kongshyun/2022Capstone-AGV/최종논문 및 보고서/최종 상위 노드통신.jpg

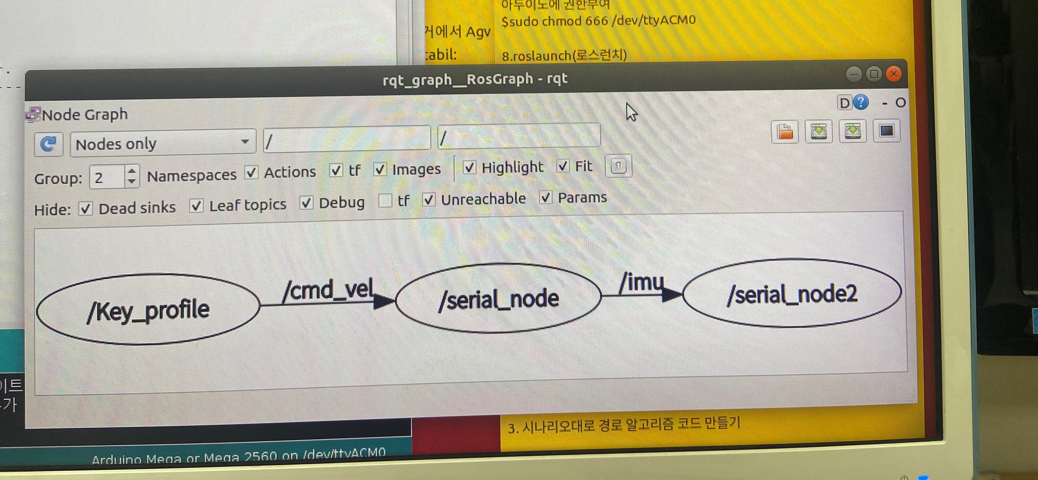
최종논문 및 보고서/최종 상위 노드통신.jpg
