kongshyun/2022Capstone-AGV/README.md

# ROS
1. 로봇운영체제 ROS용어정리
2. 로스 메시지 통신
3. 로스 아두이노 시리얼 통신
4. AGV구동 아두이노 코드
11
해야할것
AGV아두이노에서 imu 롤피치 값이랑 가속도프로파일값을 
다른아두이노로 publish해야  

////////////////////////////////////////////////////////////////////

4차 아두이노 코드 폴더 설명

▶ test1: 
3차때 발표한거에서 Agv DC모터돌리는 코드만 있음

▶ DC_PID_Stabil:
Stabil DC모터+ Imu  짐벌 코드

▶keysendtest: (11.01 성공확인)
practice2 패키지의 Key_profile.py 랑 rosserial되는 코드

▶ebimu_rosserial: (11.01 성공확인)
ebimu의 roll, pitch 두개의 값을 /imu토픽으로 publish 테스트 코드

▶ebimu_sub_tes: (11.01 성공확인) →Serial_node2
ebimu 값  roll, pitch값 subscribe 테스트 코드

▶Agv_imu_test1:  ( 11.01생성 )→Serial_node
Agv  DC모터와 ebimu값을 pub하는 테스트 1 코드

-----------------------------------------------------------------------------------------
roslaunch practice2 Agv_Stabil_key.launch
theta 값 pub하는거랑 Stabil코드 ros만 하면 됨!!!

-11월 1일

-----------------------------------------------------------------------------------------
