kongshyun/2022Capstone-AGV/최종논문 및 보고서, 참고자료/아두이노를 통한 서보모터 제어.pdf

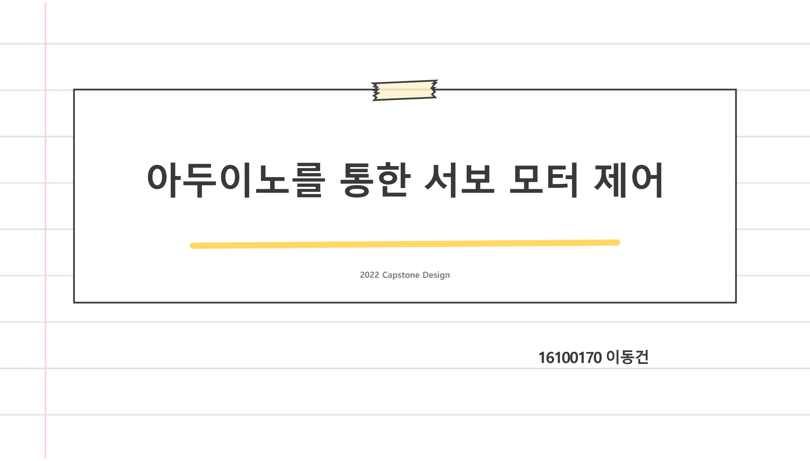
[picture p103: page 1]

# 아두이노를 통한 서보 모터 제어

2022 Capstone Design

16100170 이동건

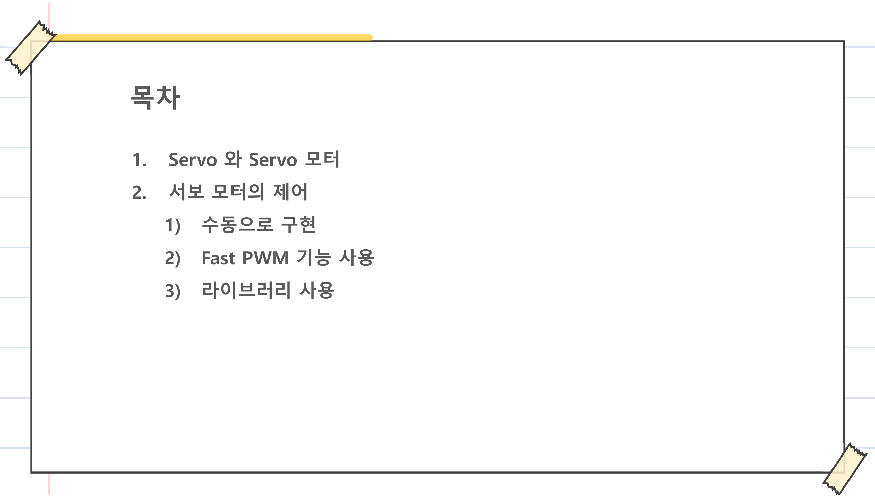
[picture p104: figure]
1. Servo 와 Servo 모터 2. 서보 모터의 제어; 1) 수동으로 구현; 2) Fast PWM 기능 사용 3) 라이브러리 사용

서보

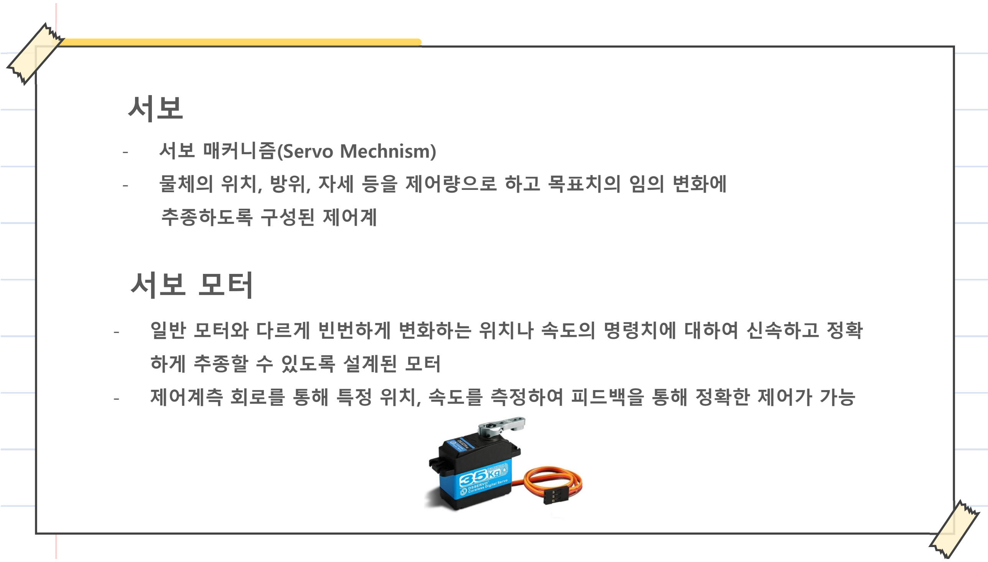
[picture p105: page 3]

추종하도록 구성된 제어계

-서보 매커니즘(Servo Mechnism) -물체의 위치, 방위, 자세 등을 제어량으로 하고 목표치의 임의 변화에

## 서보 모터 - 일반 모터와 다르게 빈번하게 변화하는 위치나 속도의 명령치에 대하여 신속하고 정확

하게 추종할 수 있도록 설계된 모터
- 제어계측 회로를 통해 특정 위치, 속도를 측정하여 피드백을 통해 정확한 제어가 가능

## PWM

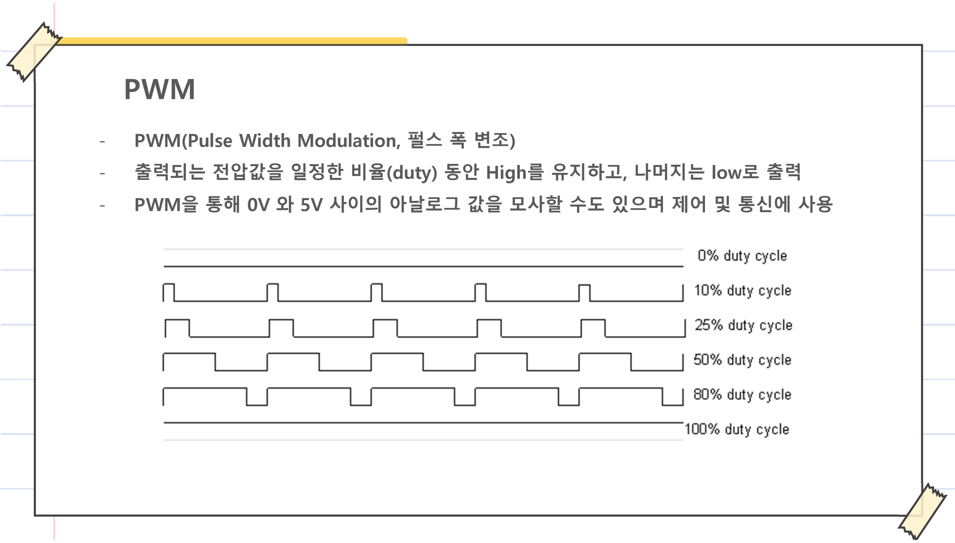
[picture p106: page 4]

-PWM(Pulse Width Modulation, 펄스 폭 변조) -출력되는 전압값을 일정한 비율(duty) 동안 High를 유지하고, 나머지는 low로 출력

- PWM을 통해 0V 와 5V 사이의 아날로그 값을 모사할 수도 있으며 제어 및 통신에 사용

## 서보 모터 제어

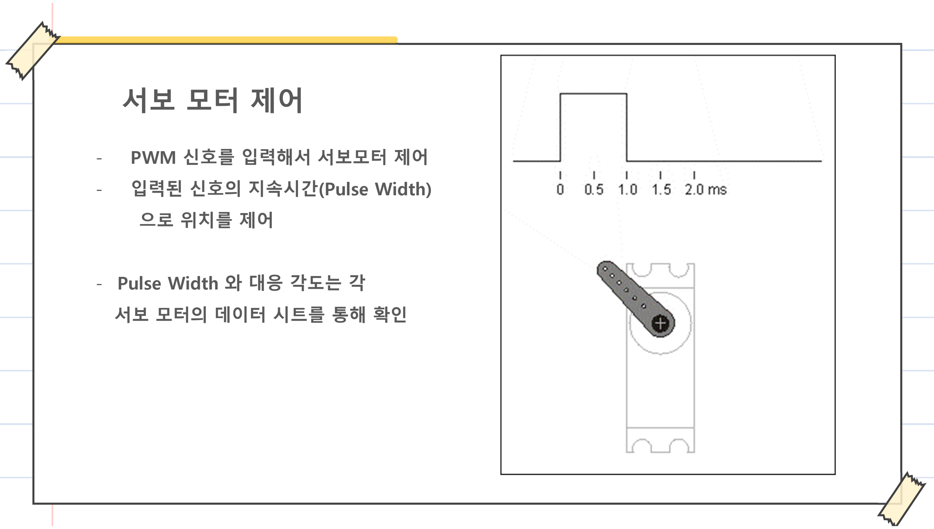
[picture p107: page 5]

- 입력된 신호의 지속시간(Pulse Width) 으로 위치를 제어
- Pulse Width 와 대응 각도는 각 서보 모터의 데이터 시트를 통해 확인
- PWM 신호를 입력해서 서보모터 제어

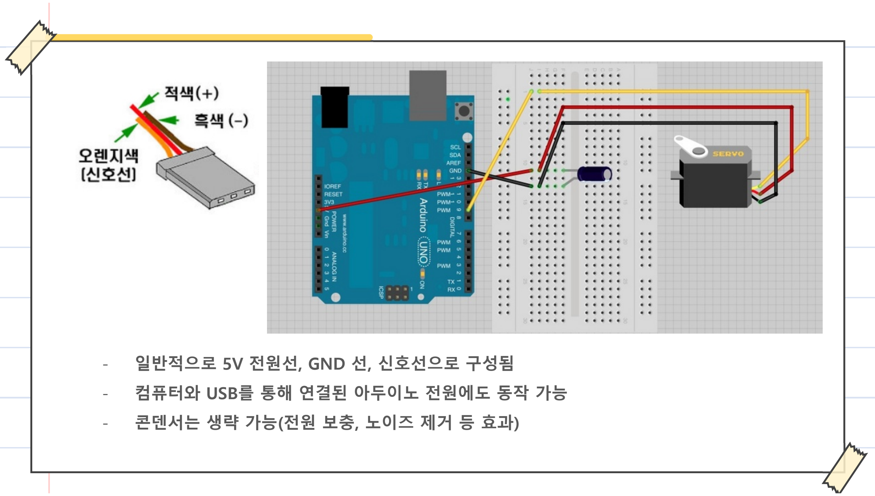
[picture p108: page 6]

- 일반적으로 5V 전원선, GND 선, 신호선으로 구성됨 - 컴퓨터와 USB를 통해 연결된 아두이노 전원에도 동작 가능
- 콘덴서는 생략 가능(전원 보충, 노이즈 제거 등 효과)

## 1. PWM 을 수동으로 구현

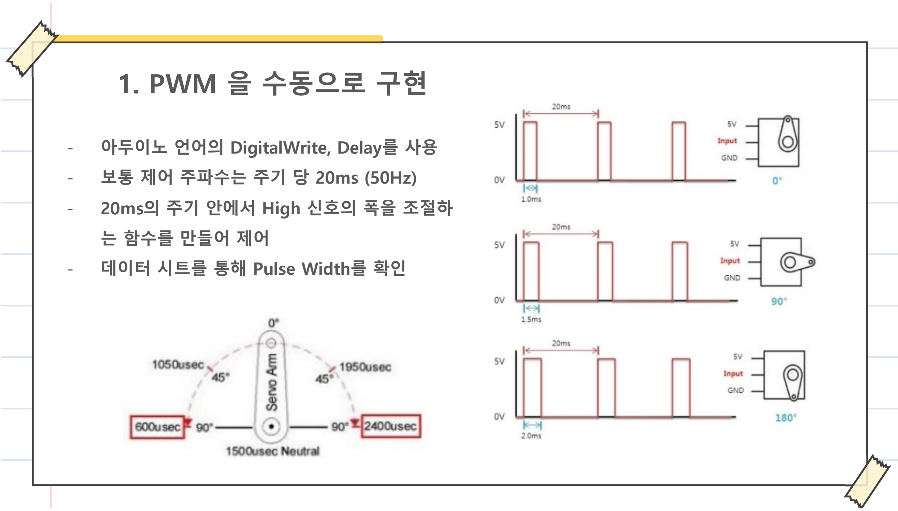
[picture p109: page 7]

- 아두이노 언어의 DigitalWrite, Delay를 사용

-보통 제어 주파수는 주기 당 20ms (50Hz) -20ms의 주기 안에서 High 신호의 폭을 조절하

는 함수를 만들어 제어

- 데이터 시트를 통해 Pulse Width를 확인

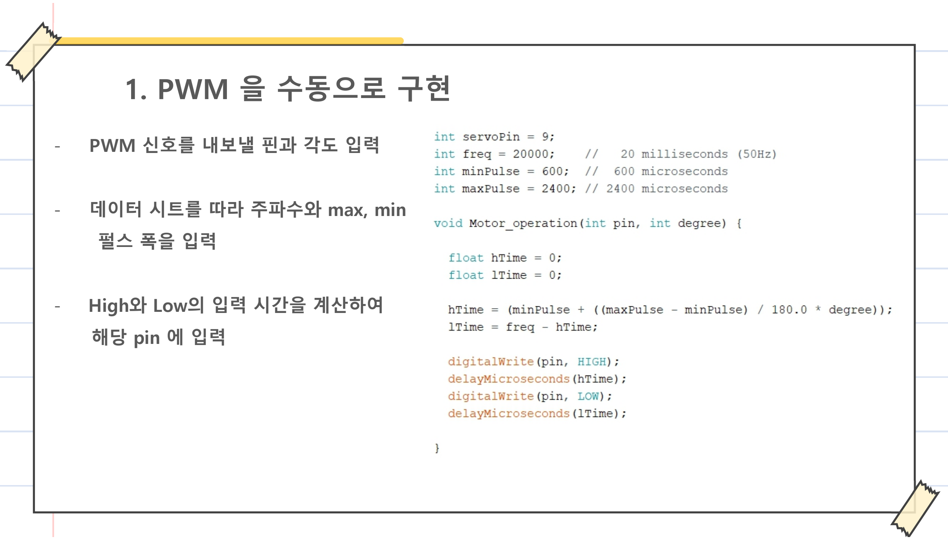
[picture p110: figure]
1. PWM 을 수동으로 구현; - PWM 신호를 내보낼 핀과 각도 입력; - 데이터 시트를 따라 주파수와 max, min; - High와 Low의 입력 시간을 계산하여; 해당 pin 에 입력

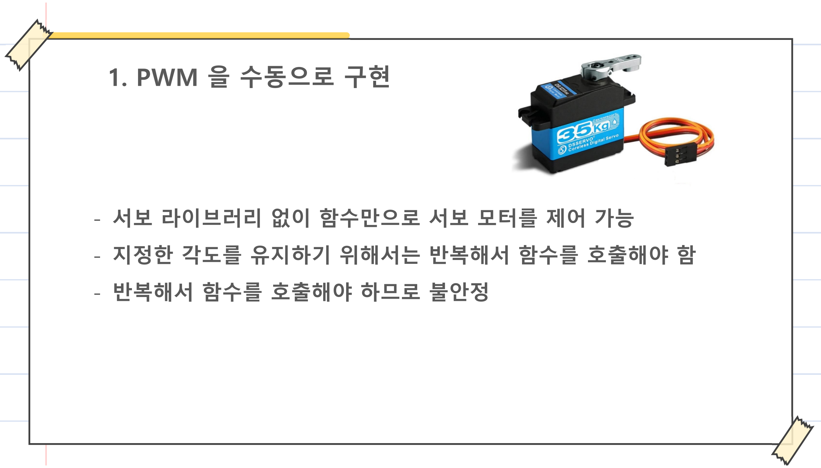
[picture p111: figure]
1. PWM 을 수동으로 구현; - 서보 라이브러리 없이 함수만으로 서보 모터를 제어 가능; - 지정한 각도를 유지하기 위해서는 반복해서 함수를 호출해야 함; - 반복해서 함수를 호출해야 하므로 불안정

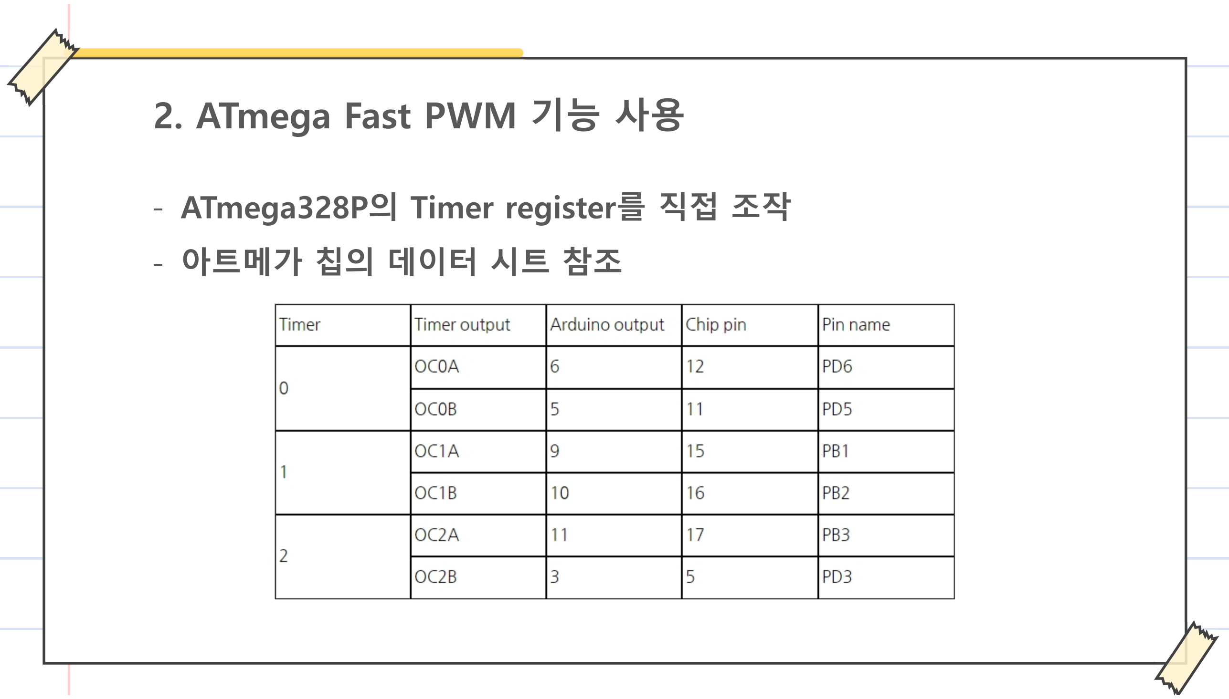
[picture p112: figure]
2. ATmega Fast PWM 기능 사용; - ATmega328P의 Timer register를 직접 조작; - 아트메가 칩의 데이터 시트 참조

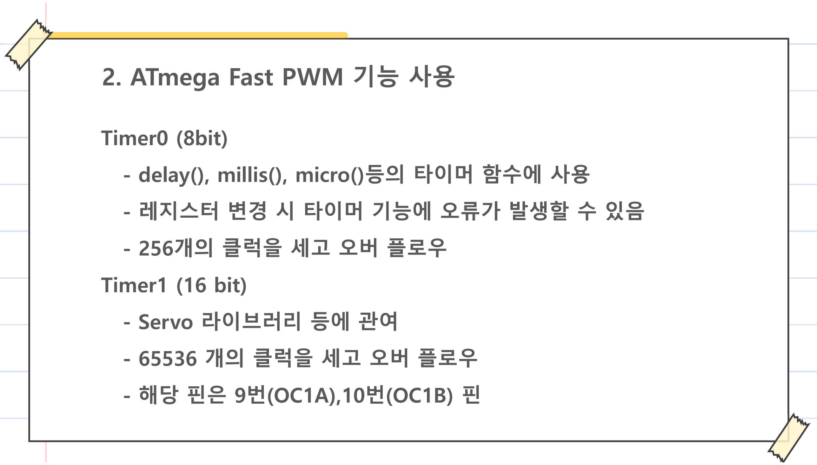
[picture p113: figure]
2. ATmega Fast PWM 기능 사용; - 레지스터 변경 시 타이머 기능에 오류가 발생할 수 있음; - 256개의 클럭을 세고 오버 플로우; Timer1 (16 bit) - Servo 라이브러리 등에 관여; - 65536 개의 클럭을 세고 오버 플로우

## Timer0 (8bit) - delay(), millis(), micro()등의 타이머 함수에 사용

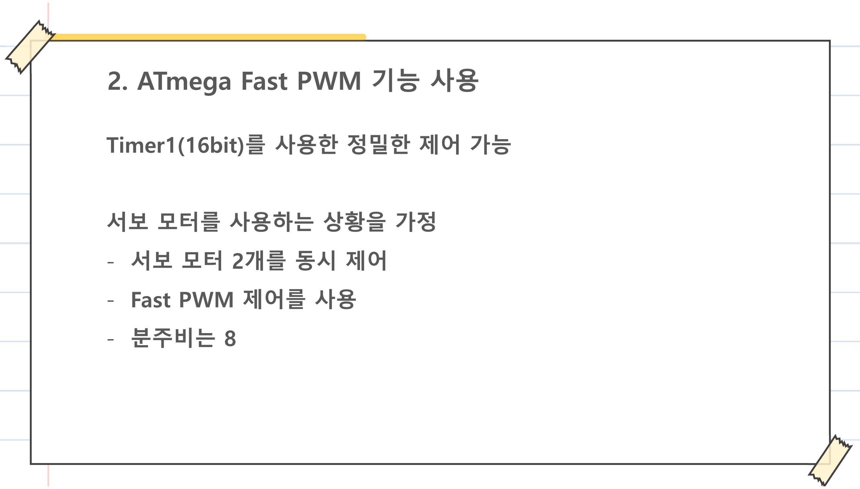
[picture p114: figure]
2. ATmega Fast PWM 기능 사용; Timer1(16bit)를 사용한 정밀한 제어 가능; 서보 모터를 사용하는 상황을 가정; - Fast PWM 제어를 사용 - 분주비는 8

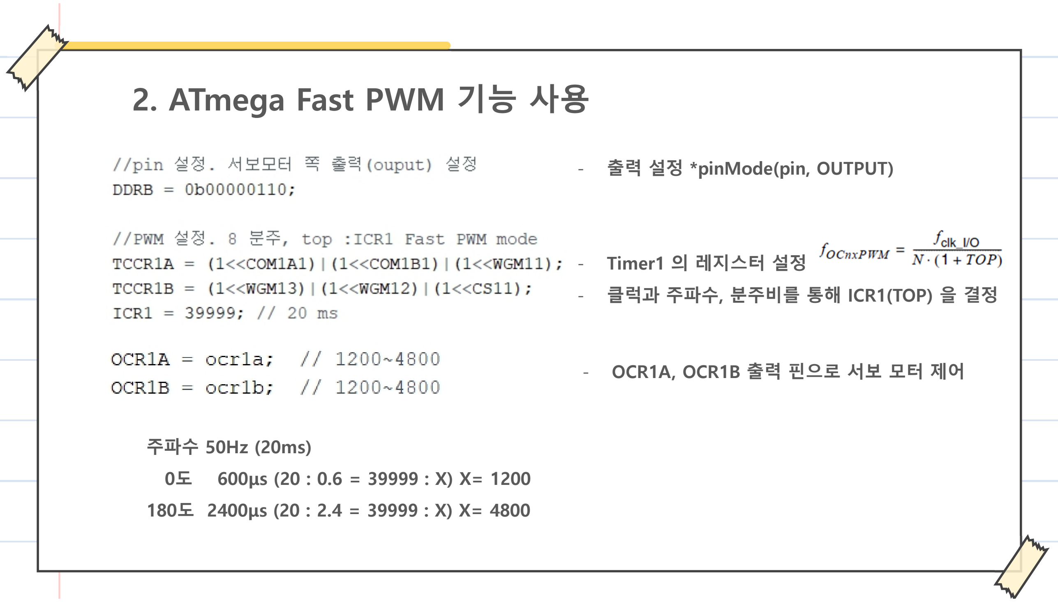
[picture p115: figure]
2. ATmega Fast PWM 기능 사용; - 출력 설정 *pinMode(pin, OUTPUT); - Timer1 의 레지스터 설정; - 클럭과 주파수, 분주비를 통해 ICR1(TOP) 을 결정; - OCR1A, OCR1B 출력 핀으로 서보 모터 제어

주파수 50Hz (20ms) 0도 600μs (20 : 0.6 = 39999 : X) X= 1200

180도 2400μs (20 : 2.4 = 39999 : X) X= 4800

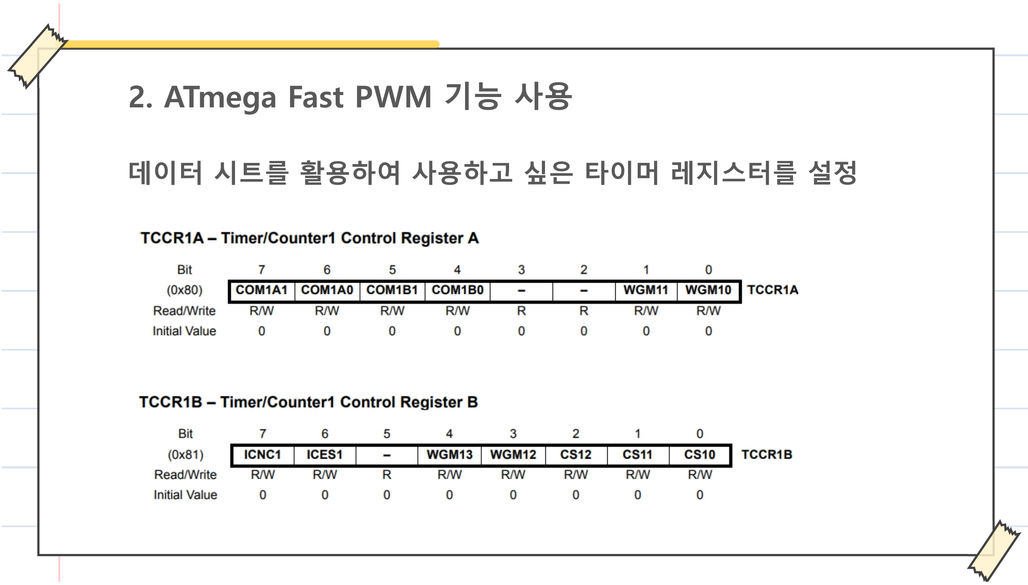
[picture p116: figure]
2. ATmega Fast PWM 기능 사용; 데이터 시트를 활용하여 사용하고 싶은 타이머 레지스터를 설정

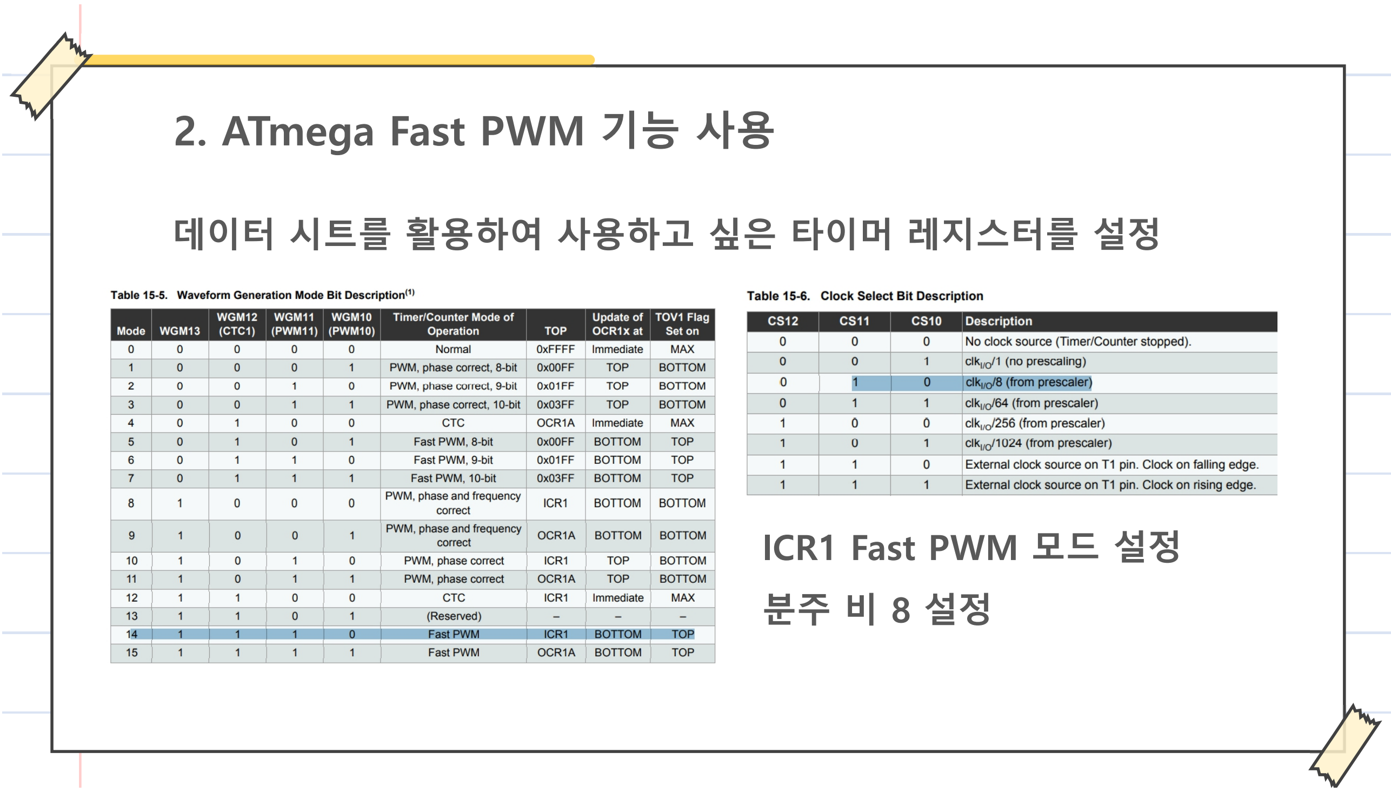
[picture p117: figure]
2. ATmega Fast PWM 기능 사용; 데이터 시트를 활용하여 사용하고 싶은 타이머 레지스터를 설정; ICR1 Fast PWM 모드 설정

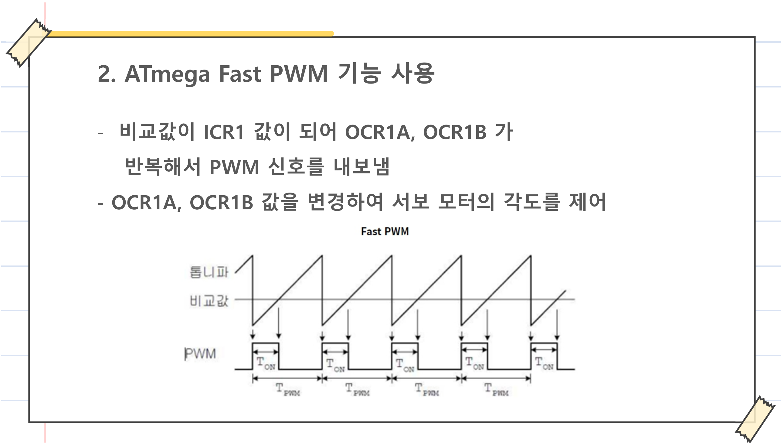
[picture p118: figure]
2. ATmega Fast PWM 기능 사용; - 비교값이 ICR1 값이 되어 OCR1A, OCR1B 가; 반복해서 PWM 신호를 내보냄; - OCR1A, OCR1B 값을 변경하여 서보 모터의 각도를 제어

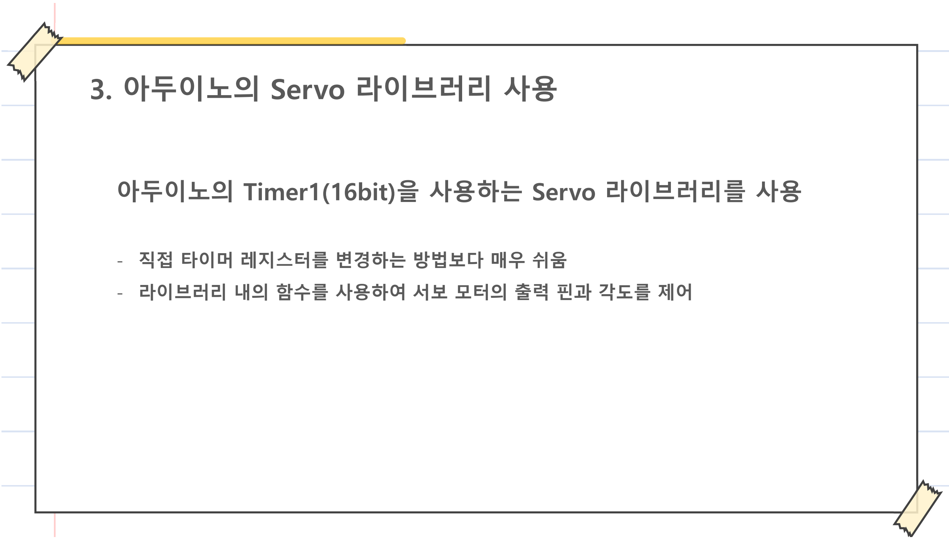
[picture p119: figure]
3. 아두이노의 Servo 라이브러리 사용; - 직접 타이머 레지스터를 변경하는 방법보다 매우 쉬움

## 아두이노의 Timer1(16bit)을 사용하는 Servo 라이브러리를 사용

- 라이브러리 내의 함수를 사용하여 서보 모터의 출력 핀과 각도를 제어

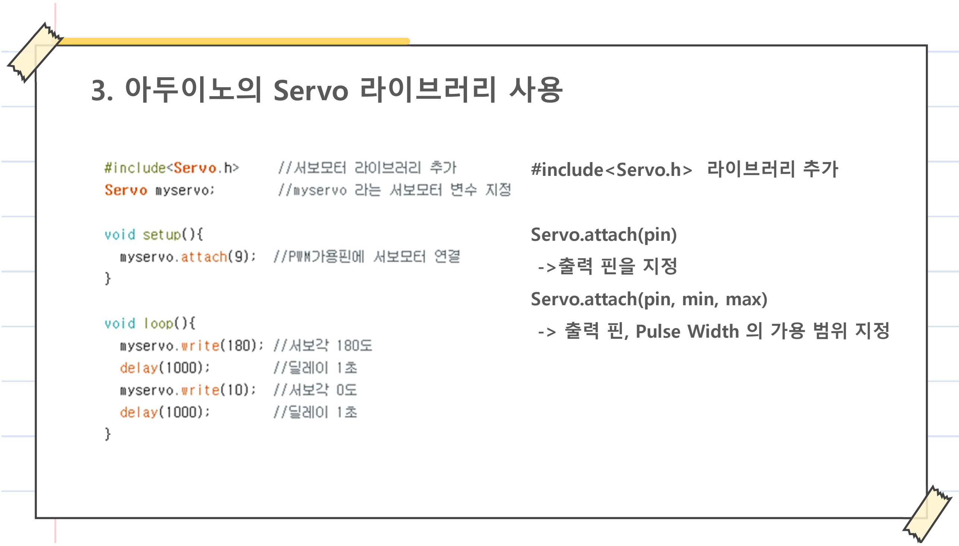
[picture p120: figure]
3. 아두이노의 Servo 라이브러리 사용; #include<Servo.h> 라이브러리 추가; Servo.attach(pin) ->출력 핀을 지정

Servo.attach(pin, min, max) -> 출력 핀, Pulse Width 의 가용 범위 지정

## 3. 아두이노의 Servo 라이브러리 사용

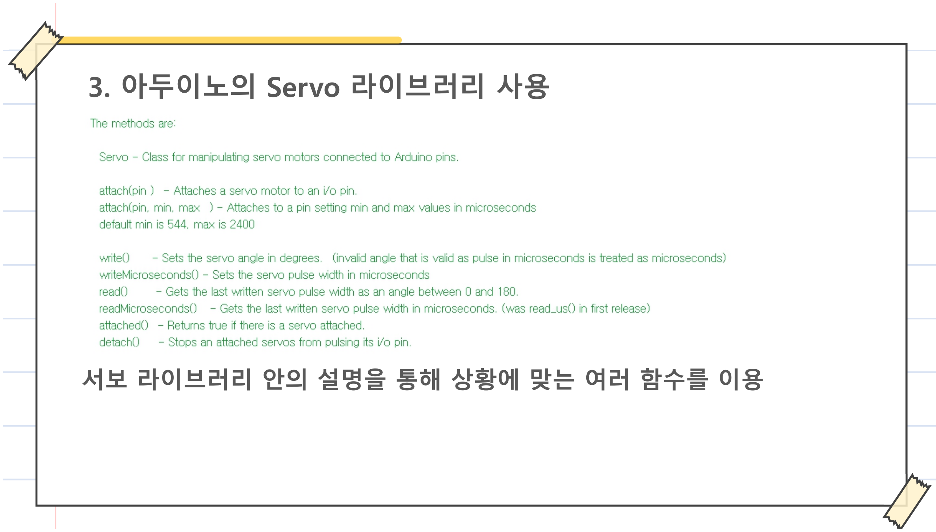
[picture p121: page 19]

## 서보 라이브러리 안의 설명을 통해 상황에 맞는 여러 함수를 이용

## 3. 아두이노의 Servo 라이브러리 사용

Pin의 기본 값이 min 544, max 2400 microseconds로 지정되어 있으므로

사용할 서보 모터의 사양에 따라 attach(pin, min, max)로 설정값을 변경

## 3. 아두이노의 Servo 라이브러리 사용

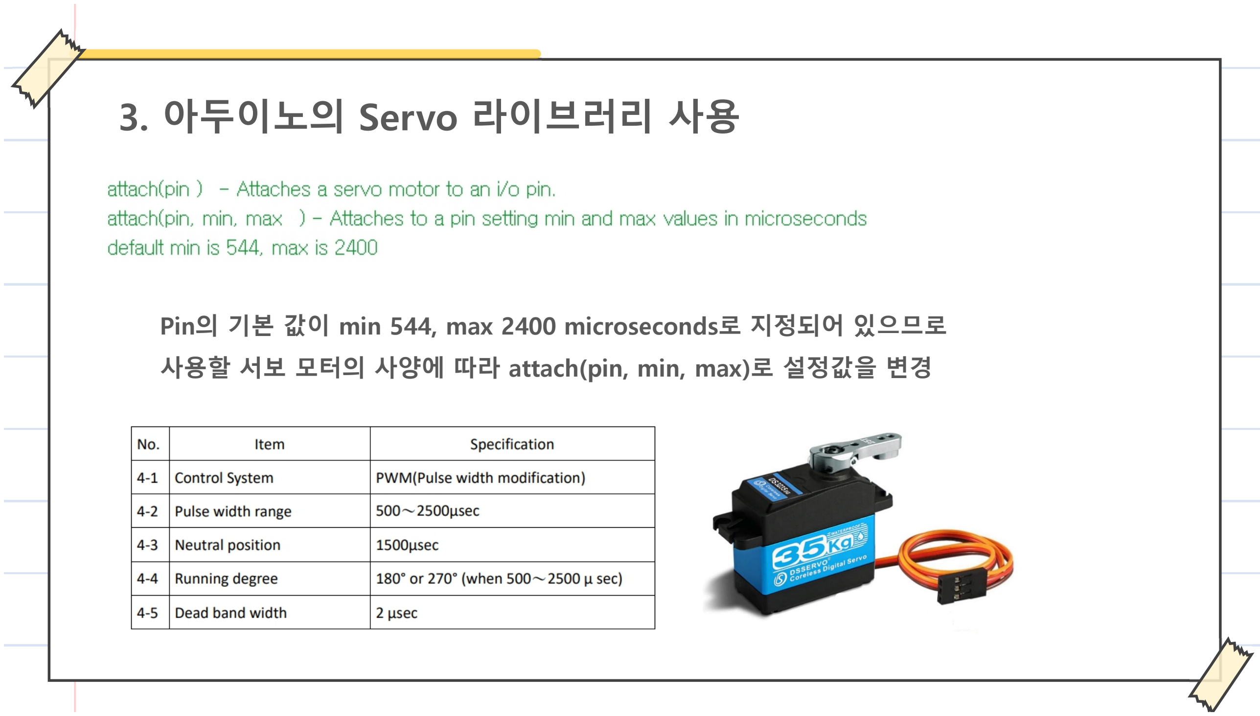
[picture p122: page 21]

Pin의 기본 값이 min 544, max 2400 microseconds로 지정되어 있으므로

사용할 서보 모터의 사양에 따라 attach(pin, min, max)로 설정값을 변경

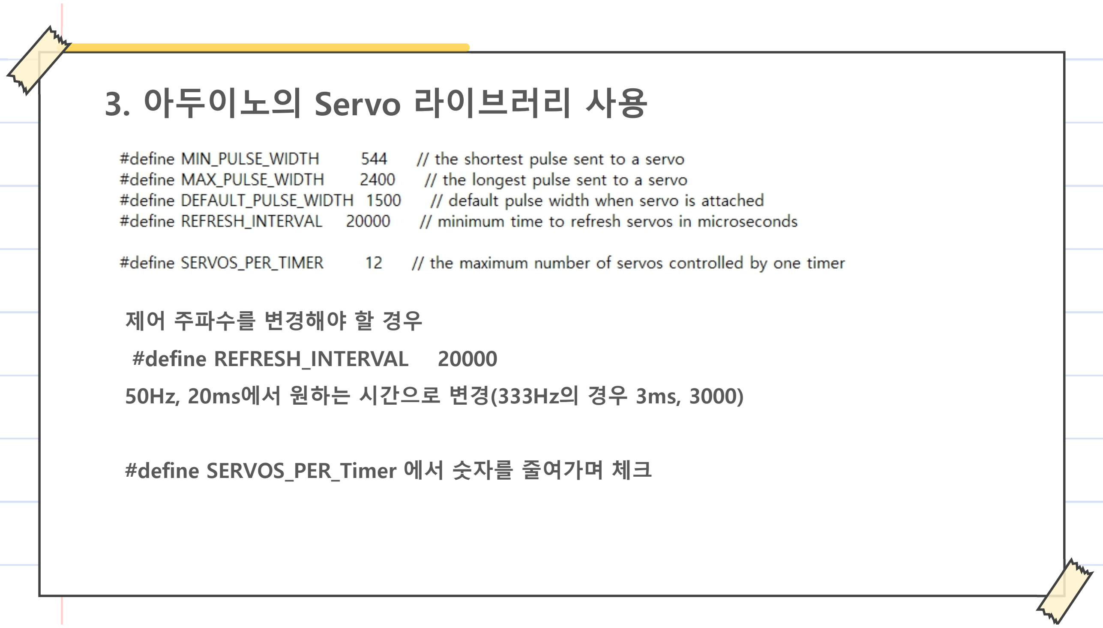
[picture p123: figure]
3. 아두이노의 Servo 라이브러리 사용

제어 주파수를 변경해야 할 경우 #define REFRESH_INTERVAL 20000

50Hz, 20ms에서 원하는 시간으로 변경(333Hz의 경우 3ms, 3000)

#define SERVOS_PER_Timer 에서 숫자를 줄여가며 체크

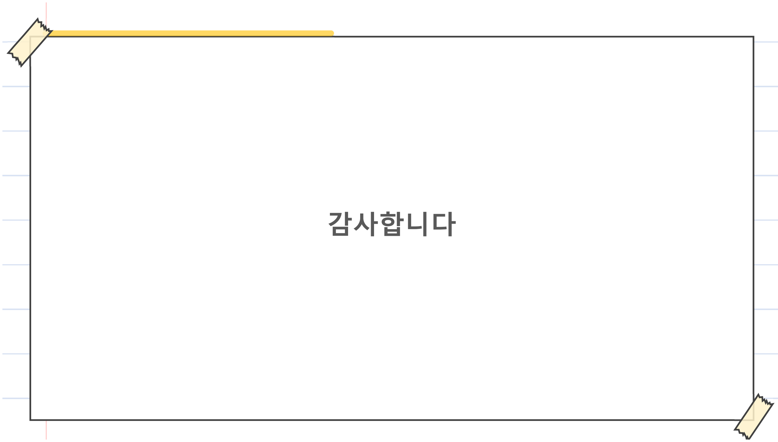
[picture p124: figure]
감사합니다
