kongshyun/2022Capstone-AGV/last_year/ros-seminar-master/08_로봇_센서_모터.pdf

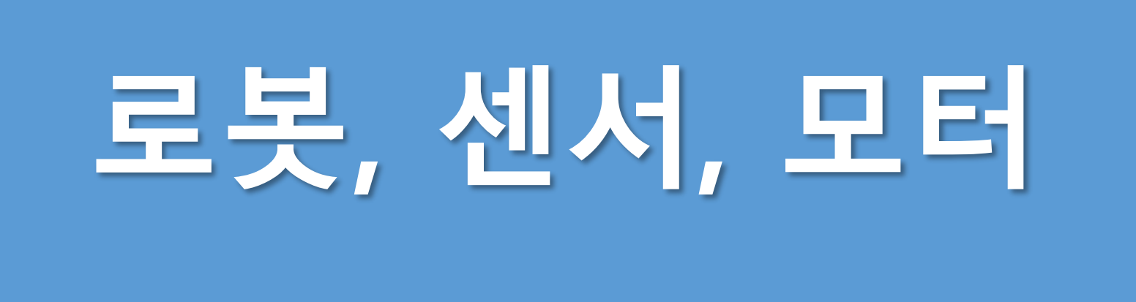
[picture p126: figure]
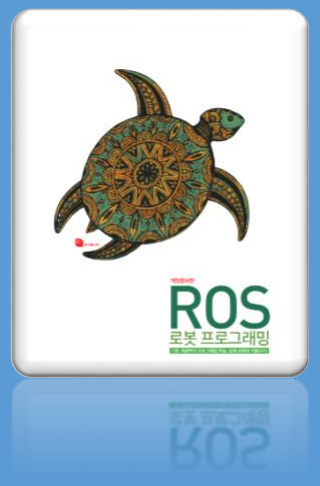
[picture p127: figure]

Yoonseok Pyo

Open Source Team

교재
P. 204~243 (http://book.naver.com/bookdb/book_detail.nhn?bid=12443870)

온라인강좌 (https://www.youtube.com/playlist?list=PLRG6WP3c31_VIFtFAxSke2NG_DumVZPgw)

# Contents

## I. 로봇 패키지

# II. 센서 패키지

## III. 카메라 IV. 심도카메라

# V. 레이저 거리 센서

## VI. 모터 패키지

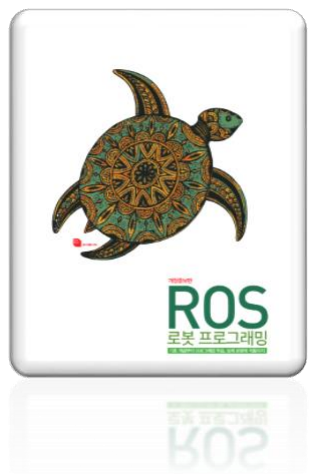
[picture p128: figure]

# VII.다이나믹셀 VIII.공개 패키지 사용법

교재
P. 204~243 (http://book.naver.com/bookdb/book_detail.nhn?bid=12443870)

온라인강좌 (https://www.youtube.com/playlist?list=PLRG6WP3c31_VIFtFAxSke2NG_DumVZPgw)

# 로봇 패키지

# 로봇 패키지 (http://robots.ros.org/)

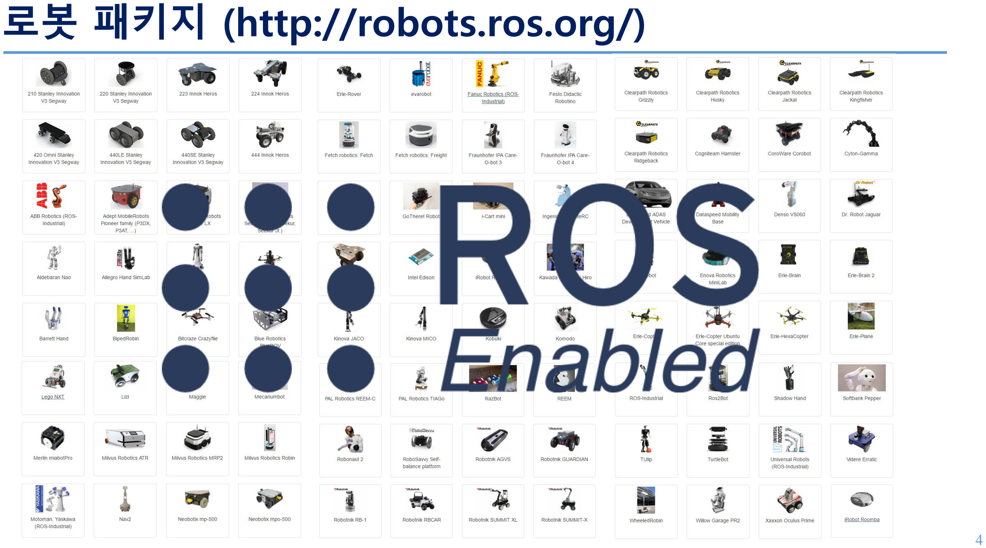
[picture p129: page 4]

# 센서 패키지

# 센서 패키지 (http://wiki.ros.org/Sensors)

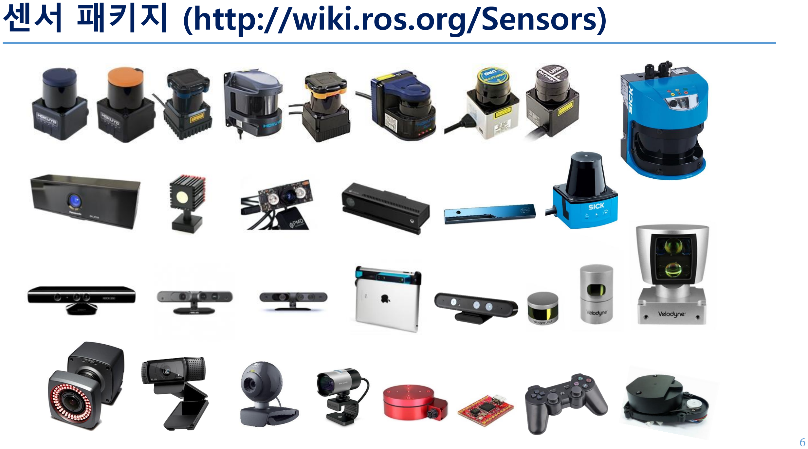
[picture p130: page 6]

# 센서 패키지의 종류

## - 1D Range Finders

## - 저가의 로봇을 만들 때 사용할만한 적외선 방식의 직선거리 센서

## - 2D Range Finders

## - 2차 평면상의 거리를 계측할 수 있는 센서로 주로 내비게이션에 많이 사용되는 센서

## - 3D Sensors

### - Intel 사의 RealSense, Microsoft 사의 Kinect, ASUS 사의 Xtion과 같은 3차원 거리 측정에 사

## 용되는 센서

## - Audio/Speech Recognition

## - 현재 음성인식 관련 부분은 매우 적지만, 지속해서 추가될 것으로 보임

## - Cameras

## - 물체인식, 얼굴인식, 문자판독 등에 많이 사용되는 카메라의 드라이버 및 각종 응용 패키지

## - Sensor Interfaces

## - USB 및 웹 프로토콜을 지원하는 센서는 매우 적음 - 아직까지도 많은 센서들은 마이크로프로 센서에서 정보를 쉽게 얻을 수 있는 센서가 많음 - 이러한 센서는 마이크로프로세서의 UART 및 미니 PC 계열에서 ROS와의 연결을 지원함

# 실습 시간

‘LRF, IMU, USB Camera,

# Depth Camera, Robot Model 을 RViz를 통해 확인해보자.’

# 나눠 드린 센서들을

각자 PC의 RViz를 이용해 데이터를 확인해보세요.

# 오늘의 실습 준비물

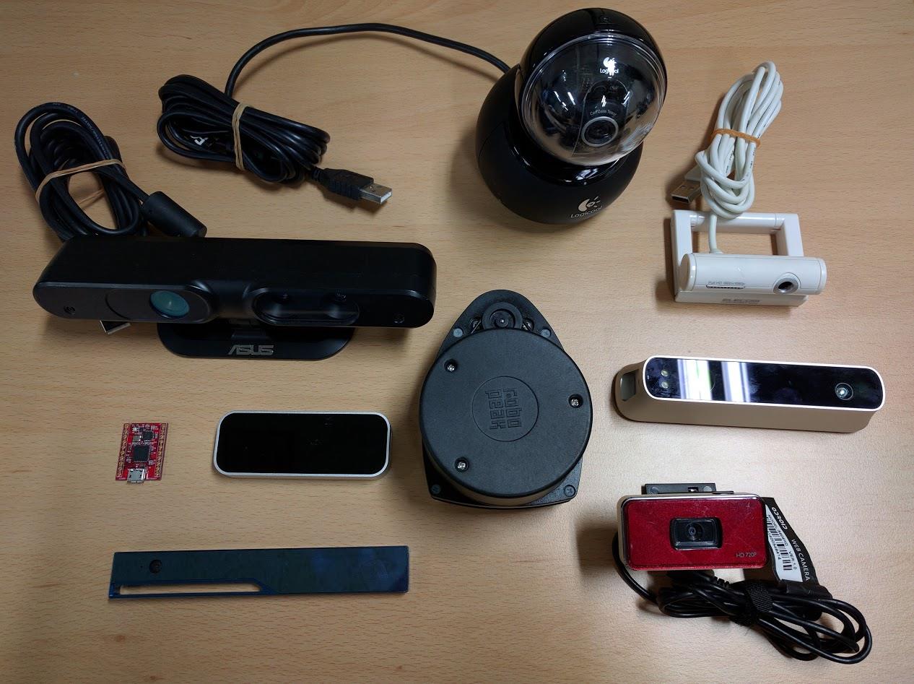
[picture p131: figure]

# 센서 패키지 실습 #1 (USB Camera)

$ sudo apt install ros-kinetic-uvc-camera

$ rosrun uvc_camera uvc_camera_node
$ rosrun uvc_camera uvc_camera_node _device:=/dev/video?

$ rosrun image_view image_view image:=/image_raw
$ rqt_image_view image:=/image_raw
$ rviz

* RViz의 Displays 옵션 변경
1) Fixed Frame 변경

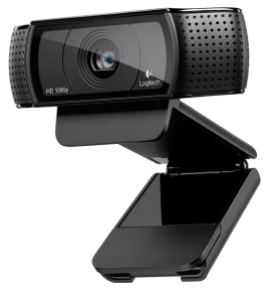
[picture p132: figure]
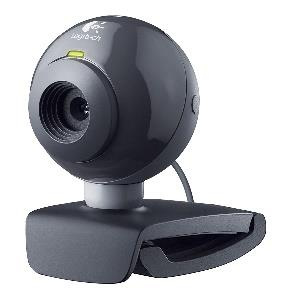
[picture p133: figure]

Global Options > Fixed Frame = camera
2) 이미지 디스플레이 추가
rviz 좌측 하단의 Add 클릭한 후, Image 선택하여 추가한다.

(Add > by display > rviz > Image)
3) 토픽 값 변경
Image > Image Topic 의 값을 "/image_raw" 로 변경한다.

카메라가 2대 이상일 경우,
물음표 대신 사용하기 원하는
디바이스 번호를 입력 (특히, 노트북의 경우)

이미지 메시지를 보는 3가지 방법

# 센서 패키지 실습 #1 (USB Camera)

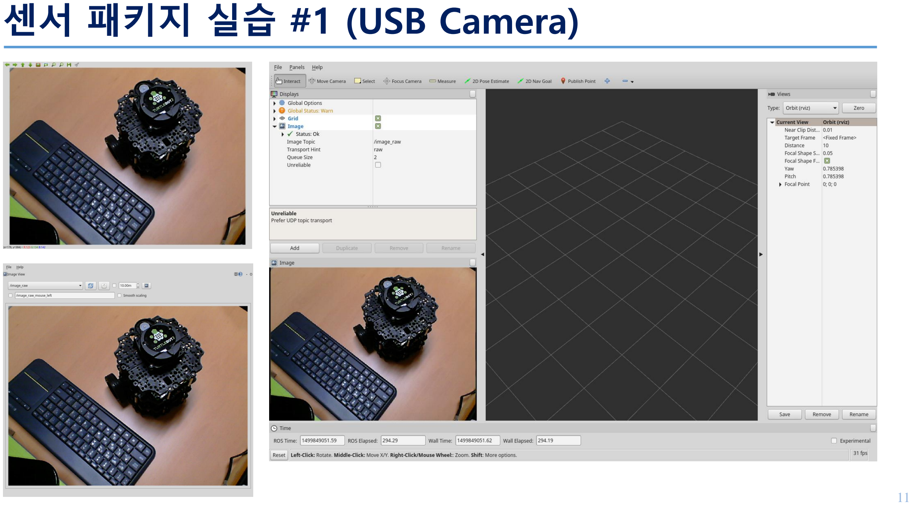
[picture p134: page 11]

# 센서 패키지 실습 #2 (원격으로 이미지 전송)

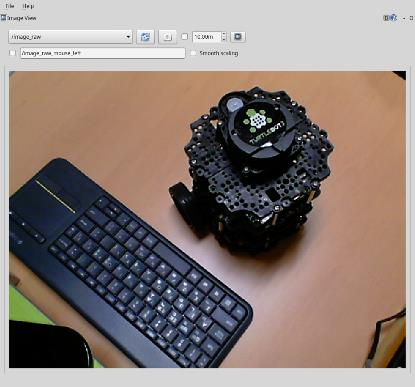
[picture p135: figure]
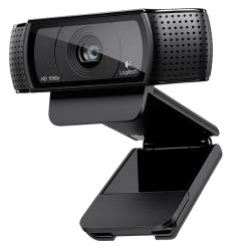
[picture p136: figure]
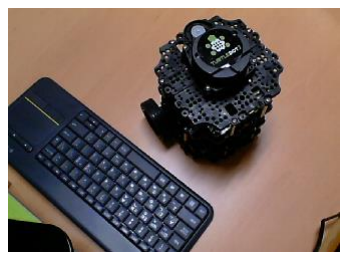
[picture p137: figure]
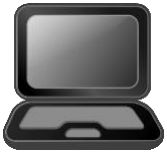
[picture p138: figure]

## - 각 PC의 ~/.bashrc 파일 수정 (ROS_MASTER_URI 및 ROS_HOSTNAME)

## - Remote PC에서 roscore 및 rqt_image_view image:=/image_raw 실행

## - Sensor PC에서 rosrun uvc_camera uvc_camera_node 실행

ROS_MASTER_URI = http://IP_OF_REMOTE_PC:11311ROS_HOSTNAME = IP_OF_SENSOR_PC

ROS_MASTER_URI = http://IP_OF_REMOTE_PC:11311ROS_HOSTNAME = IP_OF_REMOTE_PC
* ROS Master 를 Remote PC에서 구동했을 때의 예제
Sensor PC | Remote PC

# 센서 패키지 실습 #3 (카메라 캘리브레이션)

$ sudo apt install ros-kinetic-camera-calibration
$ rosrun uvc_camera uvc_camera_node
$ rosrun camera_calibration cameracalibrator.py --size 8x6 --square 0.024 image:=/image_raw camera:=/camera

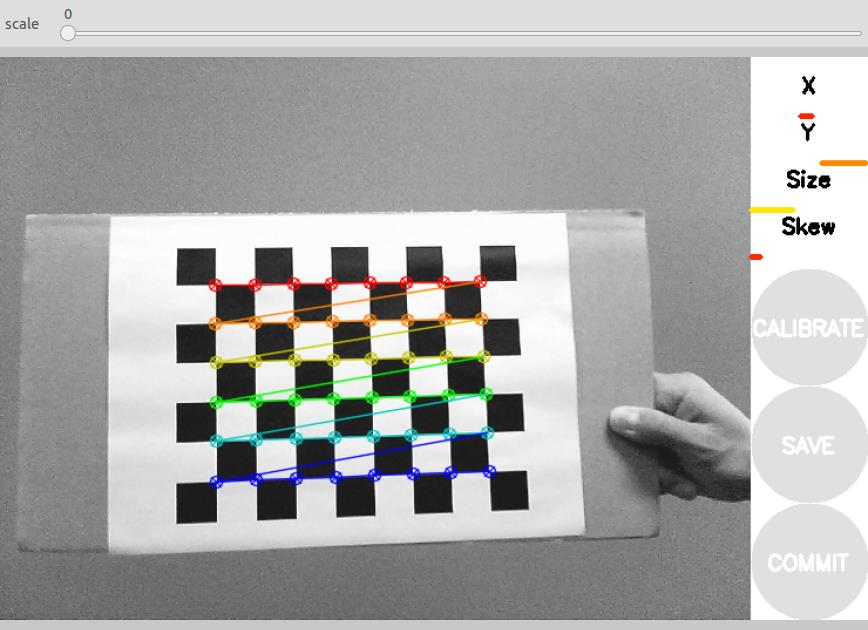
[picture p139: figure]

# 센서 패키지 실습 #4 (Depth Camera)

$ sudo apt install ros-kinetic-openni2-camera ros-kinetic-openni2-launch
$ tar -xvf Sensor-Bin-Linux-x64-v5.1.0.41.tar.bz2
$ cd Sensor-Bin-Linux-x64-v5.1.0.41/
$ sudo sh install.sh
$ roslaunch openni2_launch openni2.launch

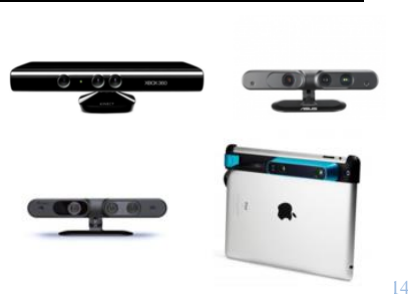
[picture p140: figure]

* RViz의 Displays 옵션 변경

1) Fixed Frame 변경
Global Options > Fixed Frame 을 "camera_depth_frame" 로 변경한다.
2) PointCloud2 추가 및 설정
rviz 좌측 하단의 Add 클릭한 후, PointCloud2를 선택하여 추가한다.
3) Topic 이름 및 세부 설정 변경

(*Xtion 구매시 CD안에 있음 또는 http://cafe.naver.com/openrt/6070)

(ASUS사의 Xtion의 경우)

$ sudo apt install ros-kinetic-astra-camera ros-kinetic-astra-launch
$ wget https://raw.githubusercontent.com/tfoote/ros_astra_camera/master/orbbec-usb.rules $ wget https://raw.githubusercontent.com/tfoote/ros_astra_camera/master/install.sh
$ sudo sh ./install.sh
$ roslaunch astra_launch astra.launch

(ASTRA의 경우)

# 센서 패키지 실습 #4 (Depth Camera)

## $ sudo apt install ros-kinetic-librealsense ros-kinetic-realsense-camera $ roslaunch realsense_camera r200_nodelet_default.launch $ rosrun rviz rviz -d rviz/realsenseRvizConfiguration1.rviz

* RViz의 Displays 옵션 변경

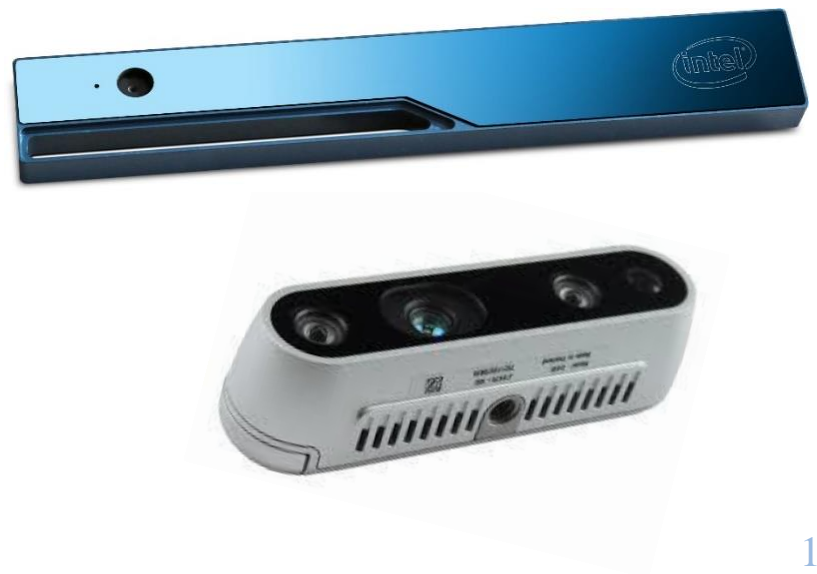
[picture p141: figure]

1) Fixed Frame 변경
Global Options > Fixed Frame 을 "camera_depth_frame" 로 변경한다.
2) PointCloud2 추가 및 설정
rviz 좌측 하단의 Add 클릭한 후, PointCloud2를 선택하여 추가한다.
3) Topic 이름 및 세부 설정 변경

(RealSense의 경우)

RealSense D400 시리즈의 경우 아래 위키 참조
- http://wiki.ros.org/librealsense2
- http://wiki.ros.org/realsense2_camera

# 센서 패키지 실습 #4 (Depth Camera)

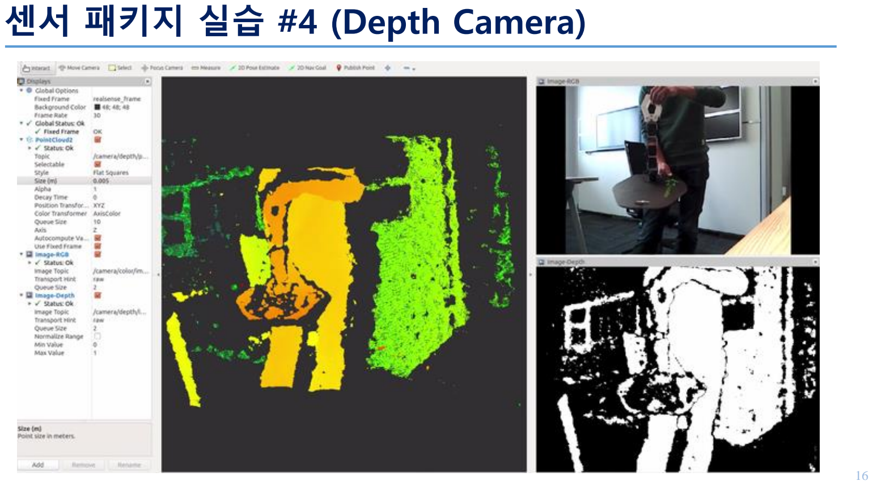
[picture p142: page 16]

# 센서 패키지 실습 #5 (Stereo Camera)

$ sudo apt install libv4l-dev libudev-dev ros-kinetic-rtabmap*
$ cd ~/catkin_ws/src/
$ svn export https://github.com/withrobot/oCam/trunk/Software/oCamS_ROS_Package/ocams
$ cd ~/catkin_ws/ && catkin_make
$ sudo gedit /etc/udev/rules.d/99-ttyacms.rules
ATTRS{idVendor}=="04b4" ATTRS{idProduct}=="00f9", MODE="0666", ENV{ID_MM_DEVICE_IGNORE}="1" ATTRS{idVendor}=="04b4" ATTRS{idProduct}=="00f8", MODE="0666", ENV{ID_MM_DEVICE_IGNORE}="1" $ sudo udevadm control --reload-rules
$ roslaunch ocams pointcloud.launch
(oCam-Stereo의 경우)

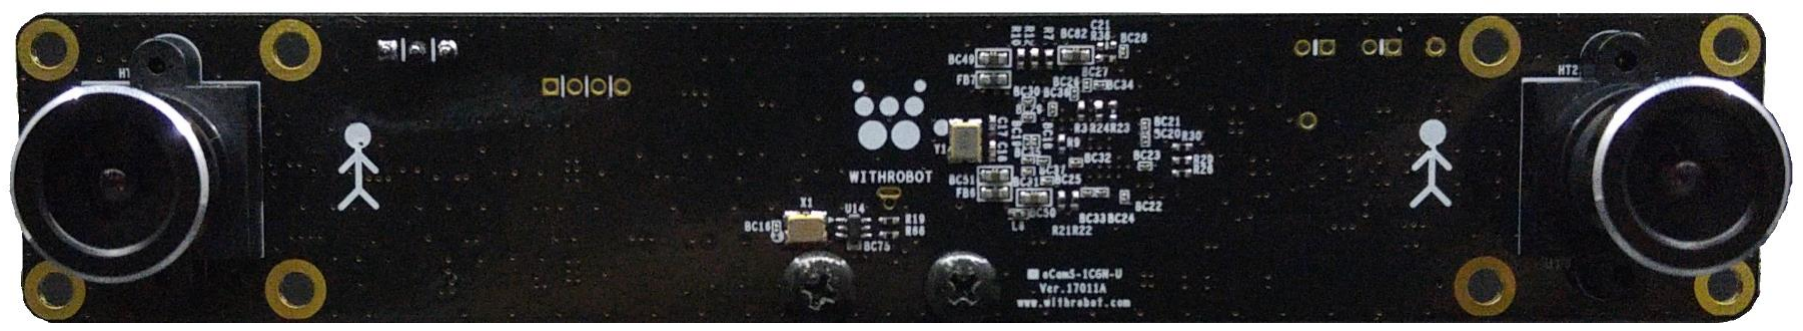
[picture p143: figure]

https://github.com/withrobot/oCam/tree/master/Products/oCamS-1CGN-U

# 센서 패키지 실습 #6 (LDS)

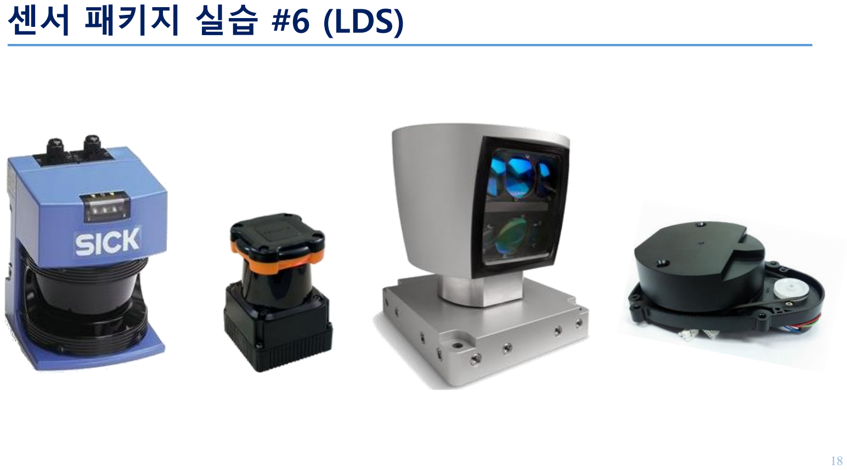
[picture p144: page 18]

# 센서 패키지 실습 #6 (LDS)

* RViz의 Displays 옵션 변경
1) Fixed Frame 변경: | Global Options > Fixed Frame = laser
2) Axes 추가 및 설정: | rviz 좌측 하단의 Add 클릭한 후, Axes 선택하여 추가한다. (Length 및 Radius 변경은 옵션)
3) LaserScan 추가 및 설정: | rviz 좌측 하단의 Add 클릭한 후, LaserScan 선택하여 추가한다.
| (Topic 지정은 필수, Color Transformer, Color 등은 옵션)

$ cs
$ git clone https://github.com/robopeak/rplidar_ros.git $ cm
$ sudo chmod a+rw /dev/ttyUSB0
$ roslaunch rplidar_ros rplidar.launch

$ sudo apt install ros-kinetic-urg-node $ sudo chmod a+rw /dev/ttyACM0 $ rosrun urg_node urg_node

(RPLiDAR의 경우)

(HOKUYO의 경우)

$ cs
$ git clone https://github.com/ROBOTIS-GIT/hls_lfcd_lds_driver.git $ cm
$ sudo chmod a+rw /dev/ttyUSB0
$ roslaunch hls_lfcd_lds_driver view_hlds_laser.launch

(LDS의 경우)

# 센서 패키지 실습 #6 (LDS)

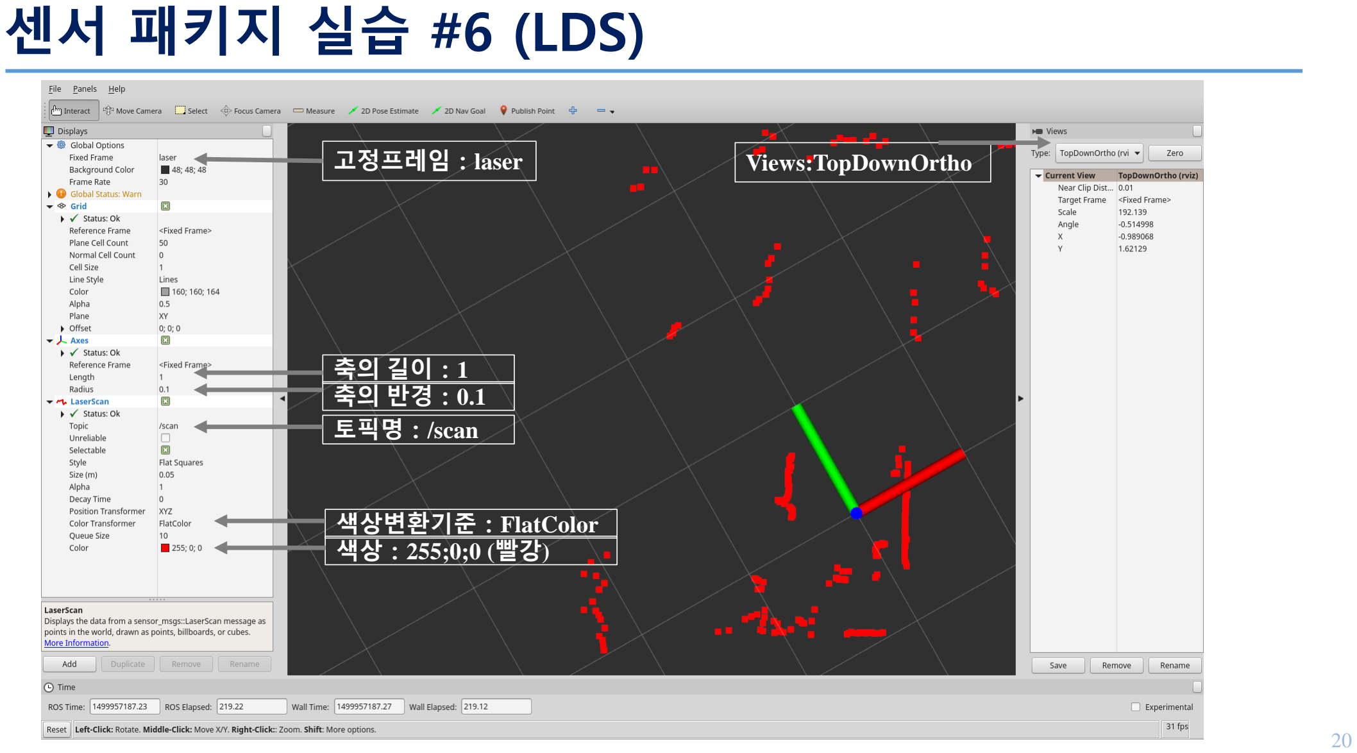
[picture p145: page 20]

고정프레임：laser

축의 길이：1
축의 반경：0.1
토픽명：/scan

색상변환기준：FlatColor
색상：255;0;0 (빨강)

Views:TopDownOrtho

# 센서 패키지 실습 #7 (IMU)

$ cs
$ git clone https://github.com/robotpilot/myahrs_driver.git $ cm
$ sudo chmod a+rw /dev/ttyACM0
$ roslaunch myahrs_driver myahrs_driver.launch

(withrobot사의 myAHRS+)

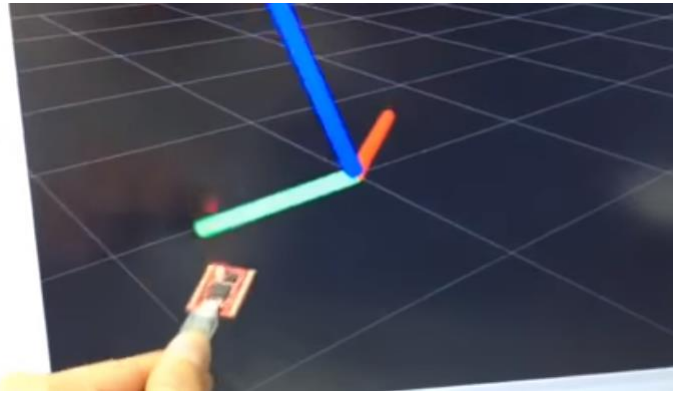
[picture p146: figure]

# 모터 패키지

## - PhidgetMotorControl HC - Roboteq AX2550 Motor Controller

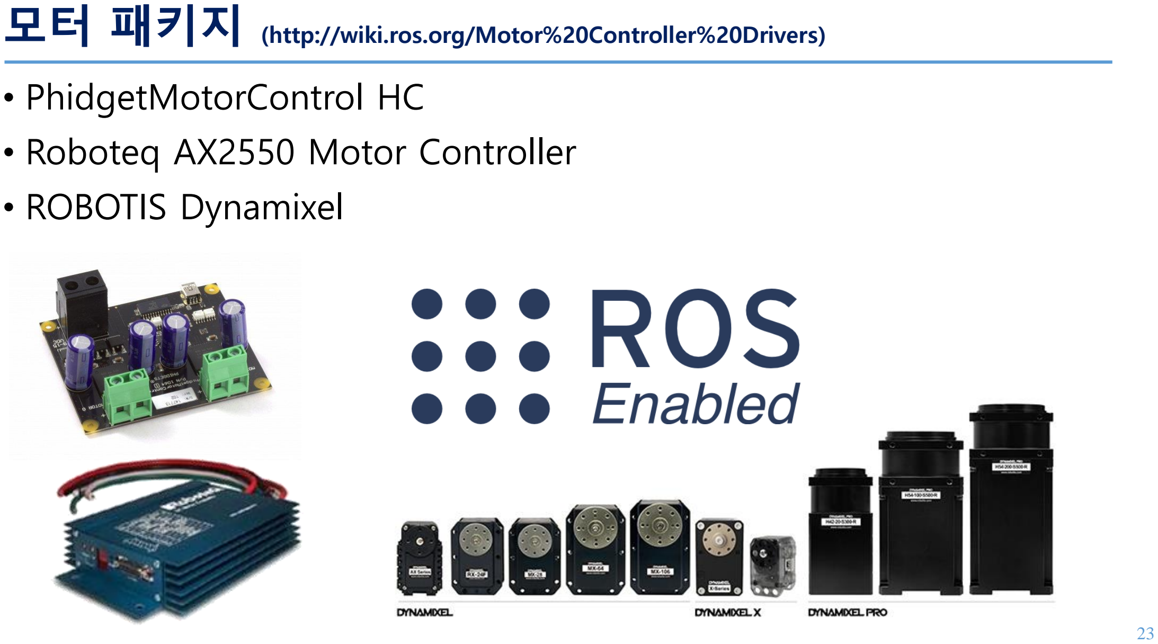
[picture p147: page 23]

## - ROBOTIS Dynamixel

모터 패키지 (http://wiki.ros.org/Motor%20Controller%20Drivers)

# ROS 패키지를 이용하여 다이나믹셀 제어하기

## - DynamixelSDK (http://wiki.ros.org/dynamixel_sdk)

## - 3대 OS지원 (Linux, Windows, MacOS) - C, C++, C#, Python, Java, MATLAB, LabVIEW 등의 프로그래밍 언어 지원 - ROS 지원

## - dynamixel_workbench (http://wiki.ros.org/dynamixel_workbench)

## - ROS에서 사용하기 쉽도록 다양한 예제 제공

## - ROS 대응 GUI 툴 제공

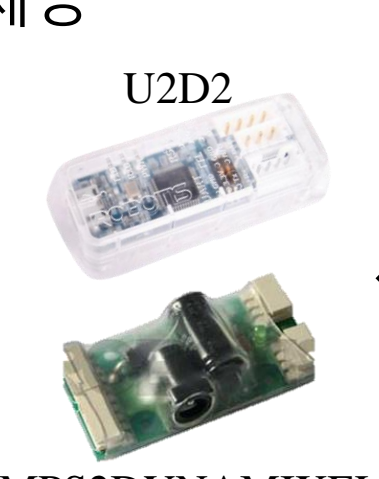
[picture p148: figure]
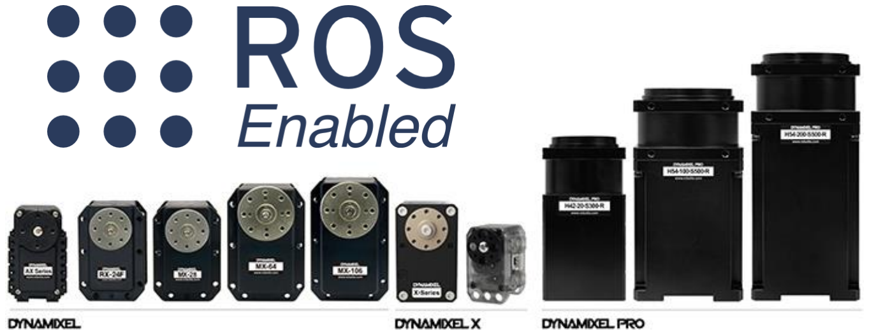
[picture p149: figure]

SMPS2DYNAMIXEL | Dynamixel

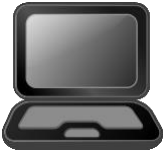
[picture p150: figure]

질문

# 대환영!

# * 온라인 상의 질문이라면 오로카 및 로열모를 이용해주세요!

# 여기서! 광고 하나 나가요~

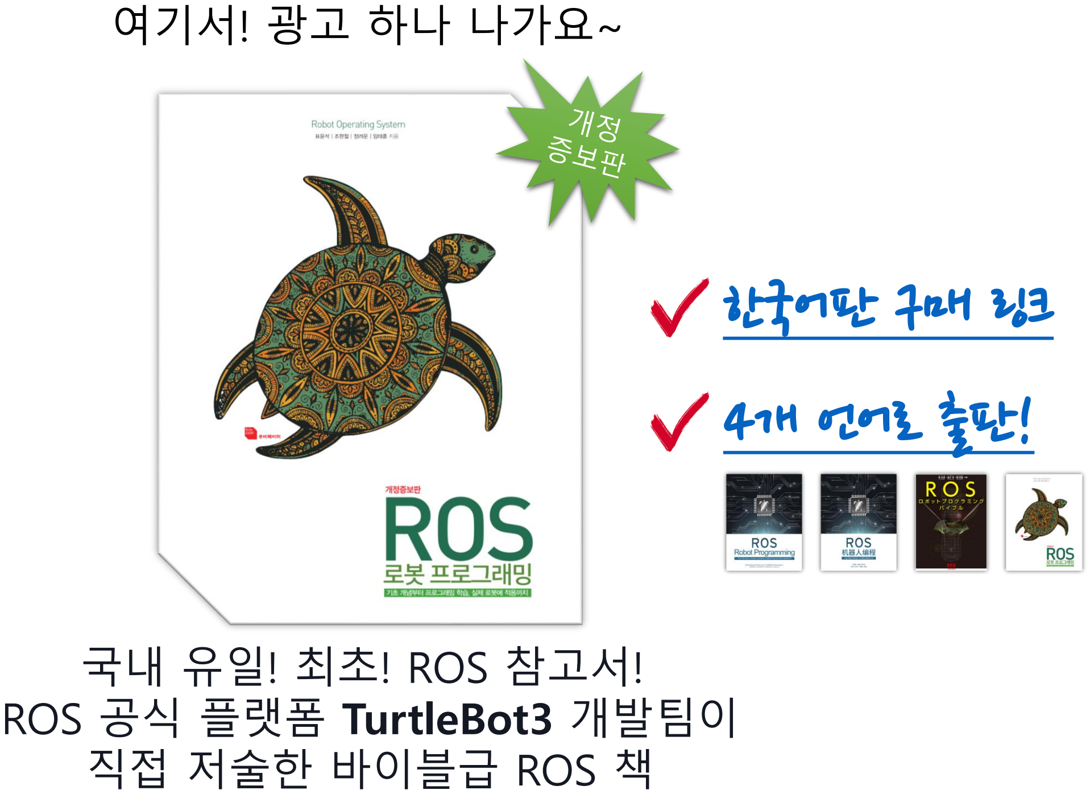
[picture p151: page 26]

## 국내 유일! 최초! ROS 참고서! ROS 공식 플랫폼 TurtleBot3 개발팀이

# 직접 저술한 바이블급 ROS 책

# 한국어판 구매 링크 (http://book.naver.com/bookdb/book_detail.nhn?bid=12443870)

# 4개 언어로 출판! (http://emanual.robotis.com/docs/en/platform/turtlebot3/learn/#books)

# 여기서! 광고 둘 나가요~

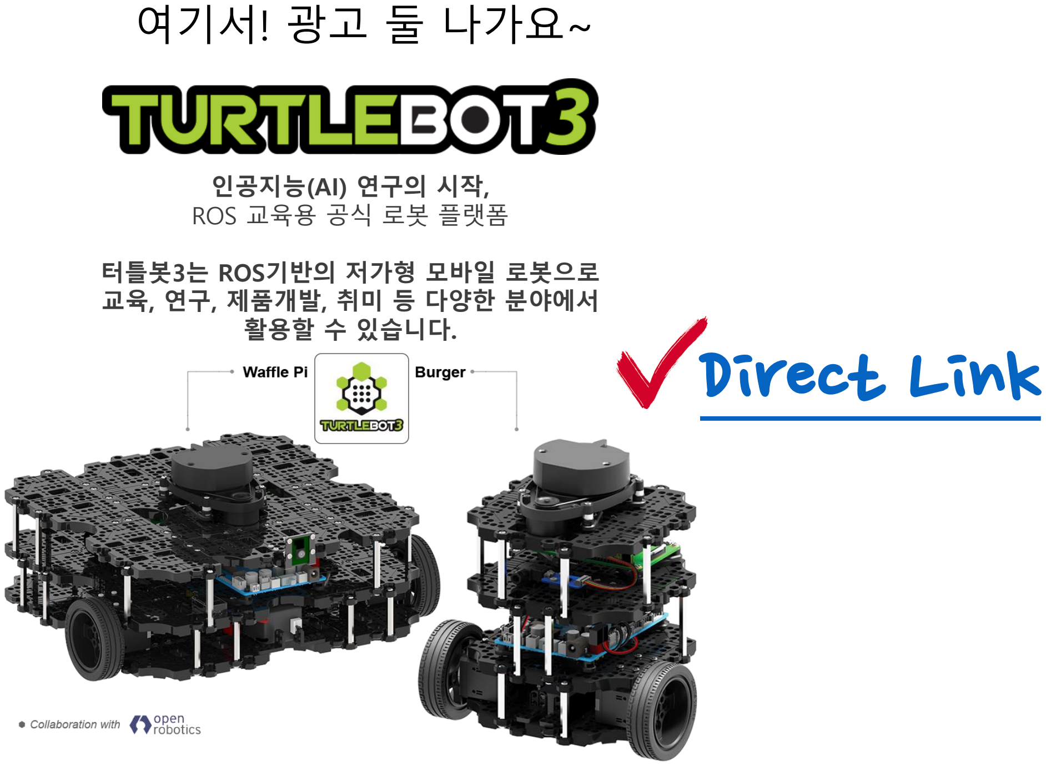
[picture p152: page 27]

# Direct Link (http://www.robotis.com/model/board.php?bo_table=print&wr_id=36)

인공지능(AI) 연구의 시작,
ROS 교육용 공식 로봇 플랫폼

터틀봇3는 ROS기반의 저가형 모바일 로봇으로
교육, 연구, 제품개발, 취미 등 다양한 분야에서 활용할 수 있습니다.

# 여기서! 광고 셋 나가요~

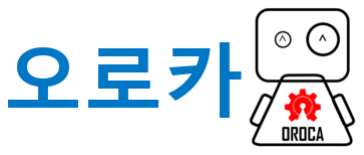
[picture p153: figure]

- 오로카
- www.oroca.org
- 오픈 로보틱스 지향
- 풀뿌리 로봇공학의 저변 활성화
- 공개 강좌, 세미나, 프로젝트 진행

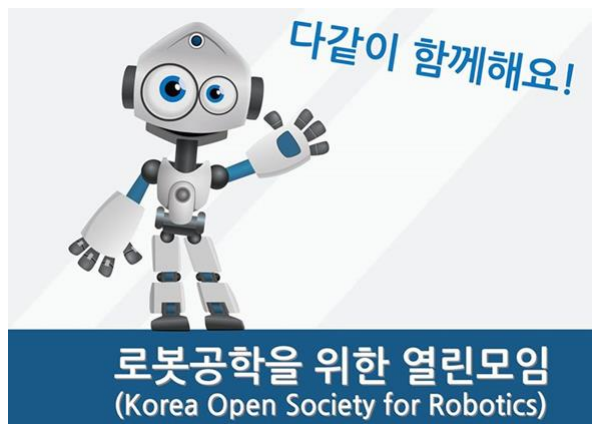
[picture p154: figure]

- 로봇공학을 위한 열린 모임 (KOS-ROBOT)
- www.facebook.com/groups/KoreanRobotics
- 로봇공학 통합 커뮤니티 지향
- 일반인과 전문가가 어울러지는 한마당
- 로봇공학 정보 공유
- 연구자 간의 협력

# 혼자 하기에 답답하시다고요? 커뮤니티에서 함께 해요~

- RobotSource
- www.robotsource.org
- 글로벌 로보틱스 커뮤니티 지향
- 로봇공학 정보 공유
- 자신의 로봇 프로젝트 공유
- DIY 로봇 프로젝트 진행

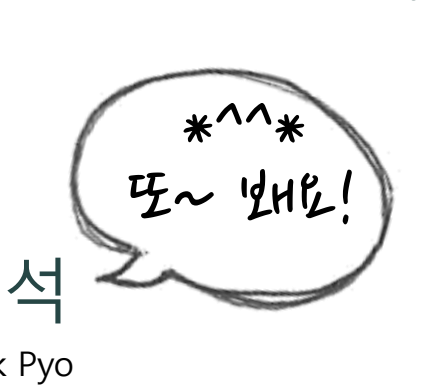
[picture p155: figure]

Yoonseok Pyo
pyo@robotis.com
www.robotpilot.net

## 표윤석

www.facebook.com/yoonseok.pyo

끝.
