kongshyun/2022Capstone-AGV/last_year/ros-seminar-master/Appendix_F_ROS_2의_핵심_특징_3가지.pdf

# The Future of the Robot Operating System

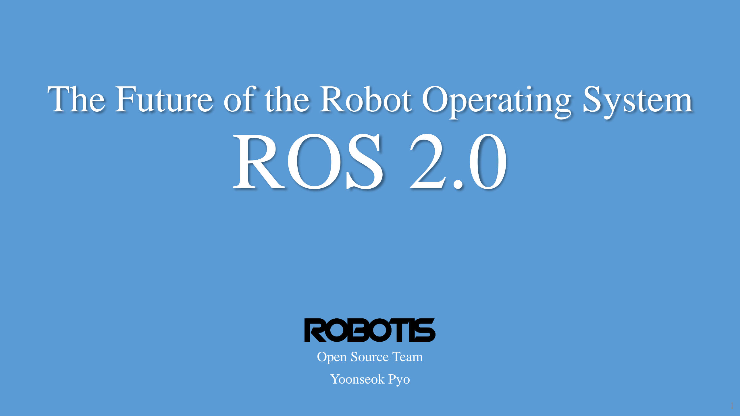
[picture p223: page 1]

Yoonseok Pyo

Open Source Team

# ROS 2.0

# Contents

## I. ROS 2

## II. ROS 2의 대표적인 3가지 기능

### 1. DDS (Data Distribution Service) 2. Real-time Computing 3. Embedded System

## III. ROS 2의 개발 현황

## IV. 미래의 로봇 운영체제가 갖추어야 할 것

# Contents

## I. ROS 2

## II. ROS 2의 대표적인 3가지 기능

### 1. DDS (Data Distribution Service) 2. Real-time Computing 3. Embedded System

## III. ROS 2의 개발 현황

## IV. 미래의 로봇 운영체제가 갖추어야 할 것

# ROSCon2015

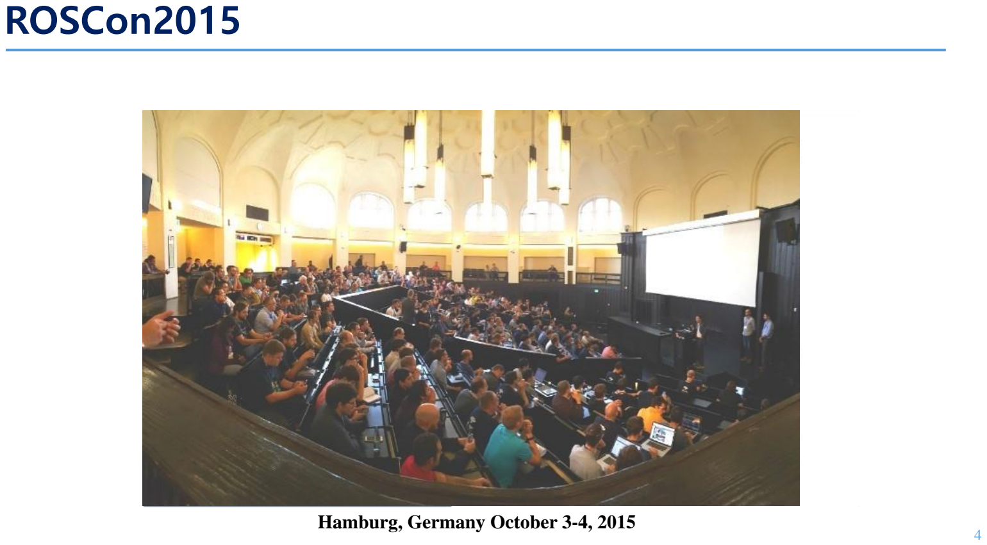
[picture p224: page 4]

Hamburg, Germany October 3-4, 2015

# ROSCon2015

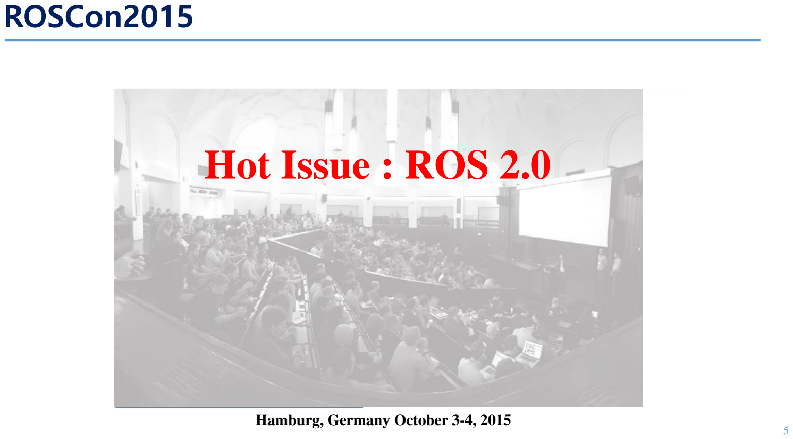
[picture p225: page 5]

# Hot Issue : ROS 2.0

Hamburg, Germany October 3-4, 2015

# Why ROS 2?

## - Multiple robots - Small embedded platforms - Real-time systems - Non-ideal networks - Production environments - Prescribed patterns for building and structuring systems

- New technologies: Zeroconf, Protocol Buffers, ZeroMQ, Redis,

## WebSockets, DDS (Data Distribution Service) - API changes - Risk associated with changing the current ROS system

# Contents

## I. ROS 2

## II. ROS 2의 대표적인 3가지 기능

### 1. DDS (Data Distribution Service) 2. Real-time Computing 3. Embedded System

## III. ROS 2의 개발 현황

## IV. 미래의 로봇 운영체제가 갖추어야 할 것

# ROS 1.x (XMLRPC + TCPROS)

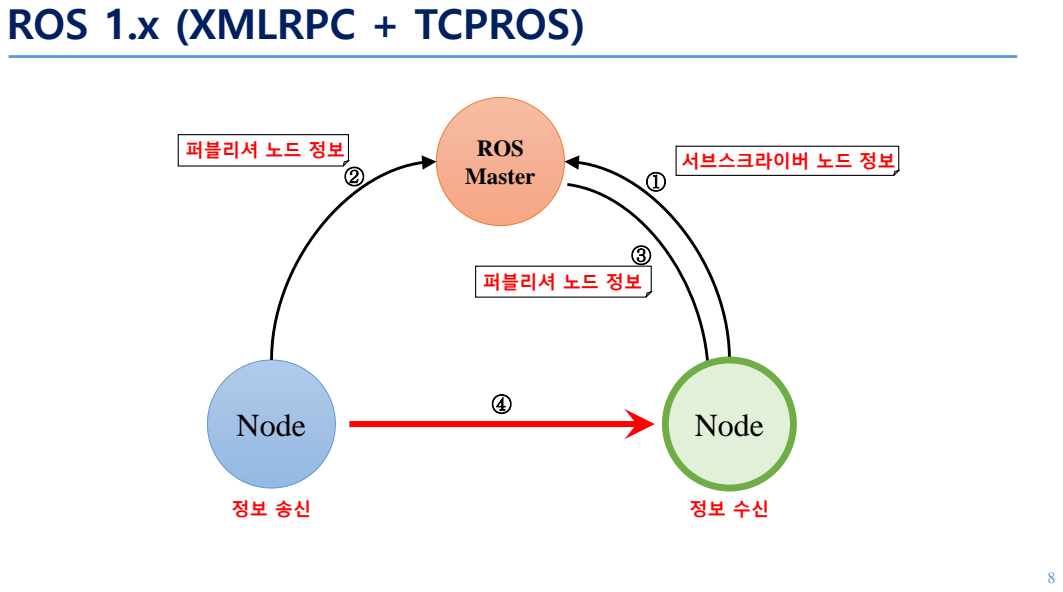
[picture p226: page 8]
ROS Master; Node; 퍼블리셔 노드 정보; 서브스크라이버 노드 정보

퍼블리셔 노드 정보

# ROS 1.x (XMLRPC + TCPROS)

## XMLRPC

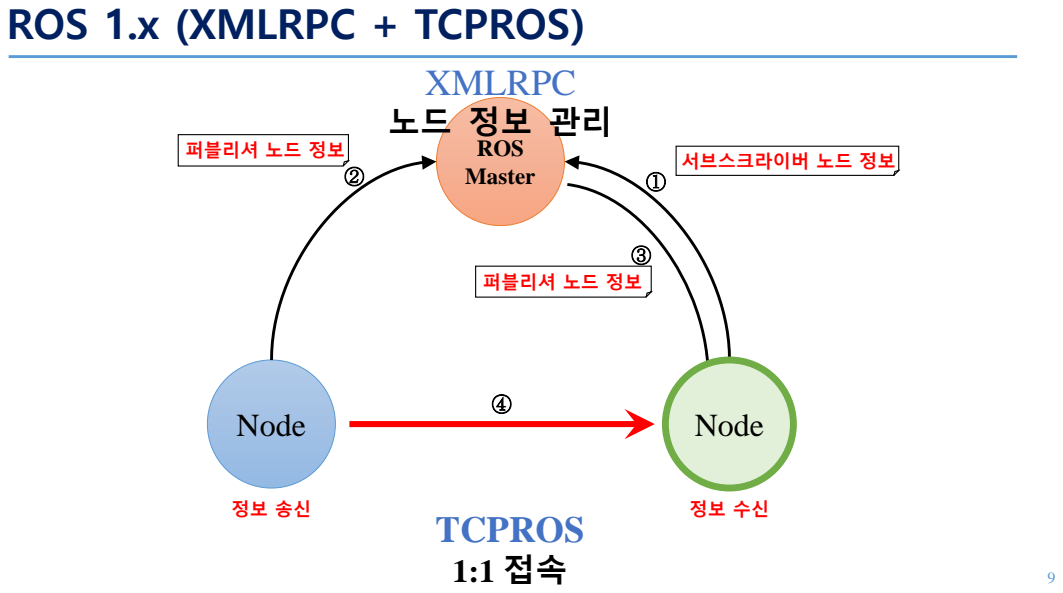
[picture p227: page 9]
ROS Master; Node; TCPROS 1:1 접속; 퍼블리셔 노드 정보; 서브스크라이버 노드 정보

퍼블리셔 노드 정보

# ROS 1.x (XMLRPC + TCPROS)

## XMLRPC

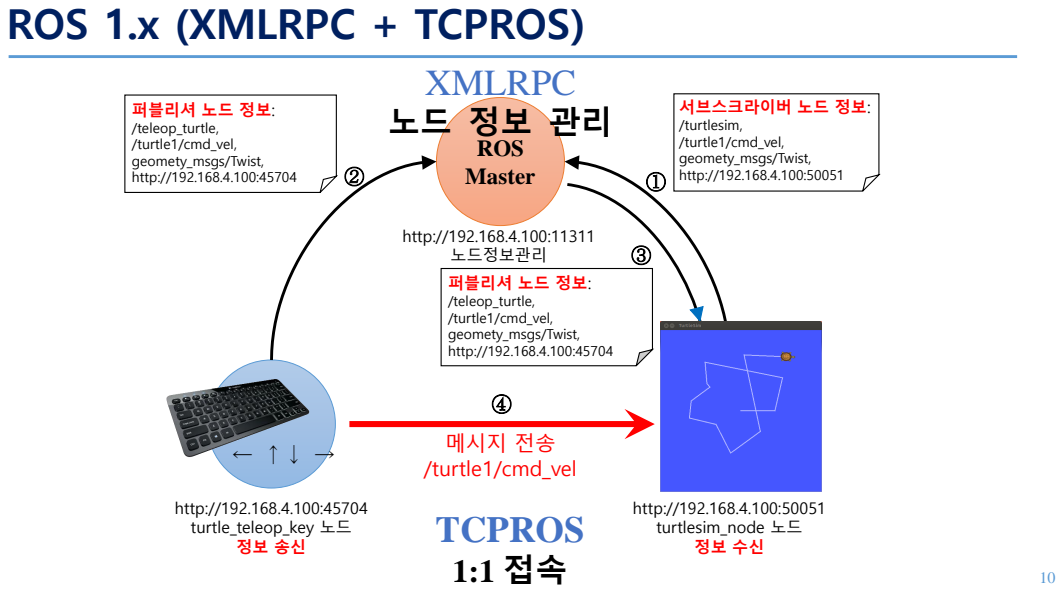
[picture p228: page 10]
ROS Master; http://192.168.4.100:50051 turtlesim_node 노드 정보 수신; http://192.168.4.100:45704 turtle_teleop_key 노드 정보 송신; 메시지 전송 /turtle1/cmd_vel; 퍼블리셔 노드 정보: /teleop_turtle, /turtle1/cmd_vel, geomety_msgs/Twist, http://192.168.4.100:45704; 서브스크라이버 노드 정보: /turtlesim, /turtle1/cmd_vel, geomety_msgs/Twist, http://192.168.4.100:50051; http://192.168.4.100:11311 노드정보관리; TCPROS 1:1 접속

# Transport: TCP vs UDP

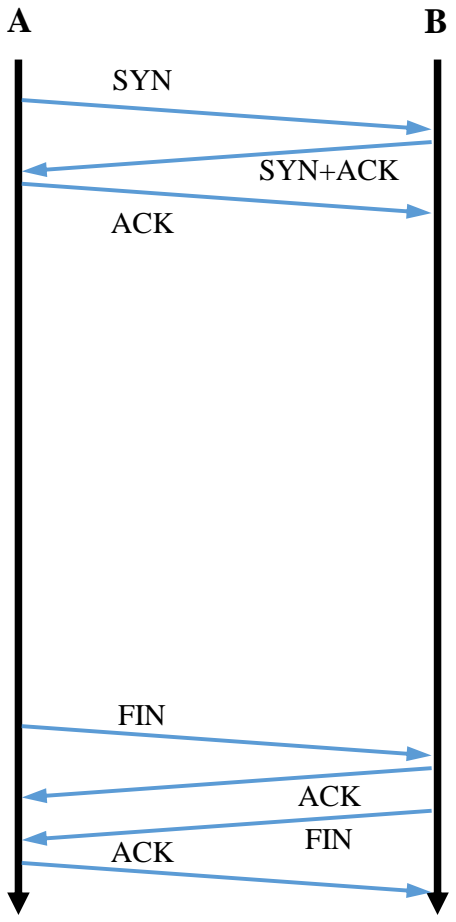
[picture p229: figure]
SYN; SYN+ACK; ACK; FIN; FIN ACK

Connection
establishment

Connection
termination

### TCP

A B

### UDP

Connection-oriented | Connectionless
Unicast | Unicast, Broadcast Multicast

# Transport: TCP vs UDP

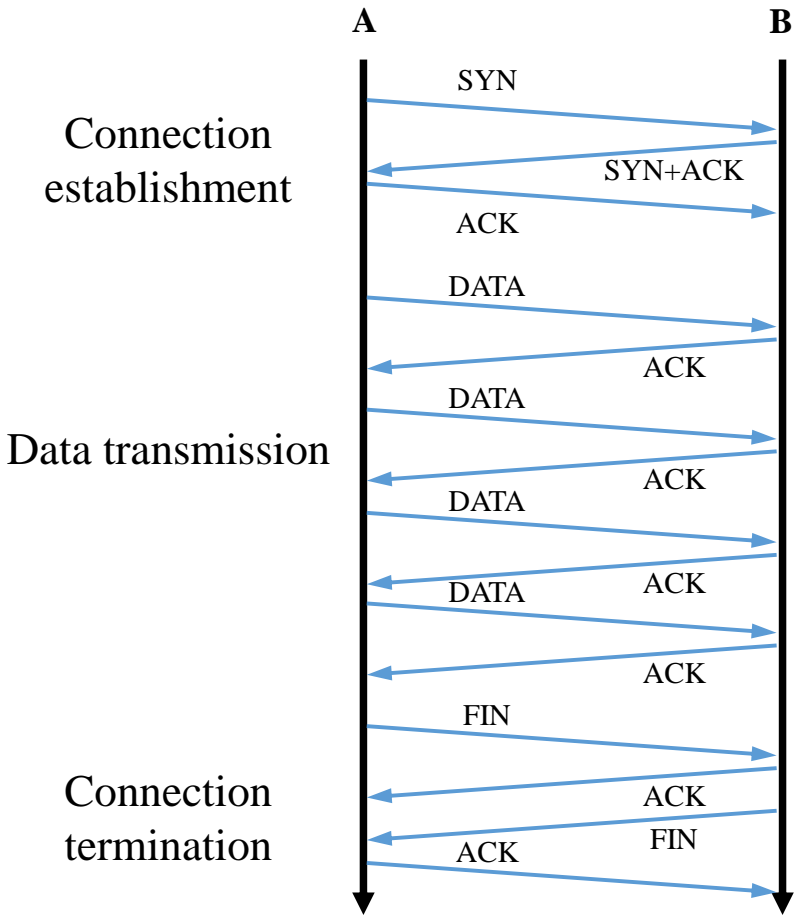
[picture p230: figure]
SYN; SYN+ACK; ACK; DATA; FIN; FIN ACK; Connection establishment; Connection termination; Data transmission

### TCP

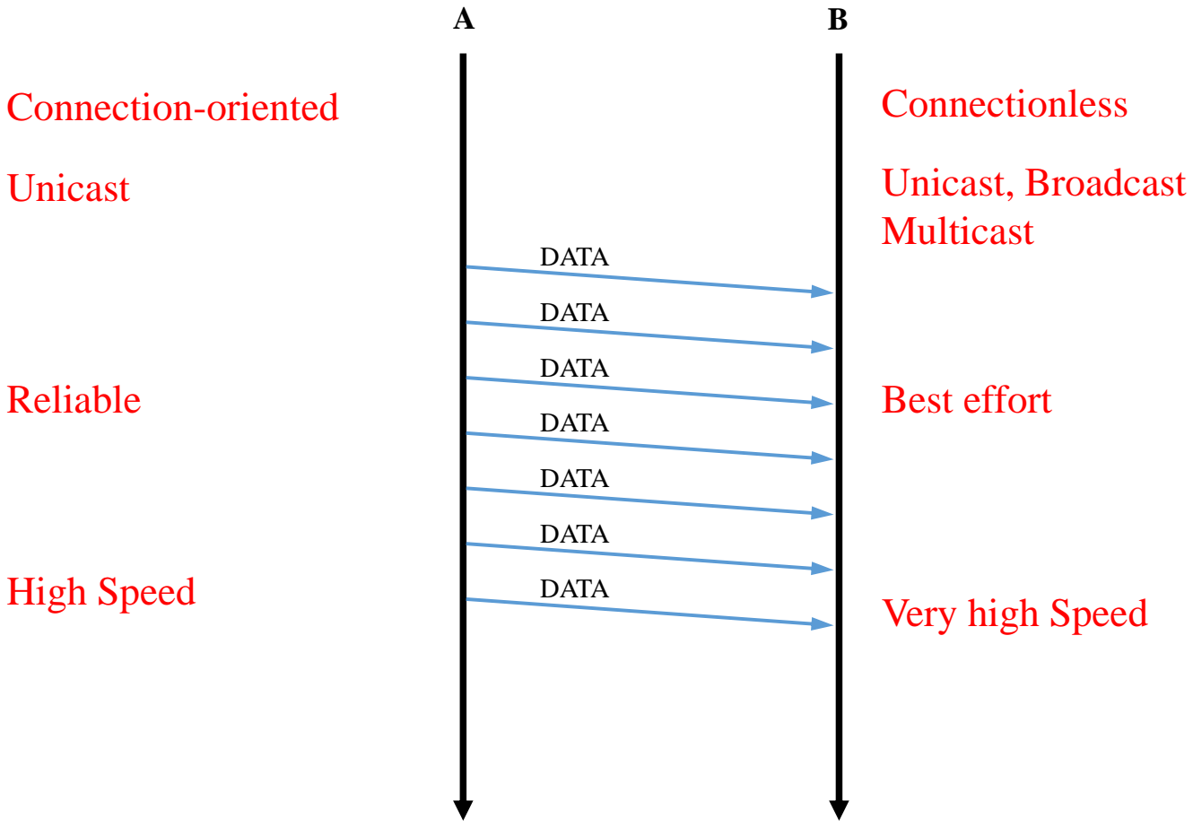
[picture p231: figure]
DATA; Reliable; Connection-oriented; Connectionless; Best effort; Unicast; Unicast, Broadcast; Multicast; High Speed; Very high Speed

### UDP

# DDS (Data Distribution Service)

## - DDS: 데이터 중심의 분산 시스템의 출판/구독형 미들웨어

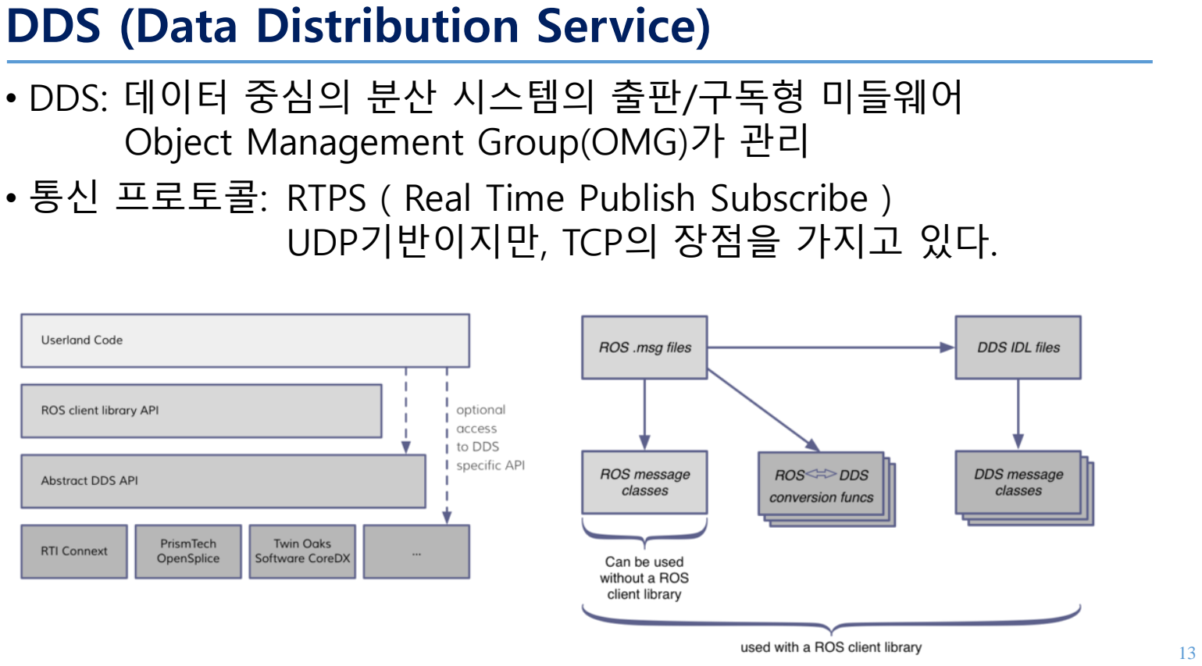
[picture p232: page 13]

## Object Management Group(OMG)가 관리 - 통신 프로토콜: RTPS（Real Time Publish Subscribe）

UDP기반이지만, TCP의 장점을 가지고 있다.

# DDS (Data Distribution Service)

## - Auto-Discovery: No need to know the IP Address and Port number

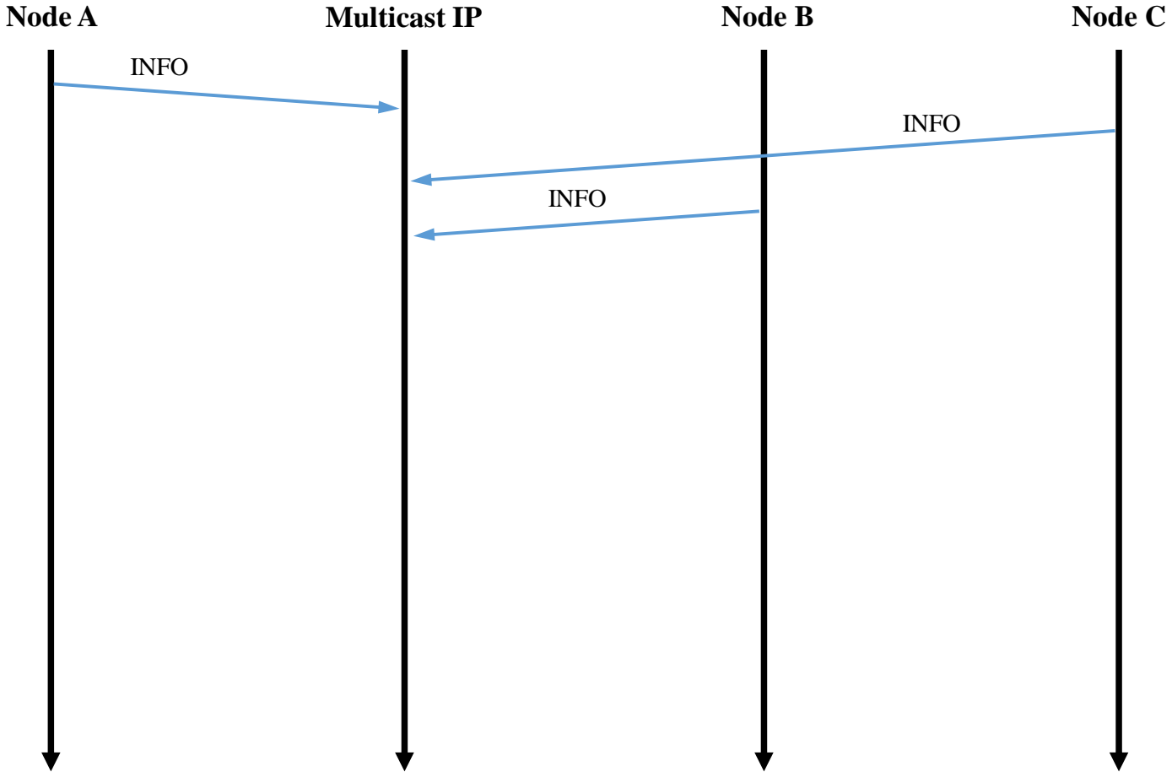
[picture p233: figure]
INFO; Node A; Multicast IP; Node B; Node C

# DDS (Data Distribution Service)

## - Auto-Discovery: No need to know the IP Address and Port number

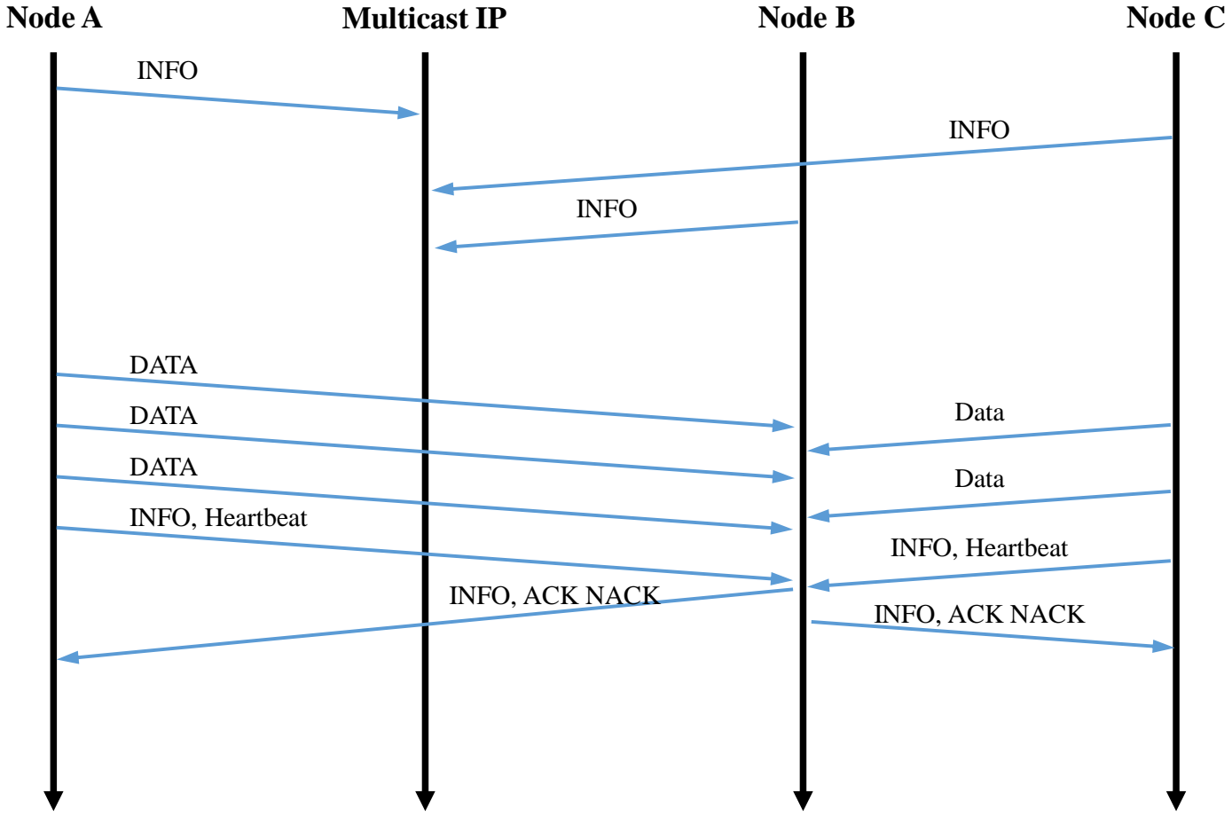
[picture p234: figure]
INFO; DATA; INFO, ACK NACK; Node A; Multicast IP; Data; INFO, Heartbeat; Node B; Node C

# DDS (Data Distribution Service)

## - Retransmission

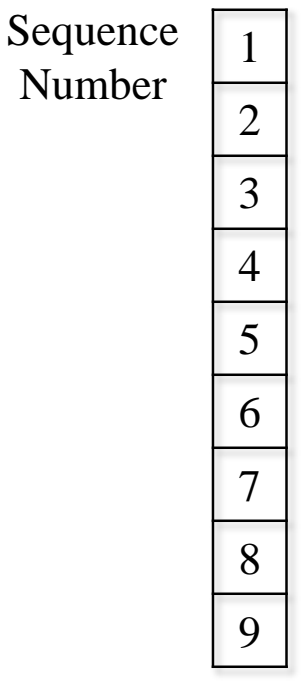
[picture p235: figure]
Sequence Number
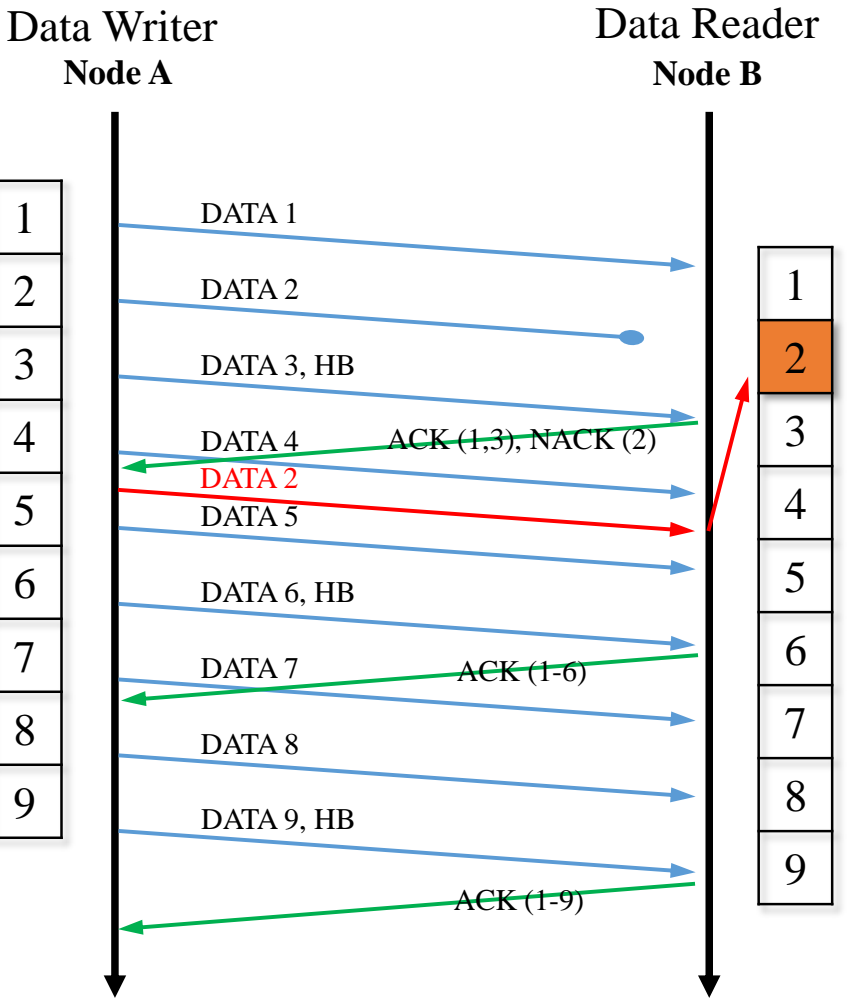
[picture p236: figure]
DATA 1; DATA 2; DATA 4; DATA 6, HB; Node A; Node B; DATA 3, HB; DATA 5; DATA 7; Data Writer; Data Reader; DATA 8; ACK (1,3), NACK (2); DATA 9, HB; ACK (1-6); ACK (1-9)

# Contents

## I. ROS 2

## II. ROS 2의 대표적인 3가지 기능

### 1. DDS (Data Distribution Service) 2. Real-time Computing 3. Embedded System

## III. ROS 2의 개발 현황

## IV. 미래의 로봇 운영체제가 갖추어야 할 것

# Real-time Computing

## - Real-time: It's about determinism, not performance!

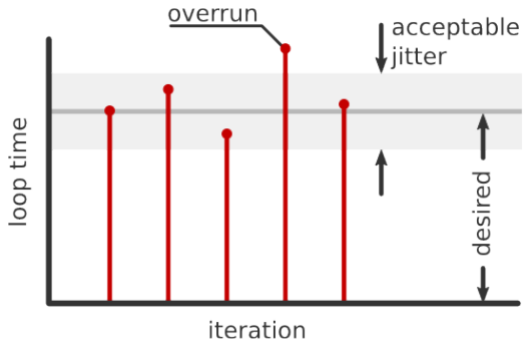
[picture p237: figure]

Jackie Kay (OSRF) et. al. "Real-time Performance in ROS 2", ROSCon2015 | 18

# Real-time Computing

## - Hard real-time systems - Soft real-time systems - Firm real-time systems

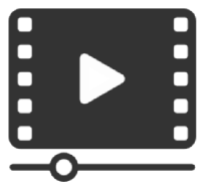
[picture p238: figure]
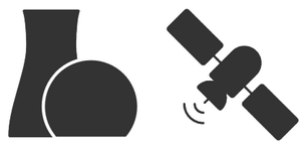
[picture p239: figure]
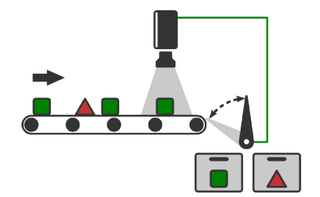
[picture p240: figure]

reactor, aircraft, spacecraft control | audio / video streaming | financial forecasting, robot assembly lines

Jackie Kay (OSRF) et. al. "Real-time Performance in ROS 2", ROSCon2015

# Real-time Computing

## - Use an OS able to deliver the required determinism

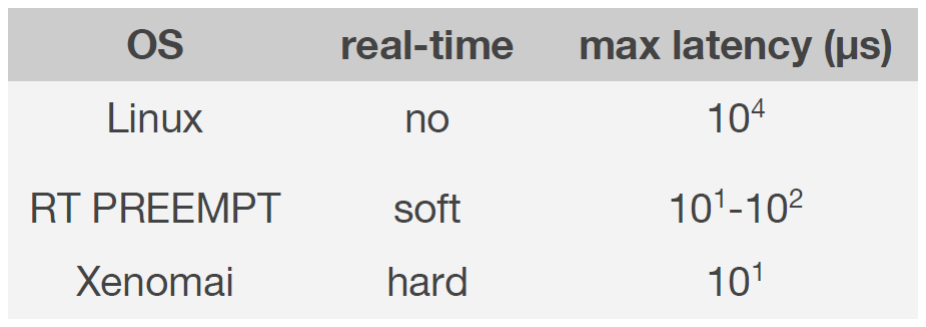
[picture p241: figure]

Jackie Kay (OSRF) et. al. "Real-time Performance in ROS 2", ROSCon2015 | 20

# Real-time Computing

## - Use an OS able to deliver the required determinism

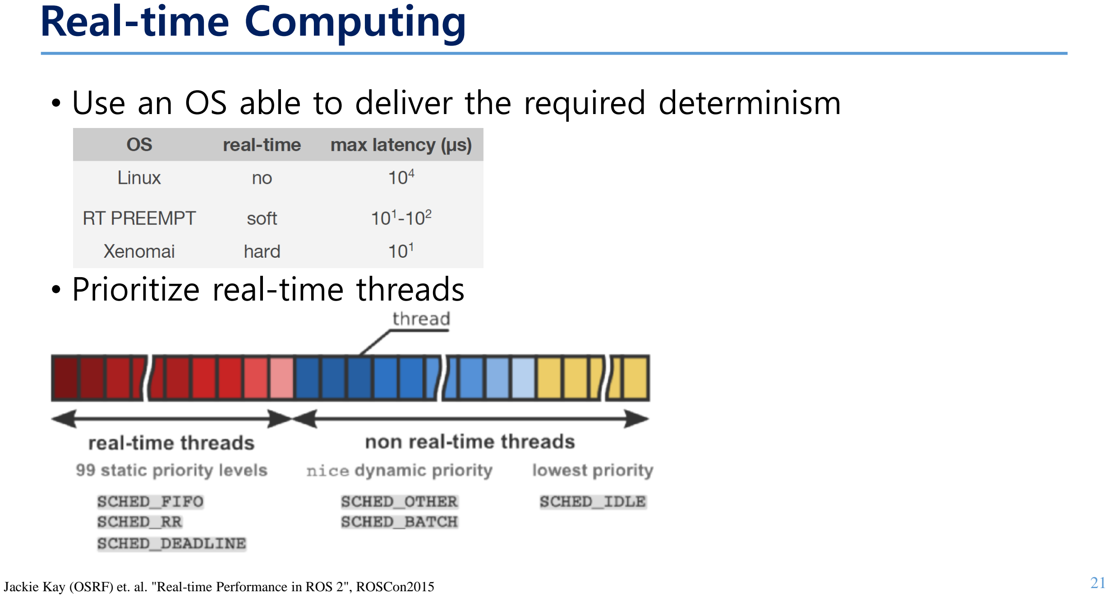
[picture p242: page 21]

## - Prioritize real-time threads

Jackie Kay (OSRF) et. al. "Real-time Performance in ROS 2", ROSCon2015 | 21

# Real-time Computing

# - Avoid sources of non-determinism in real-time code

## - Memory allocation and management ( malloc, new ) - Blocking synchronization primitives ( mutex ) - Printing, logging ( printf, cout ) - Network access, especially TCP/IP - Non real-time device drivers - Accessing the hard disk - Page faults

Jackie Kay (OSRF) et. al. "Real-time Performance in ROS 2", ROSCon2015 | 22

# Real-time Computing

## - Real-time code

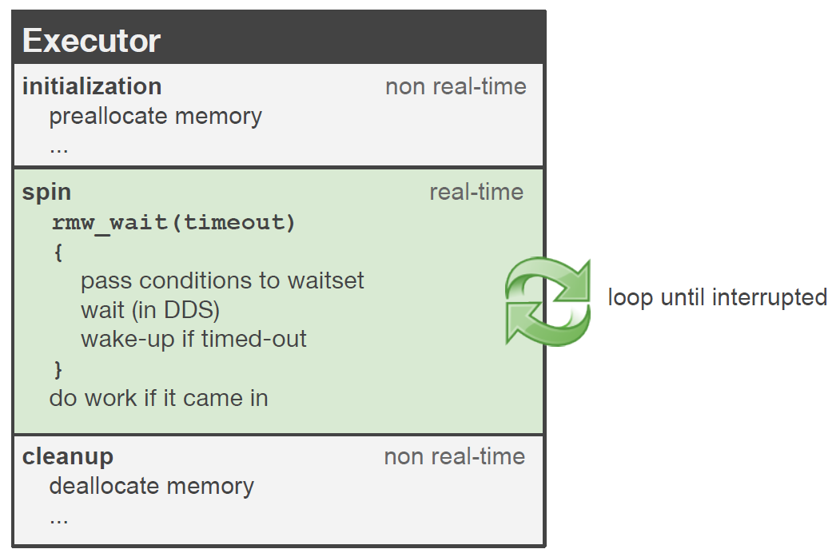
[picture p243: figure]

Jackie Kay (OSRF) et. al. "Real-time Performance in ROS 2", ROSCon2015

# Real-time Computing

## - Node lifecycle

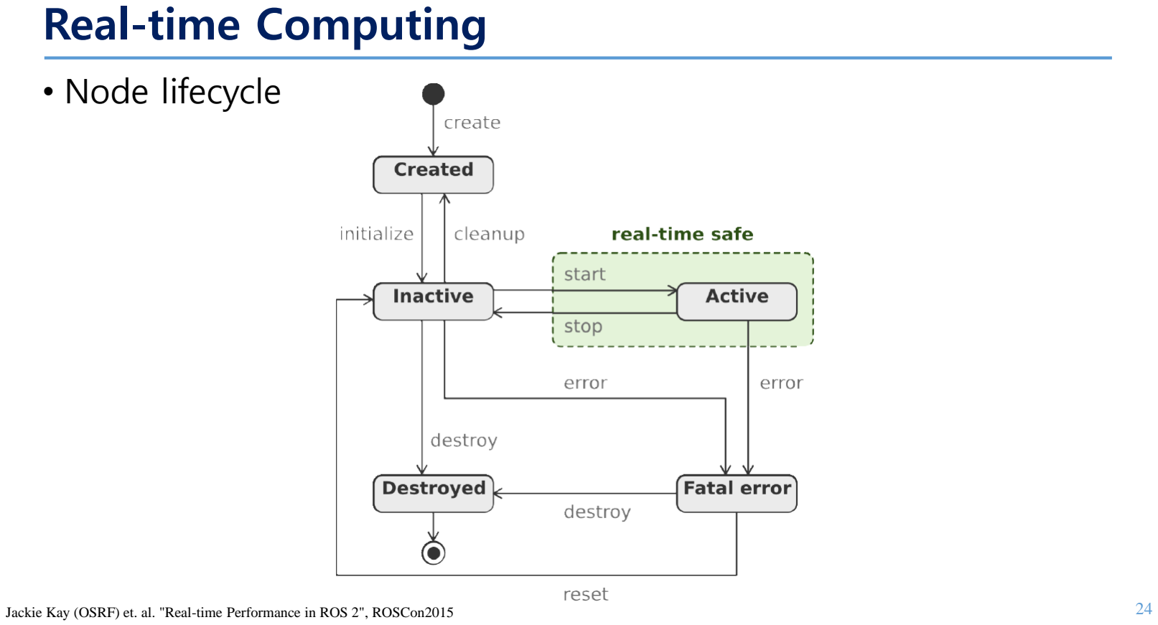
[picture p244: page 24]

Jackie Kay (OSRF) et. al. "Real-time Performance in ROS 2", ROSCon2015 | 24

# Real-time Computing

## - Real-time Benchmarking

Goal
﹣ 1 KHz update loop (1 ms period) ﹣ Less than 3% jitter (30 μs)

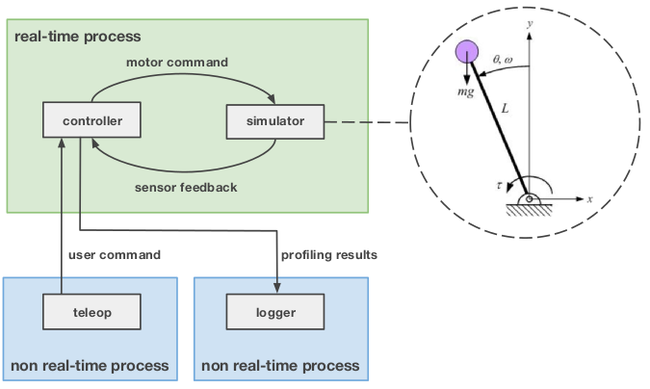
[picture p245: figure]

Jackie Kay (OSRF) et. al. "Real-time Performance in ROS 2", ROSCon2015

# Real-time Computing

## - Real-time Benchmarking

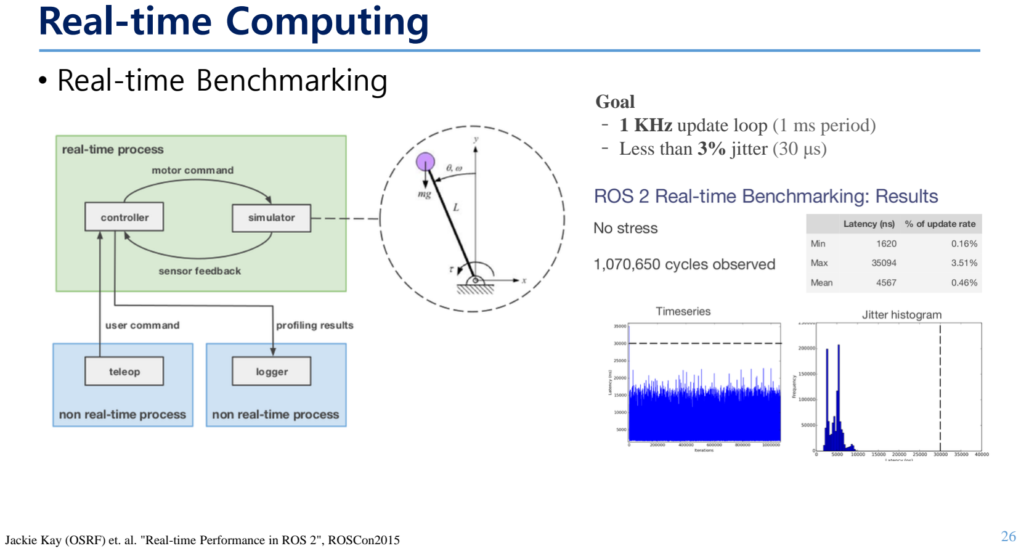
[picture p246: page 26]

Goal
﹣ 1 KHz update loop (1 ms period) ﹣ Less than 3% jitter (30 μs)

Jackie Kay (OSRF) et. al. "Real-time Performance in ROS 2", ROSCon2015

# Contents

## I. ROS 2

## II. ROS 2의 대표적인 3가지 기능

### 1. DDS (Data Distribution Service) 2. Real-time Computing 3. Embedded System

## III. ROS 2의 개발 현황

## IV. 미래의 로봇 운영체제가 갖추어야 할 것

# Embedded Systems

## - Small embedded systems are everywhere!

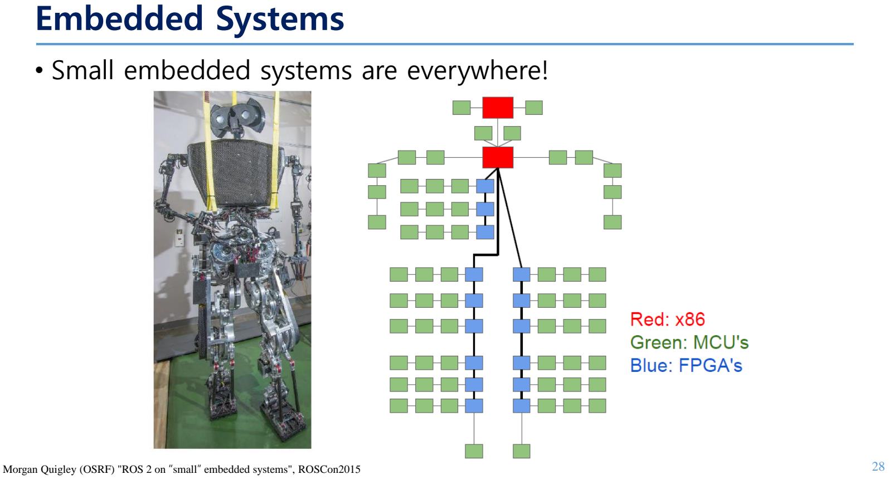
[picture p247: page 28]

Morgan Quigley (OSRF) "ROS 2 on “small” embedded systems", ROSCon2015 | 28

# Scope

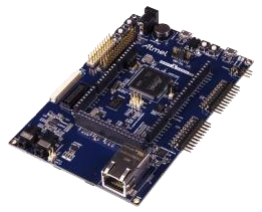
[picture p248: figure]
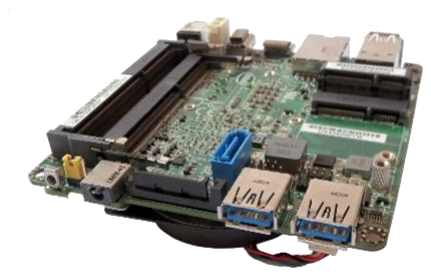
[picture p249: figure]
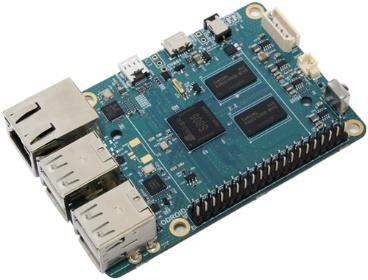
[picture p250: figure]
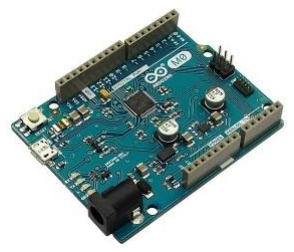
[picture p251: figure]

| 8/16-bit MCU | 32-bit MCU | ARM A-class (smartphone without screen) | x86
| "big" 32-bit MCU | (laptop without screen) "small" 32-bit MCU
Example Chip | Atmel AVR | ARM Cortex-M0 | ARM Cortex-M7 | Samsung Exynos | Intel Core i5
Example System | Arduino Leonardo | Arduino M0 Pro | SAM V71 | ODROID | Intel NUC
MIPS | 10's | 100's | 100's | 1000's | 10000's
RAM | 1-32 KB | 32 KB | 384 KB | a few GB (off-chip) | 2-16 GB (SODIMM)
Max power | 10's of mW | 100's of mW | 100's of mW | 1000's of mW | 10000's of mW
Peripherals | UART, USB FS, ... | USB FS | Ethernet, USB HS | Gigabit Ethernet | USB SS, PCIe
Future work | Target MCU | "Normal" ROS2

Morgan Quigley (OSRF) "ROS 2 on “small” embedded systems", ROSCon2015

# OpenCR

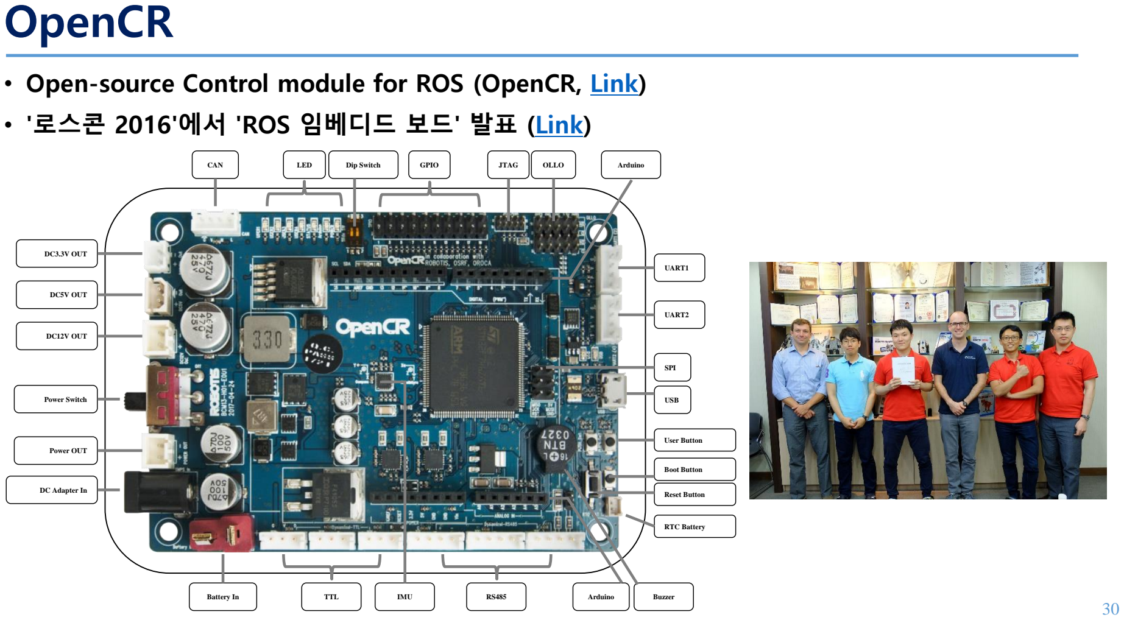
[picture p252: page 30]
Power OUT; DC12V OUT; DC5V OUT; DC3.3V OUT; Power Switch; Battery In; TTL; IMU; Arduino; Buzzer; UART1; UART2; USB; User Button; RTC Battery; Boot Button; Reset Button; CAN; LED; Dip Switch; GPIO; JTAG; OLLO; SPI

• Open-source Control module for ROS (OpenCR, Link) (http://cafe.naver.com/openrt/14465)
• '로스콘 2016'에서 'ROS 임베디드 보드' 발표 (Link) (http://www.irobotnews.com/news/articleView.html?idxno=7499)

DC Adapter In

# FreeRTPS

## - RTPS for embedded systems - Apache2 License - https://github.com/ros2/freertps

- It can use on MCU and on Linux.

FreeRTPS User API

Portable discovery, serialization, etc.

Minimalist UDPv4 | POSIX UDPv4
Vender Ethernet | Ethernet

User code

rclcpp

rmw

DDS interface

OpenSplice et. al.

User code

FreeRTPS

Flexible library stack,
elegant API via C++

Minimalist library stack,
ugly API, C-only
"Normal" ROS2 | ROS2 using FreeRTPS

Morgan Quigley (OSRF) "ROS 2 on “small” embedded systems", ROSCon2015

# ROS 2 features for embedded systems

## - ROS2 / DDS / RTPS is much more embedded friendly than the ROS1 protocols

ROS 1 | ROS 2
- startup sequencing | • no master
- XML-RPC discovery ▫ parse XML trees | • multicast UDP discovery ▫ parse parameter lists
- TCP data streams | • RTPS/UDP data streams
- UDPROS not complete | • extensive QoS on UDP

Morgan Quigley (OSRF) "ROS 2 on “small” embedded systems", ROSCon2015

# State of ROS 2: Architecture

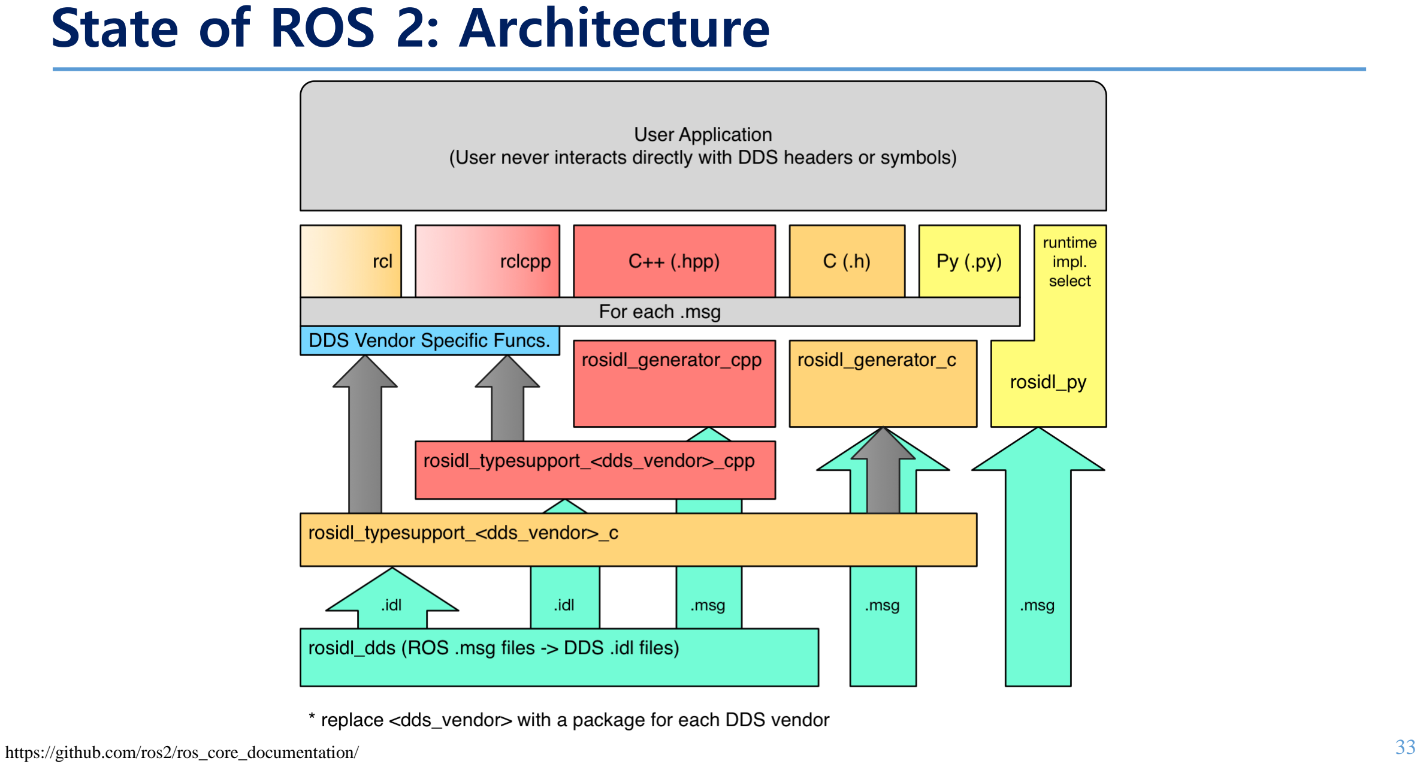
[picture p253: page 33]

https://github.com/ros2/ros_core_documentation/ | 33

# Performance measurements: IMU demo

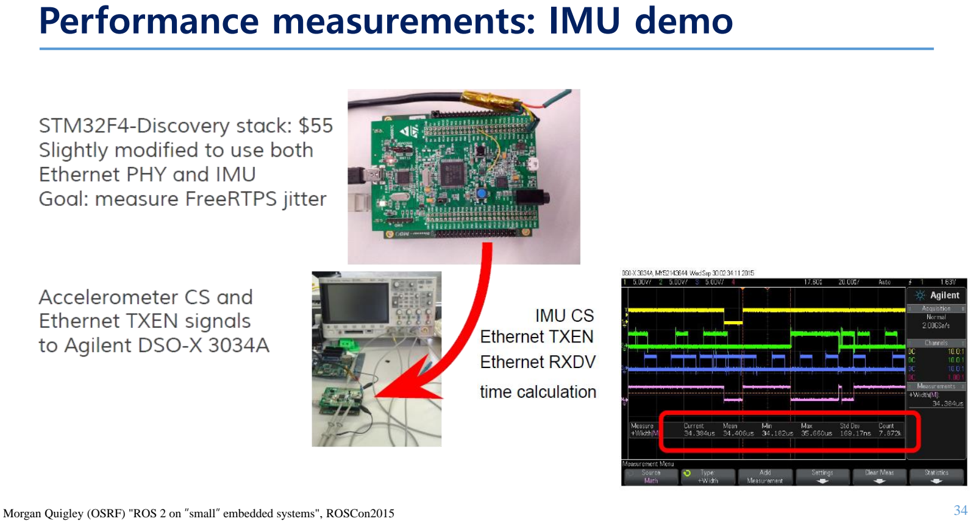
[picture p254: page 34]

Morgan Quigley (OSRF) "ROS 2 on “small” embedded systems", ROSCon2015 | 34

# Contents

## I. ROS 2

## II. ROS 2의 대표적인 3가지 기능

### 1. DDS (Data Distribution Service) 2. Real-time Computing 3. Embedded System

## III. ROS 2의 개발 현황

## IV. 미래의 로봇 운영체제가 갖추어야 할 것

# State of ROS 2

## - Goals

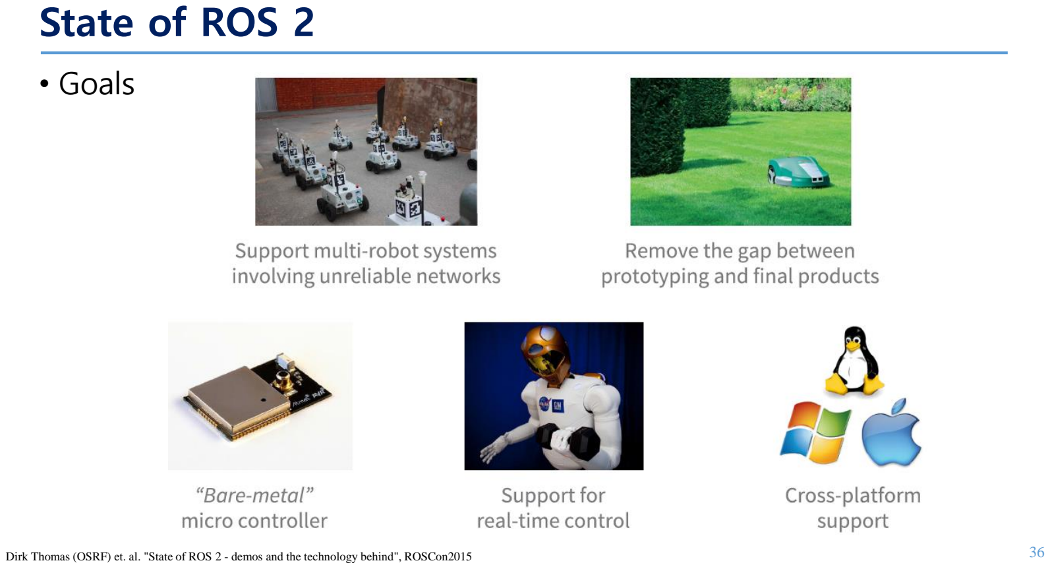
[picture p255: page 36]

Dirk Thomas (OSRF) et. al. "State of ROS 2 - demos and the technology behind", ROSCon2015 | 36

# State of ROS 2: TODO list

## - New APIs - ROS on DDS - Mapping between ROS interface types and DDS IDL types - RPC API design in ROS - Parameter API design in ROS - ROS 2 middleware interface - Real-time Systems - Build system ‘ament’

# State of ROS 2: Changes between ROS 1 and ROS 2

| ROS 1 | ROS 2
Platforms | Ubuntu, macOS | Ubuntu, macOS, Windows
Communication | XMLRPC + TCPROS | DDS (RTPS)
Languages | C++03, Python 2 | C++14, Python 3 (3.5+)
Build system | rosbuild → catkin | ament, colcon
Messages, Services | *.msg, *.srv | new *.msg, *.srv, *.msg.idl, *.srv.idl
roslaunch | XML | written in Python
multiple nodes | one node in a process | multiple nodes in a process
real-time | external frameworks like OROCOS | real-time nodes when using a proper RTOS with carefully written user code
Graph API | remapping at startup time only | remapping at runtime
Embedded systems | rosserial (UART) | FreeRTPS, microRTPS, microROS, ros2arduino
Node manager | ROS Master | No

State of ROS 2: Schedule • 2020.05.xx - ROS 2 F-turtle release • 2019.11.22 - ROS 2 E-turtle release • 2019.05.31 - ROS 2 Dashing Diademata release : 2 years support • 2018.12.14 - ROS 2 3rd release (Crystal Clemmys) • 2018.07.02 - ROS 2 2nd release (Bouncy Bolson) • 2017.12.08 - ROS 2 1st release (Ardent Apalone) • 2017.09.13 - ROS 2 Beta3 release (code name R2B3) • 2017.07.05 - ROS 2 Beta2 release (code name R2B2) • 2016.12.19 - ROS 2 Beta1 release (code name Asphalt) • 2016.10.04 - ROS 2 Alpha8 release (code name Hook.and.Loop) • 2016.07.14 - ROS 2 Alpha7 release (code name Glue Gun) • 2016.06.02 - ROS 2 Alpha6 release (code name Fastener) • 2016.04.06 - ROS 2 Alpha5 release (code name Epoxy) • 2016.02.17 - ROS 2 Alpha4 release (code name Duct tape) • 2015.12.18 - ROS 2 Alpha3 release (code name Cement) • 2015.11.03 - ROS 2 Alpha2 release (code name Baling wire) • 2015.08.31 - ROS 2 Alpha1 release (code name Anchor) | 39

# Contents

## I. ROS 2

## II. ROS 2의 대표적인 3가지 기능

### 1. DDS (Data Distribution Service) 2. Real-time Computing 3. Embedded System

## III. ROS 2의 개발 현황

## IV. 미래의 로봇 운영체제가 갖추어야 할 것

# 미래의 로봇 운영체제가 갖추어야 할 것

●기능
- 대동소이 [大同小異]
- 처음에는 각각의 특징이 있었으나 닮아가고 서로 보완하고 있다.
- 기능 갖춤은 필수이지 차별 점이 아니다.

### ●커뮤니티 파워

- 기능 보강, 빠른 피드백, 컨텐츠 생성, 보급, 문서화, 표준화 등에 큰 도움이 된다.
- 개발자/사용자 커뮤니티 없는 로봇 운영체제는 미래에 있을 수 없다.

### ●산업용 로봇 벤더들과의 협력

- 산업용 로봇의 벤더들은 보유 기술은 공개할 수 없지만 산학협력은 해야 한다.
- 오월동주 [吳越同舟] (ROS-Industrial)

### ●하드웨어를 잡아라

- 하드웨어 추상화 플랫폼 실현, 규격 제안, 모듈화 하드웨어 유도

### ●상업성 확보, 완전한 생태계 구축

- ROS는 아카데믹적인 면에서 영향력을 발휘했지만 수익 면에서는 NAOqi 처럼 개발자의 수익도 염두 해둔 APP시장을 키워야 더욱 풍부한 응용 애플리케이션 개발을 이끌 수 있다.
- 생태계(ECO system)

# 미래의 로봇 운영체제가 갖추어야 할 것

●기능
- 대동소이 [大同小異]
- 처음에는 각각의 특징이 있었으나 닮아가고 서로 보완하고 있다.
- 기능 갖춤은 필수이지 차별 점이 아니다.

### ●커뮤니티 파워

- 기능 보강, 빠른 피드백, 컨텐츠 생성, 보급, 문서화, 표준화 등에 큰 도움이 된다.
- 개발자/사용자 커뮤니티 없는 로봇 운영체제는 미래에 있을 수 없다.

### ●산업용 로봇 벤더들과의 협력

- 산업용 로봇의 벤더들은 보유 기술은 공개할 수 없지만 산학협력은 해야 한다.
- 오월동주 [吳越同舟] (ROS-Industrial)

### ●하드웨어를 잡아라

- 하드웨어 추상화 플랫폼 실현, 규격 제안, 모듈화 하드웨어 유도

### ●상업성 확보, 완전한 생태계 구축

- ROS는 아카데믹적인 면에서 영향력을 발휘했지만 수익 면에서는 NAOqi 처럼 개발자의 수익도 염두 해둔 APP시장을 키워야 더욱 풍부한 응용 애플리케이션 개발을 이끌 수 있다.
- 생태계(ECO system)

# 미래의 로봇 운영체제가 갖추어야 할 것

●기능
- 대동소이 [大同小異]
- 처음에는 각각의 특징이 있었으나 닮아가고 서로 보완하고 있다.
- 기능 갖춤은 필수이지 차별 점이 아니다.

### ●커뮤니티 파워

- 기능 보강, 빠른 피드백, 컨텐츠 생성, 보급, 문서화, 표준화 등에 큰 도움이 된다.
- 개발자/사용자 커뮤니티 없는 로봇 운영체제에는 미래란 있을 수 없다.

### ●산업용 로봇 벤더들과의 협력

- 산업용 로봇의 벤더들은 보유 기술은 공개할 수 없지만 산학협력은 해야 한다.
- 오월동주 [吳越同舟] (ROS-Industrial)

### ●하드웨어를 잡아라

- 하드웨어 추상화 플랫폼 실현, 규격 제안, 모듈화 하드웨어 유도

### ●상업성 확보, 완전한 생태계 구축

- ROS는 아카데믹적인 면에서 영향력을 발휘했지만 수익 면에서는 NAOqi 처럼 개발자의 수익도 염두 해둔 APP시장을 키워야 더욱 풍부한 응용 애플리케이션 개발을 이끌 수 있다.
- 생태계(ECO system)

# 미래의 로봇 운영체제가 갖추어야 할 것

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

### ●커뮤니티 파워

- 기능 보강, 빠른 피드백, 컨텐츠 생성, 보급, 문서화, 표준화 등에 큰 도움이 된다.
- 개발자/사용자 커뮤니티 없는 로봇 운영체제에는 미래란 있을 수 없다.

### ●산업용 로봇 벤더들과의 협력

- 산업용 로봇의 벤더들은 보유 기술은 공개할 수 없지만 산학협력은 해야 한다.
- 오월동주 [吳越同舟] (ROS-Industrial)

### ●하드웨어를 잡아라

- 하드웨어 추상화 플랫폼 실현, 규격 제안, 모듈화 하드웨어 유도

### ●상업성 확보, 완전한 생태계 구축

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

# 미래의 로봇 운영체제가 갖추어야 할 것

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

### ●커뮤니티 파워

- 기능 보강, 빠른 피드백, 컨텐츠 생성, 보급, 문서화, 표준화 등에 큰 도움이 된다.
- 개발자/사용자 커뮤니티 없는 로봇 운영체제에는 미래란 있을 수 없다.

### ●산업용 로봇 벤더들과의 협력

- 산업용 로봇의 벤더들은 보유 기술은 공개할 수 없지만 산학협력은 해야 한다.
- 오월동주 [吳越同舟] (ROS-Industrial)

### ●하드웨어를 잡아라

- 하드웨어 추상화 플랫폼 실현, 표준/규격 제안, 모듈화 하드웨어 유도

### ●상업성 확보, 완전한 생태계 구축

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

# 미래의 로봇 운영체제가 갖추어야 할 것

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

### ●커뮤니티 파워

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

### ●산업용 로봇 벤더들과의 협력

- 산업용 로봇의 벤더들은 보유 기술은 공개할 수 없지만 산학협력은 해야 한다.
- 오월동주 [吳越同舟] (ROS-Industrial)

### ●하드웨어를 잡아라

- 하드웨어 추상화 플랫폼 실현, 표준/규격 제안, 모듈화 하드웨어 유도

### ●상업성 확보, 완전한 생태계 구축

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

## 보이지 않는 생태계 속의 분업

질문

# 대환영!

# * 온라인 상의 질문이라면 오로카 및 로열모를 이용해주세요!

## 여기서! 광고 하나 나가요~


## 국내 유일! 최초! ROS 참고서! ROS 공식 플랫폼 TurtleBot3 개발팀이

## 직접 저술한 바이블급 ROS 책

# 한국어판 구매 링크 (http://book.naver.com/bookdb/book_detail.nhn?bid=12443870)

# 4개 언어로 출판! (http://emanual.robotis.com/docs/en/platform/turtlebot3/learn/#books)

## 여기서! 광고 둘 나가요~


# Direct Link (http://www.robotis.com/model/board.php?bo_table=print&wr_id=36)

인공지능(AI) 연구의 시작,
ROS 교육용 공식 로봇 플랫폼

터틀봇3는 ROS기반의 저가형 모바일 로봇으로
교육, 연구, 제품개발, 취미 등 다양한 분야에서 활용할 수 있습니다.

## 여기서! 광고 셋 나가요~


- 오로카
- www.oroca.org
- 오픈 로보틱스 지향
- 풀뿌리 로봇공학의 저변 활성화
- 공개 강좌, 세미나, 프로젝트 진행


- 로봇공학을 위한 열린 모임 (KOS-ROBOT)
- www.facebook.com/groups/KoreanRobotics
- 로봇공학 통합 커뮤니티 지향
- 일반인과 전문가가 어울러지는 한마당
- 로봇공학 정보 공유
- 연구자 간의 협력

# 혼자 하기에 답답하시다고요? 커뮤니티에서 함께 해요~

- RobotSource
- www.robotsource.org
- 글로벌 로보틱스 커뮤니티 지향
- 로봇공학 정보 공유
- 자신의 로봇 프로젝트 공유
- DIY 로봇 프로젝트 진행


Yoonseok Pyo
pyo@robotis.com
www.robotpilot.net

## 표윤석

www.facebook.com/yoonseok.pyo

끝.
