kongshyun/2022Capstone-AGV/최종논문 및 보고서/Readme.md

배달안정성을 위한 흔들림 방지용 모바일로봇 개발 학과제출 논문
최종보고서
rqt_graph
