kongshyun/2022Capstone-AGV/launch/Readme.md

1. Agv_Stabil_key.launch : 4차발표 launch 파일
  - serial_node & serial_node2
