kongshyun/2022Capstone-AGV/Arduino_Code/Readme.md

1. 4차발표 준비 코드폴더
2. 3차발표, ebimu, 모터테스트 코드
