kongshyun/2022Capstone-AGV/Arduino_Code/4차발표_아두이노코드/Readme.md

4차발표 사용할 코드

  *serial_node -> Agv_imu_test2
  
  *serial_node2 -> DC_Stabil_test
