kongshyun/2022Capstone-AGV/최종논문 및 보고서, 참고자료/응용로봇설계_5강(궤적생성)_학생용.pdf

# Applied Robot Design

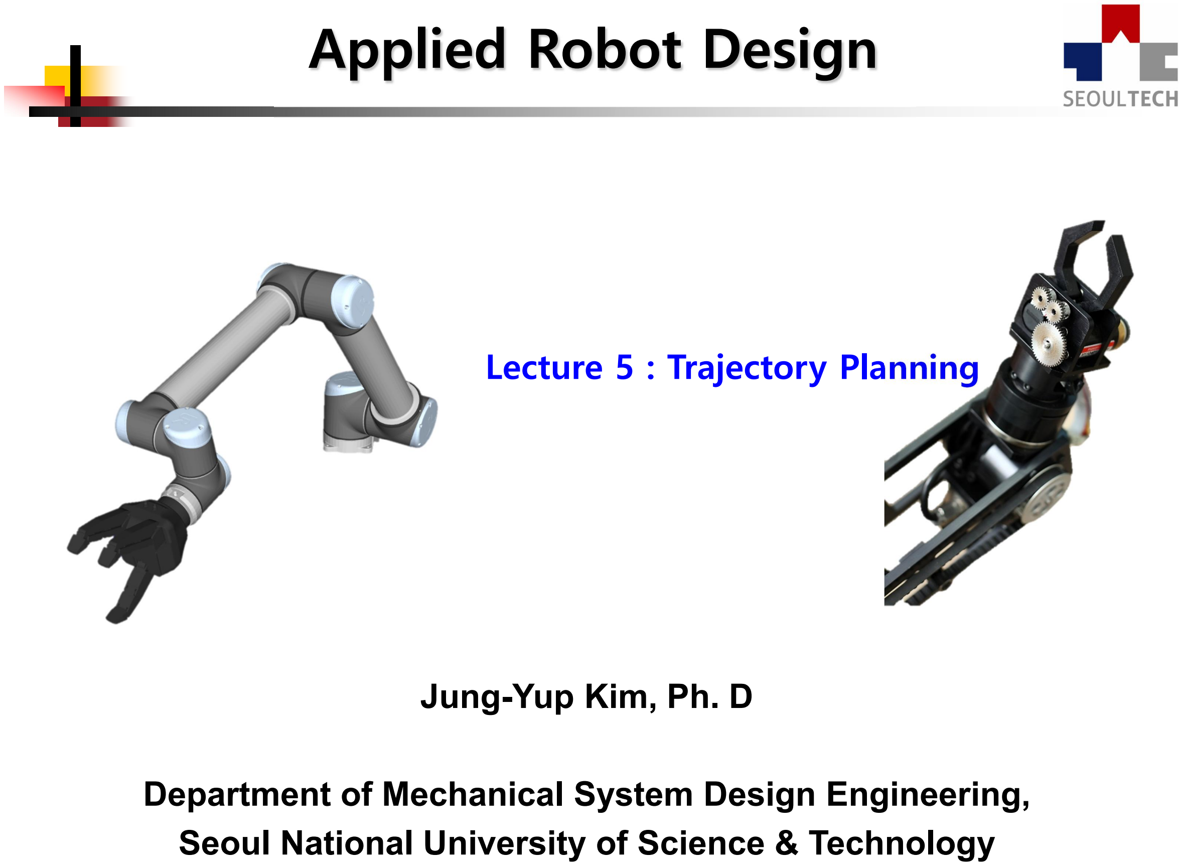
[picture p257: page 1]

Jung-Yup Kim, Ph. D

Department of Mechanical System Design Engineering, Seoul National University of Science & Technology

### Lecture 5 : Trajectory Planning

## Introduction

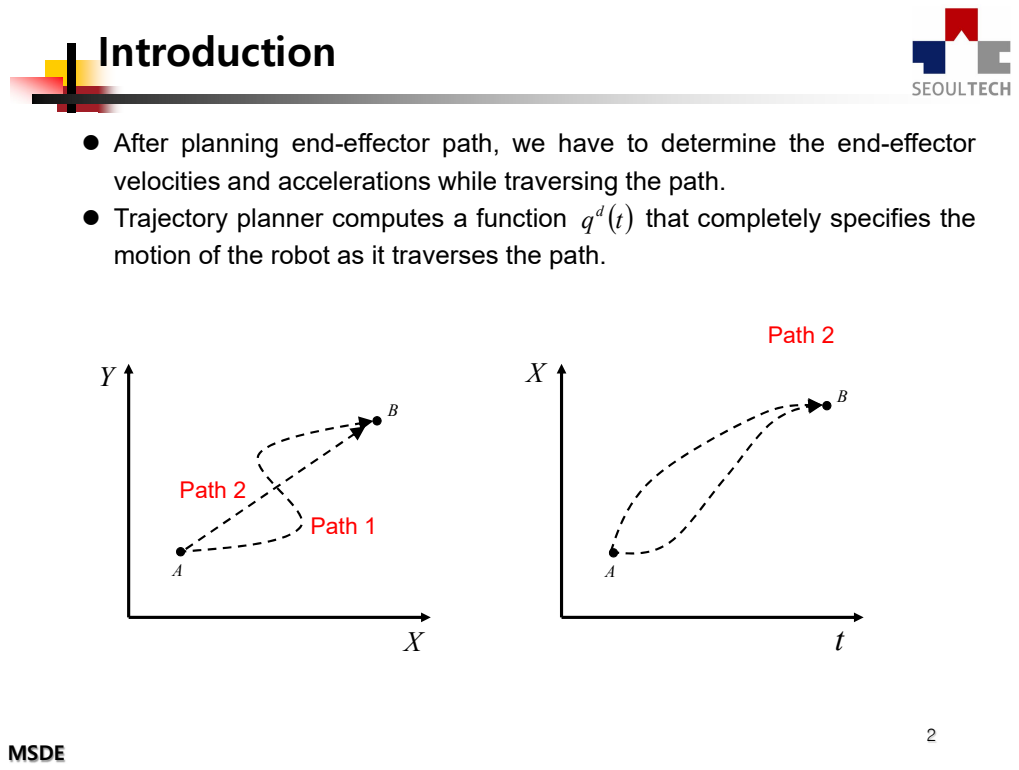
[picture p258: page 2]
MSDE; Path 1; Path 2; velocities and accelerations while traversing the path. l Trajectory planner computes a function; that completely specifies the

l After planning end-effector path, we have to determine the end-effector

motion of the robot as it traverses the path.

## Introduction

l Example : Humanoid Upper Body Motion Generation

1) Path planning using human motion capture
2) Trajectory planning using Fourier series fitting
3) Generation of speed and amplitude adjustable motion

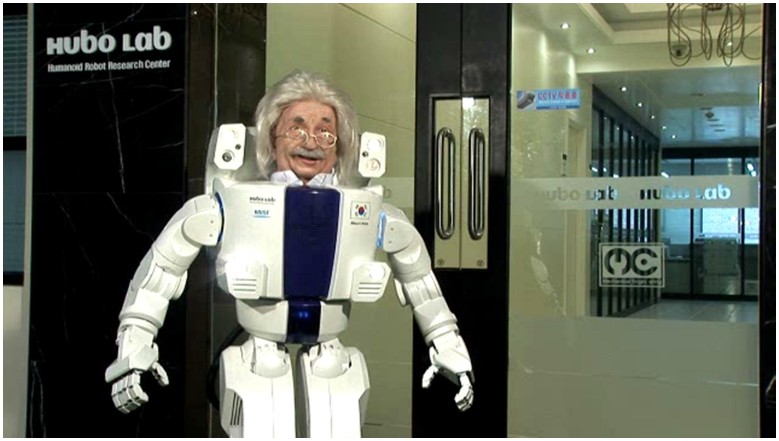
[picture p259: figure]

## 5.1 The Trajectory Planning Problem

A trajectory is a function of time q(t) such that q(t0

) = qs and q(tf) = qf.

In this case, t

f – t0

represents the amount of time taken to execute the trajectory. Since the trajectory is parametrized by time, we can compute velocities and

accelerations along the trajectories by differentiation.
If the trajectory represents a Cartesian position of the end-effector, the inverse kinematics solution must be used to derive a sequence of joint configurations.

(0 1.0)

1.0

10 0.5 1 cos

1.0

5 0.5 1 cos

£ £

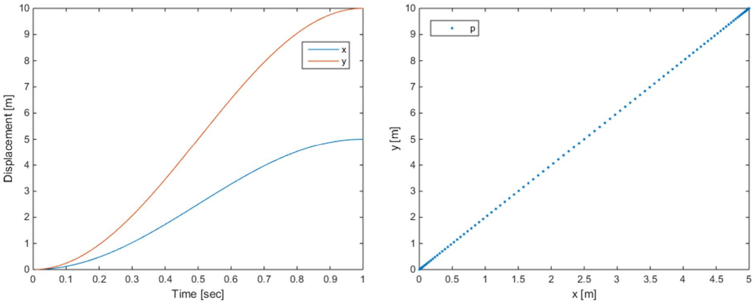
[picture p260: figure]

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
= | × | × -

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
= × × -

t

y | t
x | t
| p

p
Ex.)

## 5.1 The Trajectory Planning Problem

It is often the case that a manipulator motion can be decomposed into segments consisting of free and guarded motions. During the free motion the manipulator can move very fast, since no

obstacles are near by, but at the start and end of motion, care must be taken to avoid obstacles. Below, we first consider point to point motion. Once we have seen how to

construct trajectories between two configurations, it is straightforward to generalize the method to the case of trajectories specified by multiple via points.

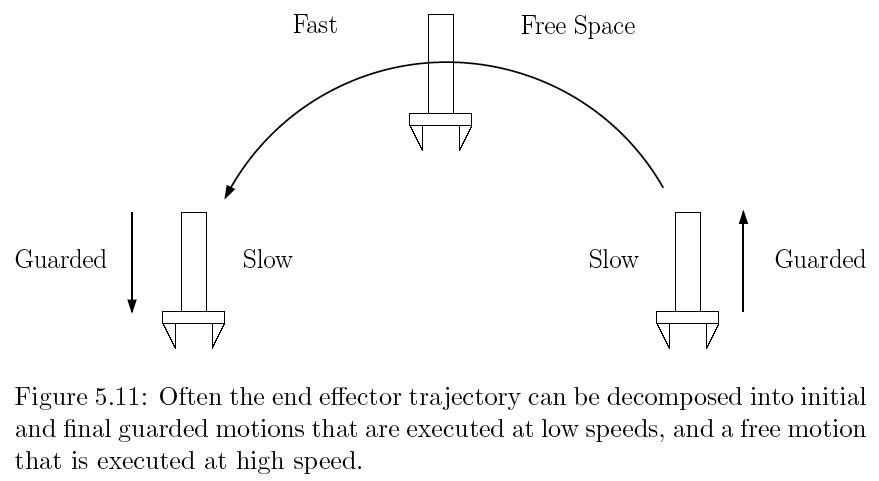
[picture p261: figure]

## 5.1 The Trajectory Planning Problem

l Path Planning :

x0 = 0;
y0 = 0;

xf = 1;
yf = 2;

dy_dx0 = -1;
dy_dxf = -2;

A = [1 x0 x0^2 x0^3;
0 1 2*x0 3*x0^2;
1 xf xf^2 xf^3; 0 1 2*xf 3*xf^2];

X = [y0 dy_dx0 yf dy_dxf]';

C = inv(A)*X;

for i=1:1:100

x(i) = 0.01*i;
y(i) = C'*[1 x(i) x(i)^2 x(i)^3]';

end

plot(x,y);
legend('p');
xlabel('x [m]');
ylabel('y [m]');

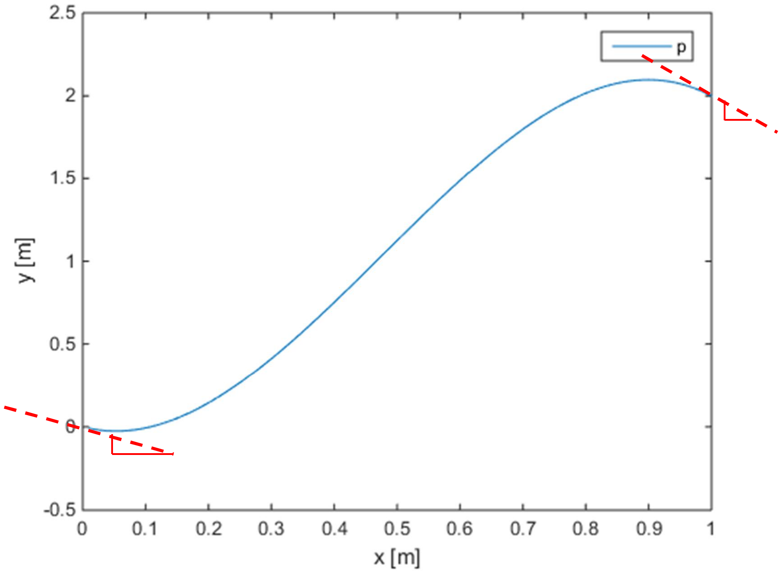
[picture p262: figure]

Coefficients of cubic
polynomial path

## 5.1 The Trajectory Planning Problem

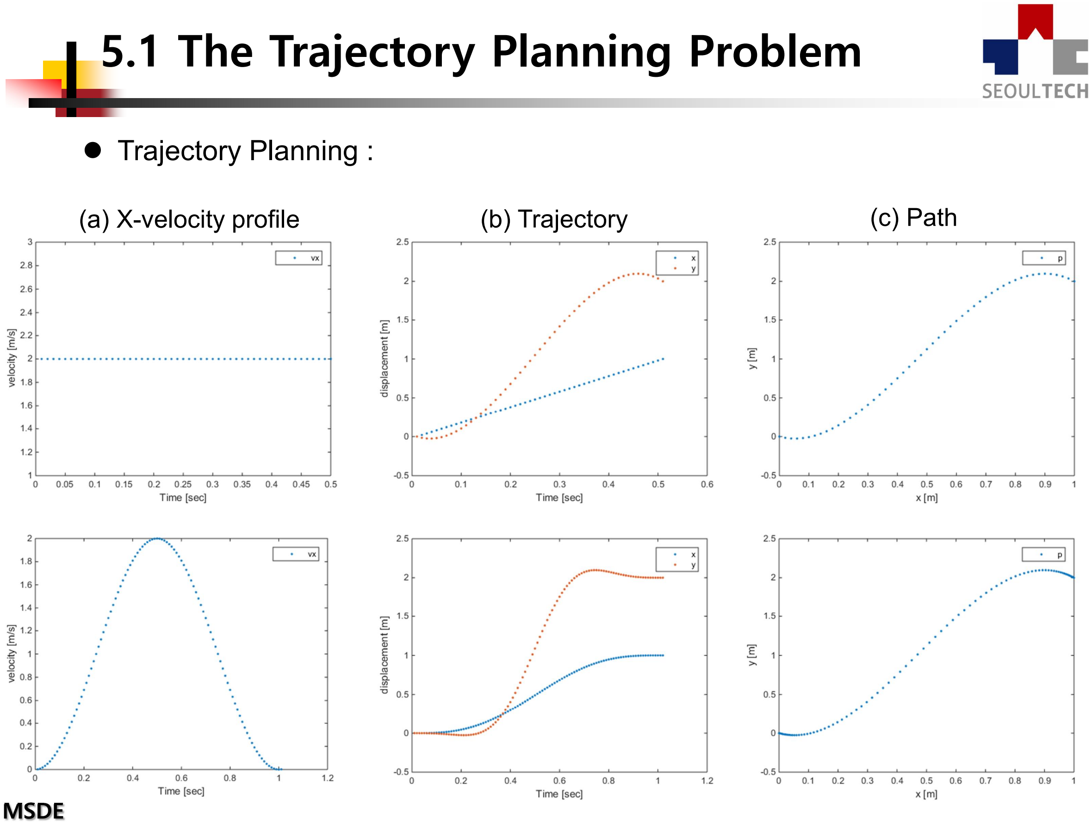
[picture p263: page 7]

l Trajectory Planning :

(a) X-velocity profile | (b) Trajectory | (c) Path

## 5.1 The Trajectory Planning Problem

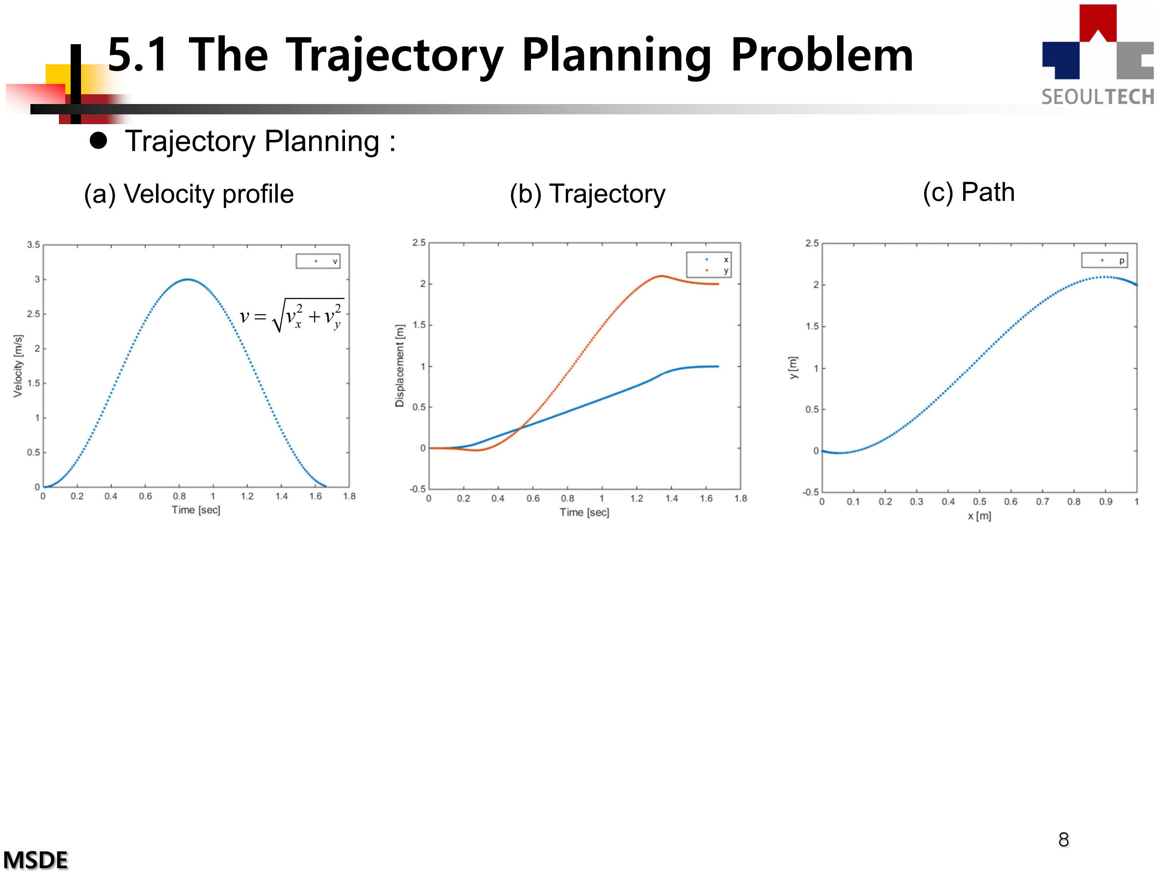
[picture p264: page 8]

l Trajectory Planning :

(a) Velocity profile | (b) Trajectory | (c) Path
2 | 2
x | y v | v | v = | +

## 5.2 Trajectories for Point to Point Motion

And we wish to attain the values at f t

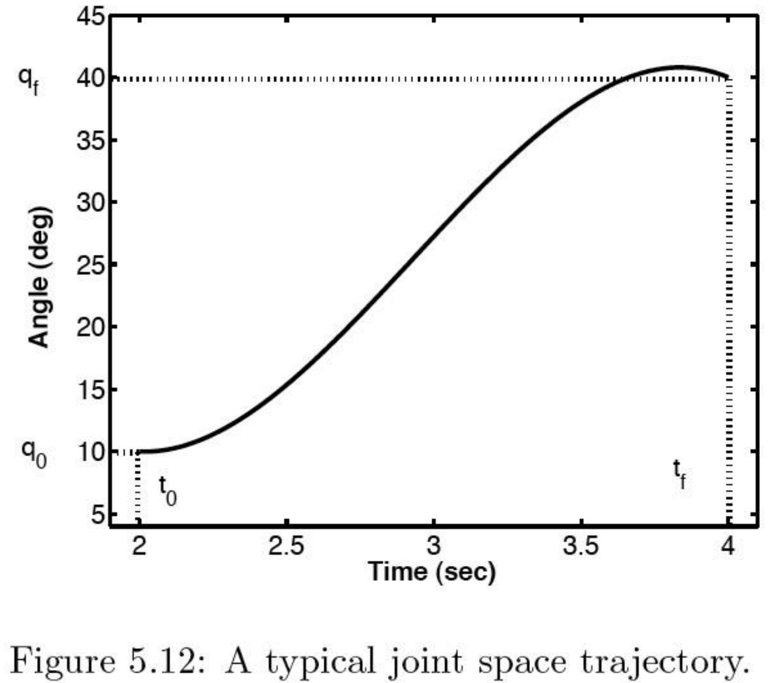
[picture p265: figure]

The right figure shows a suitable trajectory for this motion. In addition, we may wish to specify the constraints on initial and final accelerations. ( ) 0 =a0 q&& t

( )f | f q&& t =a
0 We supposed that at time t | the E.E. position/orientation variable satisfies

## 5.2 Trajectories for Point to Point Motion

### 1. Cubic Polynomial Trajectories

We consider a cubic trajectory of the form

Then the desired velocity is given as
( )
2
1 | 2 | 3 q& t = a + 2a t + 3a t

Four constraints yields four equations in four unknowns,

3
3 0

2
0 | 0 | 1 0 | 2 0 q = a + a t + a t + a t
| | | 2
0 | 1 | 2 0 | 3 0 v = a + 2a t + 3a t

3
| | | 3

2
f | 0 | 1 f | 2 f | f q = a + a t + a t + a t

2
1 | 2 | 3 2 | 3 f | f | f v = a + a t + a t

## 5.2 Trajectories for Point to Point Motion

These four equations can be combined into a single matrix equation

v The determinant of the coefficient matrix in the above equation is equal to and hence the above equation has a unique solution provided a nonzero time interval is allowed for the execution of the trajectory. Ex. 8.1. Cubic Polynomial Trajectory

As an illustrative example, we may consider the special case that the initial
and final velocities are zero. Suppose we take | t0 = 0 | and t
f =1 sec, with
0 | 0 v0 = | v f =

## 5.2 Trajectories for Point to Point Motion

Thus,

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
0 1 2 3

1 1 1 1

0 1 0 0

1 0 0 0 | 0

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
Then,

2 | 3 | 0

0

2 | 3
2 | 3 | 0

1

0 | 0
+ | =
+ | = | -

=

=

a | a
a | a | q | q

a

a q

f

The required cubic polynomial function is therefore

The corresponding velocity and acceleration curves are given as
( ) ( | ) ( | )
q(t) (q | q ) (q | q )t
q t | q | q t | q | q t
f | f
f | f
0 | 0

2
0 | 0
6 | 12
6 | 6
= | - | - | -
= | - | - | -
&&

&

## 5.2 Trajectories for Point to Point Motion

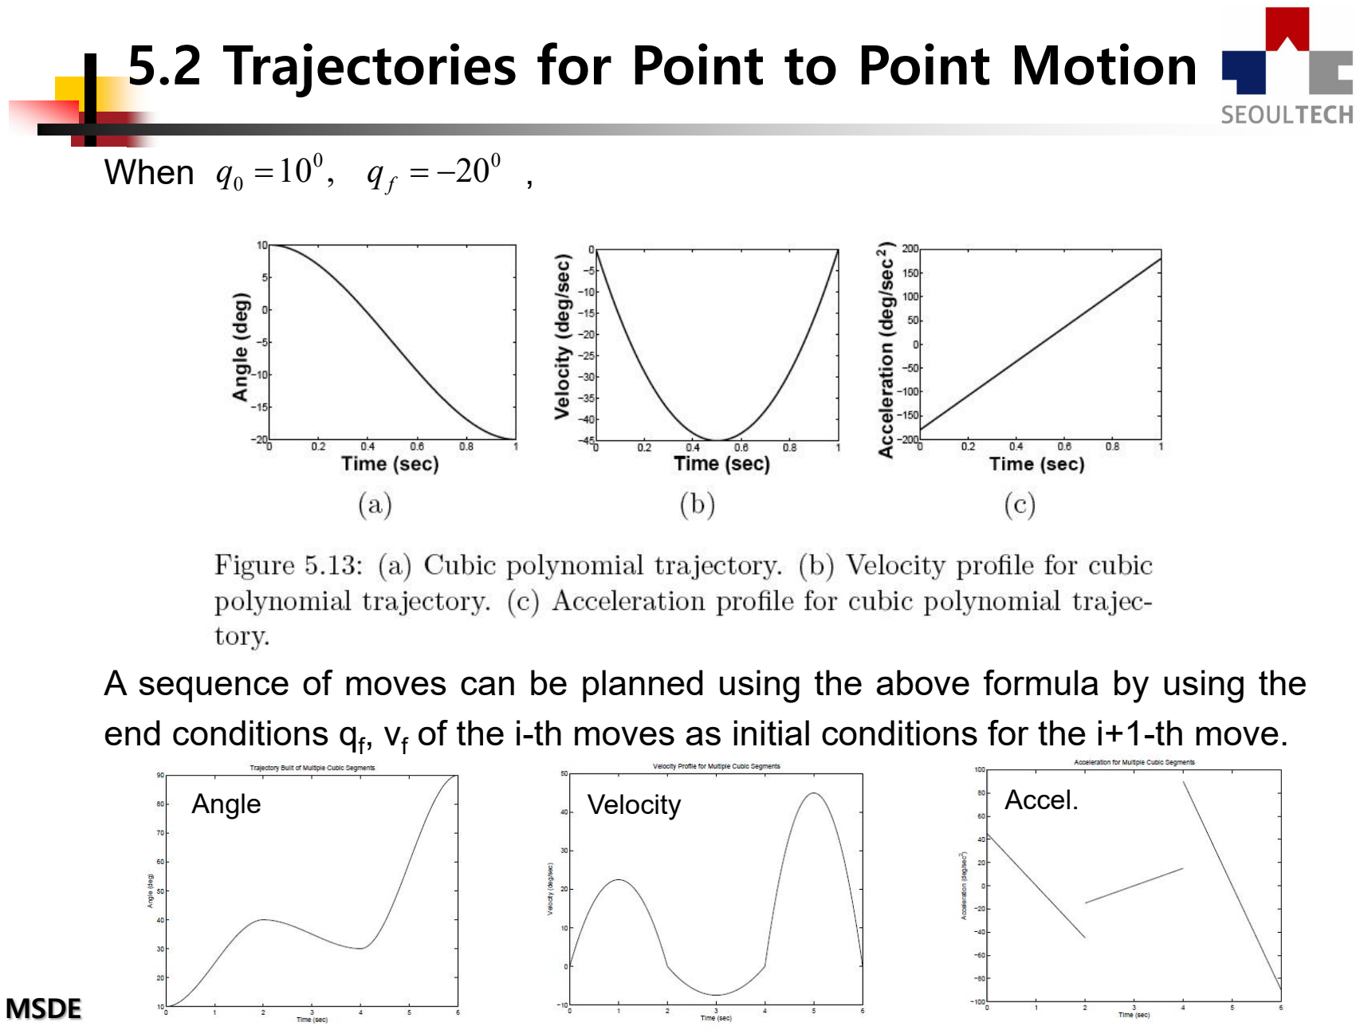
[picture p266: page 13]

When | ,
0 | 0
0 =10 ,
= -20 f q | q

A sequence of moves can be planned using the above formula by using the
end conditions qf, vf of the i-th moves as initial conditions for the i+1-th move. Angle | Velocity | Accel.

## 5.2 Trajectories for Point to Point Motion

### 2. Quintic Polynomial Trajectories

A cubic trajectory gives continuous positions and velocities at the start and finish points times but discontinuities in the acceleration. A discontinuity in acceleration leads to an impulsive jerk, which may excite

vibrational modes in the manipulator and reduce tracing accuracy. For this reason, one may wish to specify additional acceleration constraints. Therefore, we require a 5

th order polynomial

We can obtain the following equations

5
5 0

4
4 0

3
3 0

2
0 | 0 | 1 0 | 2 0 q = a + a t + a t + a t + a t + a t
| | | 4
| | | 5 0

3
4 0

2
0 | 1 | 2 0 | 3 0 v = a + 2a t + 3a t + 4a t + 5a t
| | | 3
| | | 5 0

2
0 | 2 | 3 0 | 4 0 a = 2a + 6a t +12a t + 20a t

5
5

4
4

3
3

2
f | 0 | 1 f | 2 f | f | f | f q = a + a t + a t + a t + a t + a t

4

3

2
1 | 2 | 3 2 | 3 | 4 | 5 f | f | f | f | f v = a + a t + a t + a t + a t
2 | 3 | 4 2 | 6 | 12 | 20 f | f | f | f a = a + a t + a t + | a t

## 5.2 Trajectories for Point to Point Motion

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
2 | 3
2 | 3 | 4
2 | 3 | 4 | 5

3
0

2
0 | 0

4
0

3
0

2
0 | 0

5
0

4
0

3
0

2
0 | 0
0 0 | 2 | 6 | 12 | 20
0 1 | 2 | 3 | 4 | 5

1

0 0 | 2 | 6 | 12 | 20
0 1 | 2 | 3 | 4 | 5

1

which can be written as

The following figure shows a quantic polynomial trajectory with

with zero initial and final velocities and accelerations. | q(0) = 0, q(2) = 20

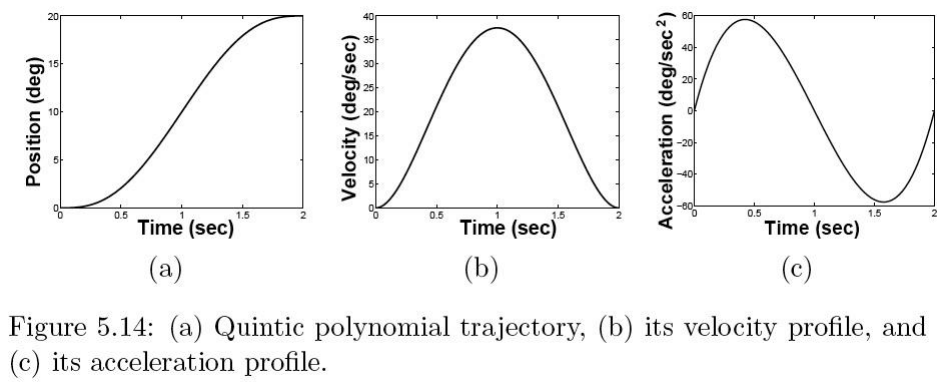
[picture p267: figure]

## 5.2 Trajectories for Point to Point Motion

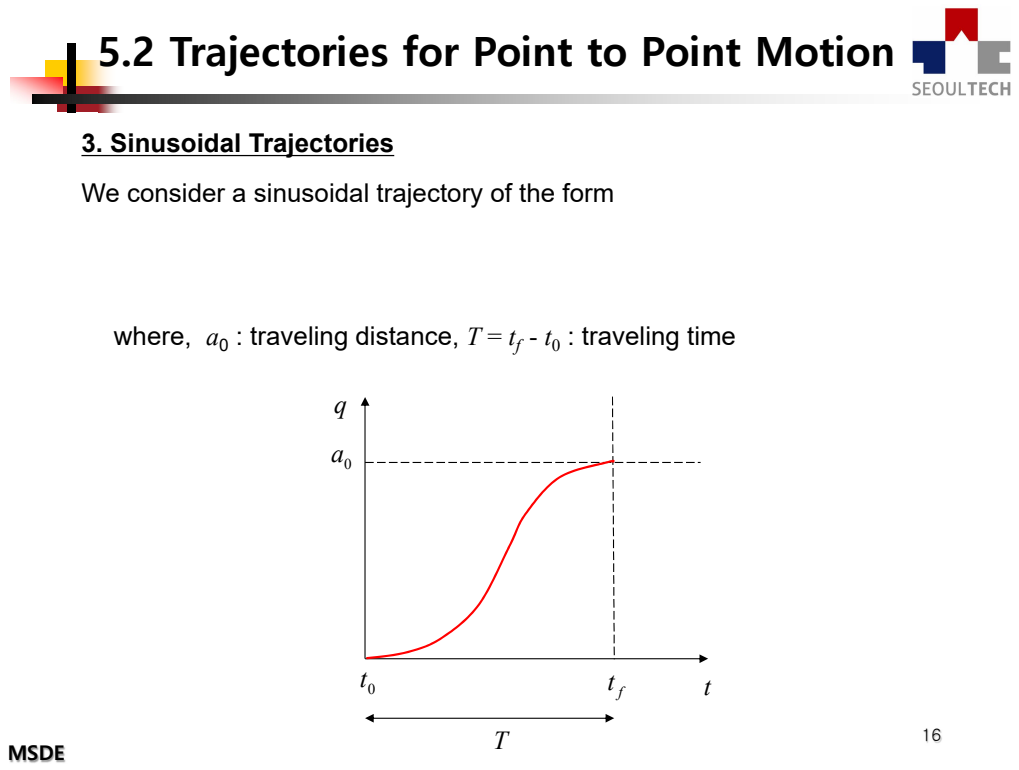
[picture p268: page 16]
3. Sinusoidal Trajectories; where, a0; : traveling distance, T = t f - t0; : traveling time

We consider a sinusoidal trajectory of the form

## 5.2 Trajectories for Point to Point Motion

If we differentiate the equation,

( ) | ( | )
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
÷ | -
ø

ö
ç
è

æ
= | × | × 0 | 0 0.5 | sin | t t
T | T
q t | a
p | p
&( ) | ( | )

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
÷ | -
ø

ö
ç
è

æ
= | × | × | 0

2
0 0.5 | cos | t t
T | T
q t | a
p | p
&& When a0 = 1, T = 1 sec (tf = 1, t0 = 0) ,

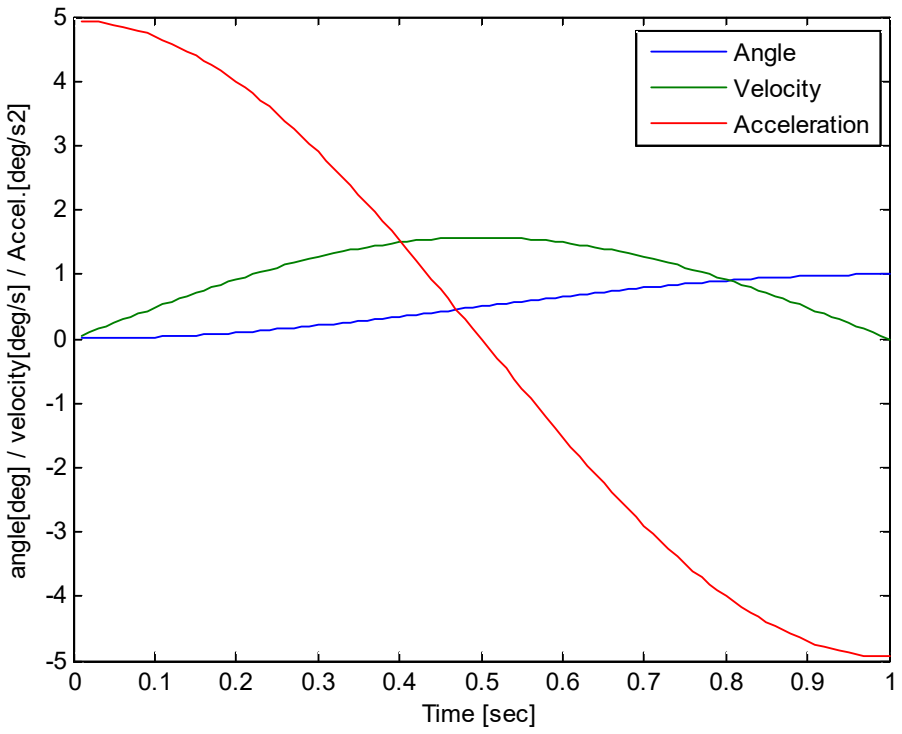
[picture p269: figure]
Time [sec]; angle[deg] / velocity[deg/s] / Accel.[deg/s2]; Angle; Velocity; Acceleration

## 5.2 Trajectories for Point to Point Motion

### 4. Linear Segments with Parabolic Blends (LSPB)

This type of trajectory has a Trapezoidal Velocity Profile and is appropriate when a constant velocity is desired along a portion of the path. To achieve this, we specify the desired trajectory in three parts.

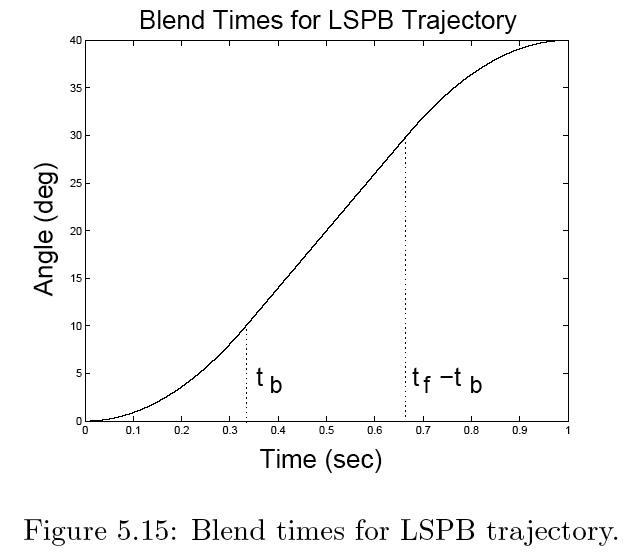
[picture p270: figure]

We choose the blend time tb so that the position curve is symmetric.

## 5.2 Trajectories for Point to Point Motion

Suppose that t0 = 0 and | . Then, between times 0 and tb , we
have

q(t ) = q(0) = 0 f & &

so that the velocity is
q(t) a | a t 1 | 2 & = | + 2
The constraints | and | imply that

0 1

0 | 0
=

=
a
a | q
( ) 0 q 0 = q | q&(0) = 0

At time tb we want the velocity to equal a given constant, say V. Thus,

q&(tb ) = 2a2
tb =V

b

t

V
a
2

\ 2 =

## 5.2 Trajectories for Point to Point Motion

Therefore, the required trajectory between 0 and tb
is given as

( )

( )

a

a

a

= | =
= | =
= | + | = | +

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
t | q | t
t

V
q t q

&&

&

2
0

2
0 | 2 | 2
where, α denotes the acceleration. Now, between time | and | , the trajectory is a linear segment with

velocity V

b

t
f b

t - t

Since, by symmetry

2 | 2
f | 0 | f t | q | q
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
## 5.2 Trajectories for Point to Point Motion

We have
( )
÷
ø

ö
ç
è

æ
= | + | -

+

b

f
b
f | t t
q t | V
q | q
2 | 2

0

( )
÷
ø

ö
ç
è

æ - -
+
\ | = | b
f | f
b
| | t

t
V

q q
q t
2 | 2

0

Since the two segments must “blend” at time tb we require

b

f | f
b | Vt q | q | Vt
t

V
q | +
+ | -
+ | =
2 | 2

0
0

V

q | q | Vt
t
f | f
b | - | +
\ =

0

Note that we have the constraints | . This leads to the inequality 2
| 0

f
b

t
< t £
( )

V

q q
t
V
q | q | f

f

f | 0 | 0 2 | -
< | £

## 5.2 Trajectories for Point to Point Motion

The portion of the trajectory between | and | is now found by symmetry
considerations. The complete LSPB trajectory is given by

f b

t - t
f t

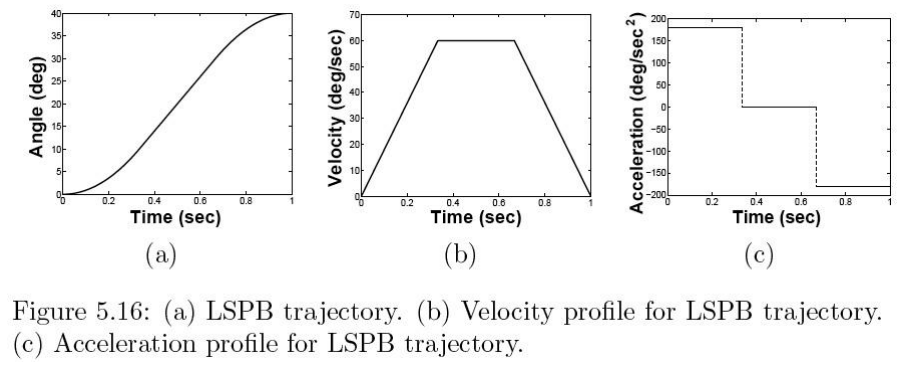
[picture p271: figure]

## 5.3 Trajectories for Paths Specified by Via Points

We generalize our approach to the case of planning a trajectory that passes through a sequence of configurations, called via points. Consider the simple example of a path specified by three points, q0
, q1

, and
q2

, such that the via points are reached at times t0

, t1 and t2

, respectively.
In addition, we impose constraints on the initial and final velocities and accel. ( )

( )
( )
( )
( )
( )
( ) 2 | 2
2 | 2
2 | 2
1 | 1
0 | 0
0 | 0
0 | 0

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
q t | v
q t | q
q t | q

q t

q t | v
q t | q

&&

&

&&

&

The above constraints could be satisfied by generating a trajectory using the 6

th order polynomial
( )
0 | 1 | 2 q t = a + a t + a t + a t + a t + a t + a t

## 5.3 Trajectories for Paths Specified by Via Points

To determine the coefficients for the above polynomial, we must solve a linear system of dimension 7. The clear disadvantage is that as the number of via points increases, the

dimension of the corresponding linear system also increases, making the method intractable when many via points are used. An alternative method is to use low order polynomials for trajectory

segments between adjacent via points.

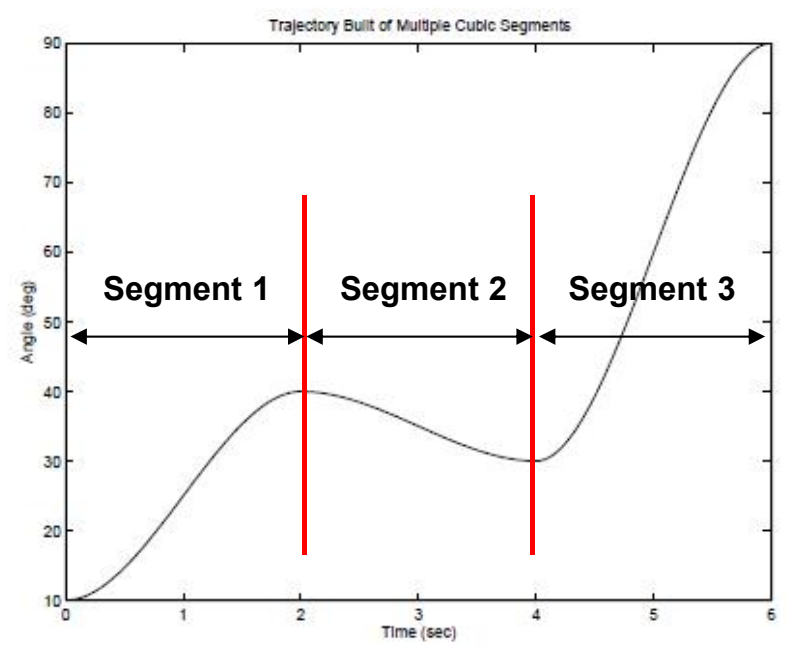
[picture p272: figure]
Segment 1; Segment 2; Segment 3

## 5.3 Trajectories for Paths Specified by Via Points

For the first segment of the trajectory, suppose that the initial and final times are t0 and t

f, respectively, and the constraints on initial and final velocities are given by
( ) | ( )
( ) | ( ) 0 | 0 | 1
0 | 0 | 1
;

;

q t | v | q t | v
q t | q | q t | q

f

f
= | =
= | =
& | &

The required cubic polynomial for this segment of the trajectory can be computed from
( ) | ( | ) | ( | ) | ( | )
| | | | | | 3
3 | 0

2
0 | 1 | 0 | 2 | 0 q t = a + a t - t + a t - t | + a t - t
( ) | ( | ) | ( | )
2
1 | 2 | 0 | 3 | 0 q& t = a t + 2a t - t + 3a t - t

where

## 5.3 Trajectories for Paths Specified by Via Points

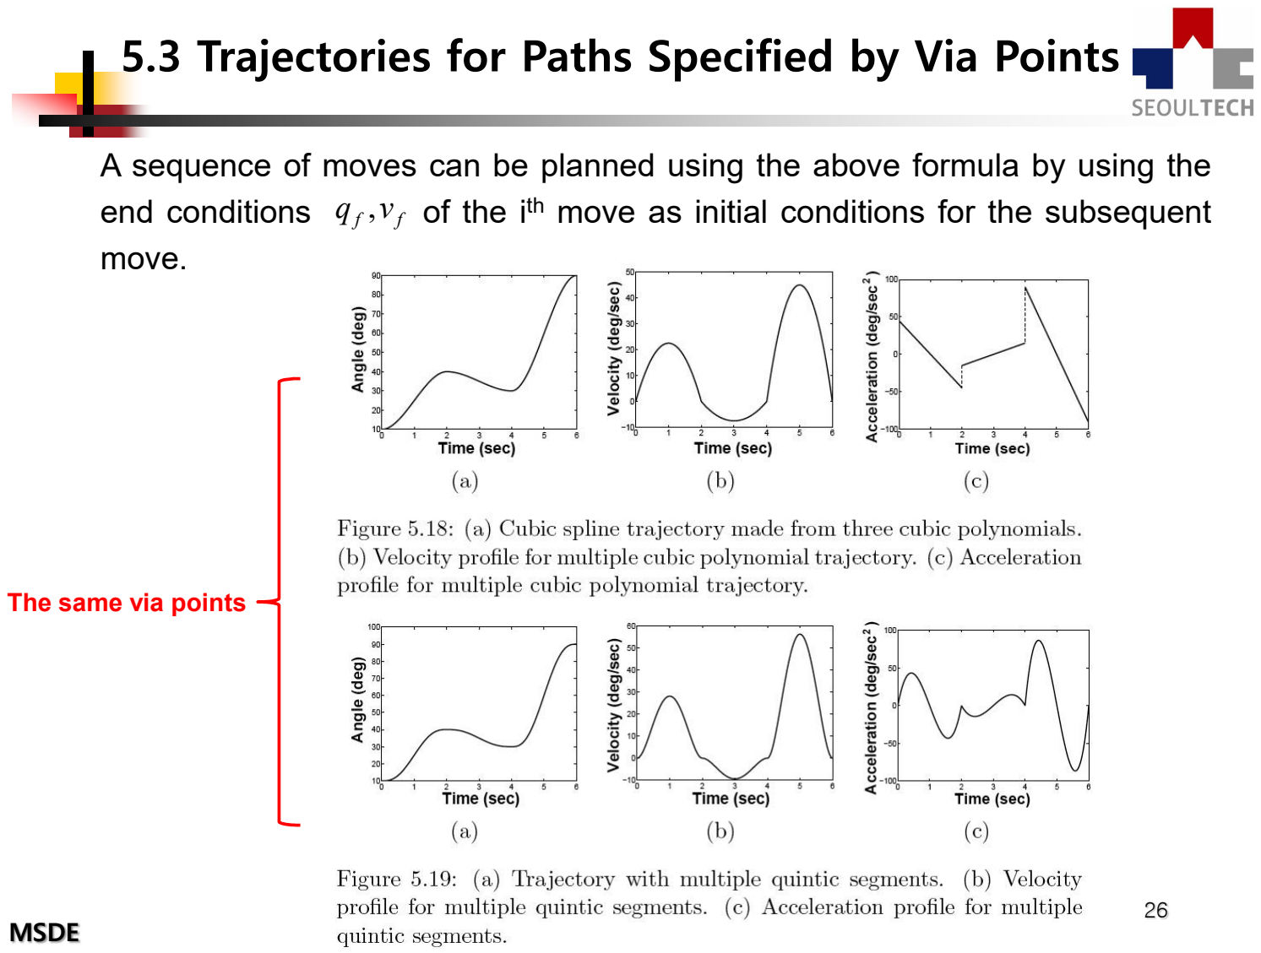
[picture p273: page 26]

A sequence of moves can be planned using the above formula by using the
end conditions | of the i

th move as initial conditions for the subsequent

move. | f | f q ,v

The same via points
