kongshyun/2022Capstone-AGV/last_year/ros-seminar-master/01_로봇_소프트웨어_플랫폼.pdf

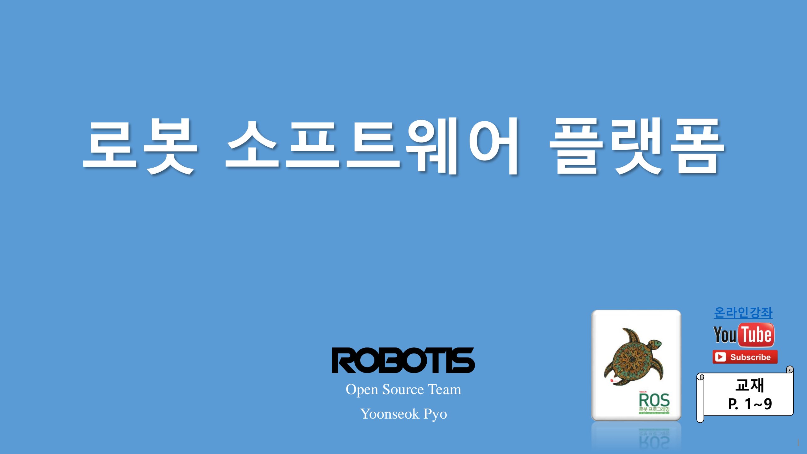
[picture p274: page 1]

# 로봇 소프트웨어 플랫폼

## Yoonseok Pyo

## Open Source Team

교재

## P. 1~9 (http://book.naver.com/bookdb/book_detail.nhn?bid=12443870)

## 온라인강좌 (https://www.youtube.com/playlist?list=PLRG6WP3c31_VIFtFAxSke2NG_DumVZPgw)

# Contents

# I. 플랫폼의 구성 요소

# II. 로봇 소프트웨어 플랫폼

# III. 로봇 소프트웨어 플랫폼의 필요성


# IV. 로봇 소프트웨어 플랫폼의 필요성이 가져올 미래

교재

## P. 1~9 (http://book.naver.com/bookdb/book_detail.nhn?bid=12443870)

## 온라인강좌 (https://www.youtube.com/playlist?list=PLRG6WP3c31_VIFtFAxSke2NG_DumVZPgw)

# 이 두 가지의 공통점은?

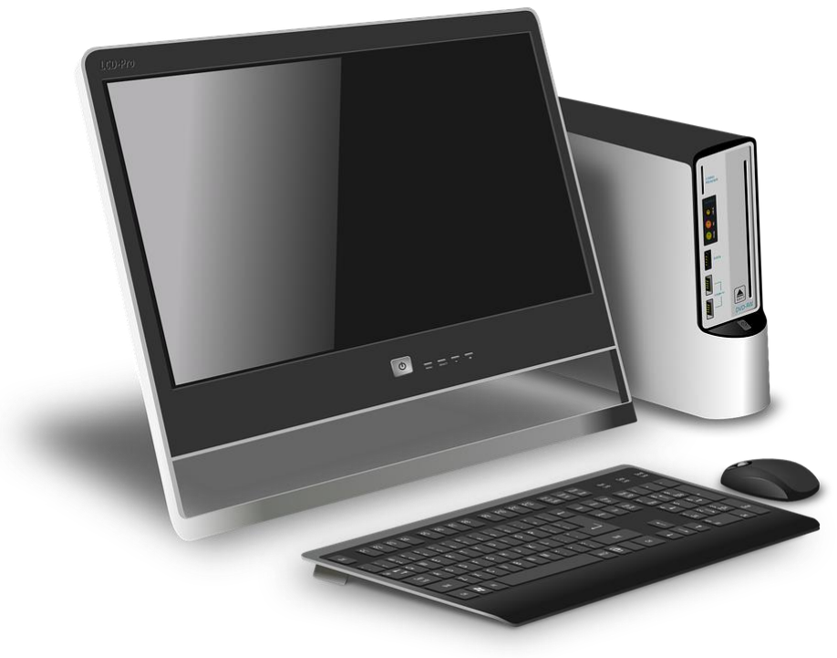
[picture p275: figure]
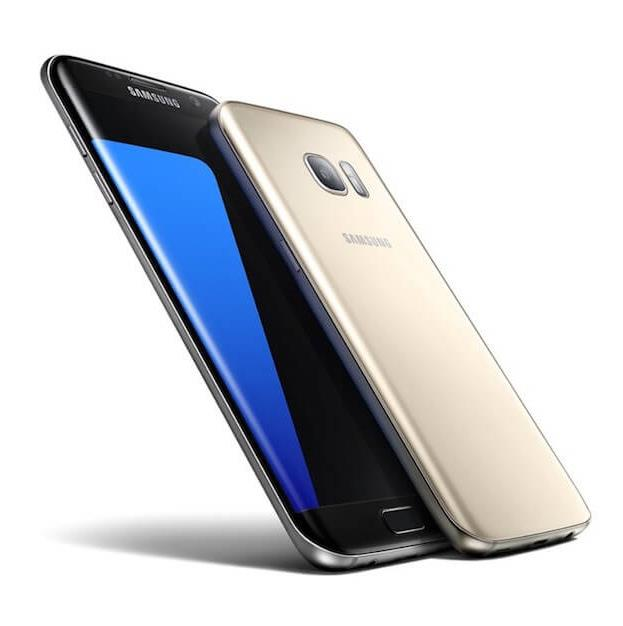
[picture p276: figure]

https://pixabay.com/en/computer-desktop-modern-device-154114/ , https://commons.wikimedia.org/wiki/File:Samsung-Galaxy-S7-Edge-Smartphone.jpg | 3
Personal Computer | Personal Phone

# 누구나

# 하나쯤은 보유하고 있는 대중화 제품

# 다양한 하드웨어의 결합이 가능한 하드웨어 모듈

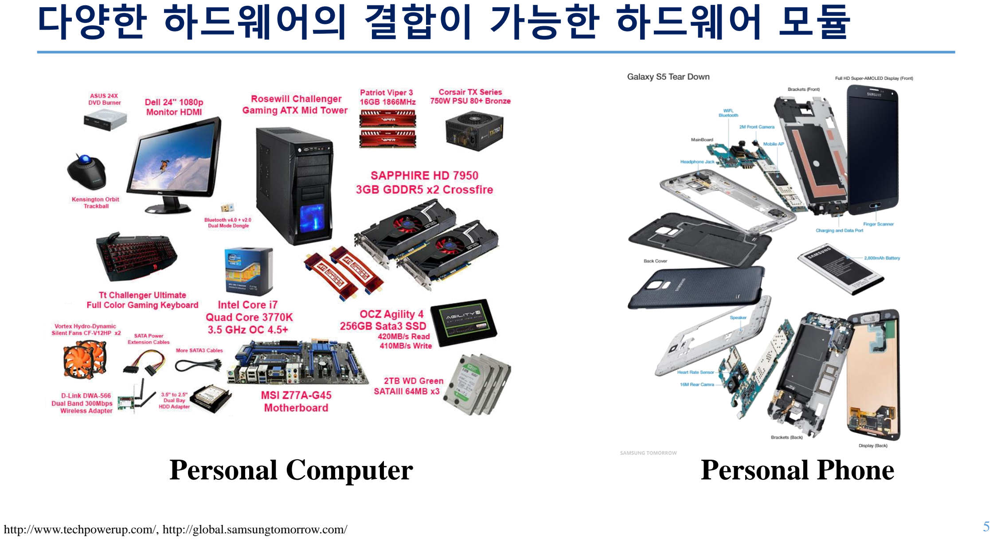
[picture p277: page 5]

http://www.techpowerup.com/, http://global.samsungtomorrow.com/

Personal Computer | Personal Phone

# 운영 체제 (Operating System) + 애플리케이션(App)

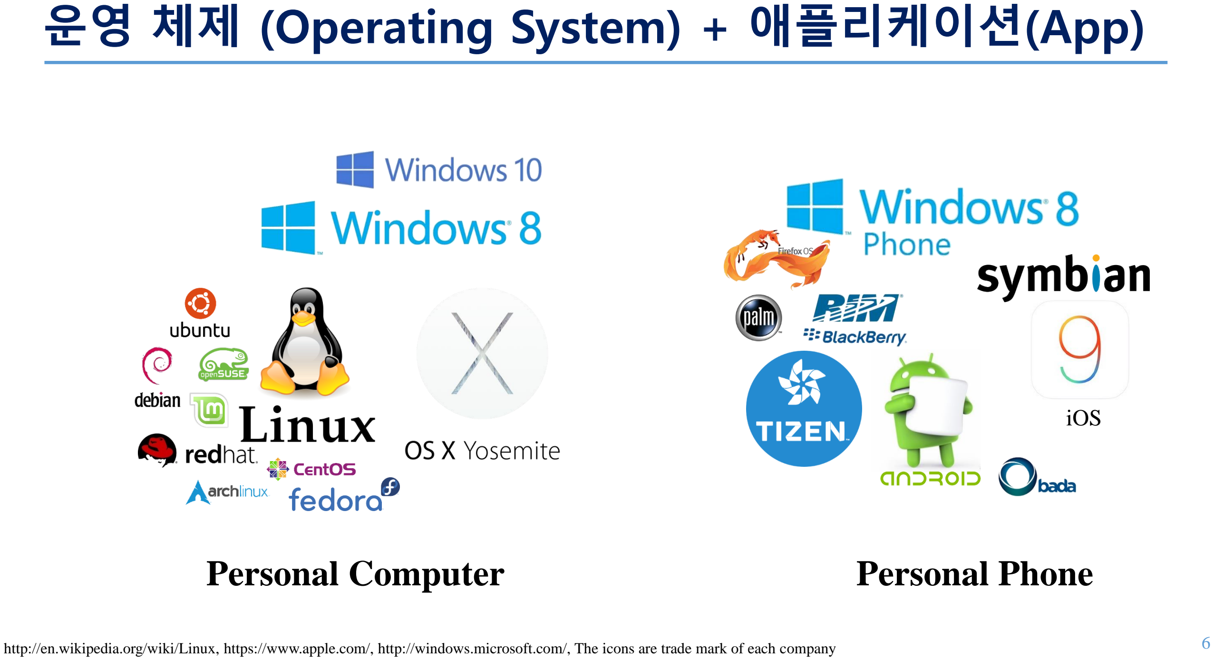
[picture p278: page 6]

6 http://en.wikipedia.org/wiki/Linux, https://www.apple.com/, http://windows.microsoft.com/, The icons are trade mark of each company

## iOS

Personal Computer | Personal Phone

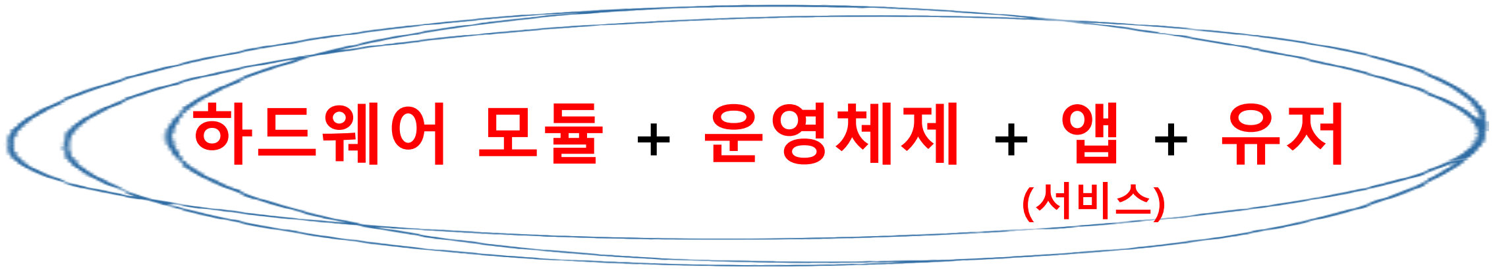
[picture p279: figure]
하드웨어 모듈 + 운영체제 + 앱 + 유저; (서비스)

# 보이지 않는 생태계 속의 분업

# 그렇다면

# 로봇분야는?

# 로봇 개발

혼자 다 하려 해;;

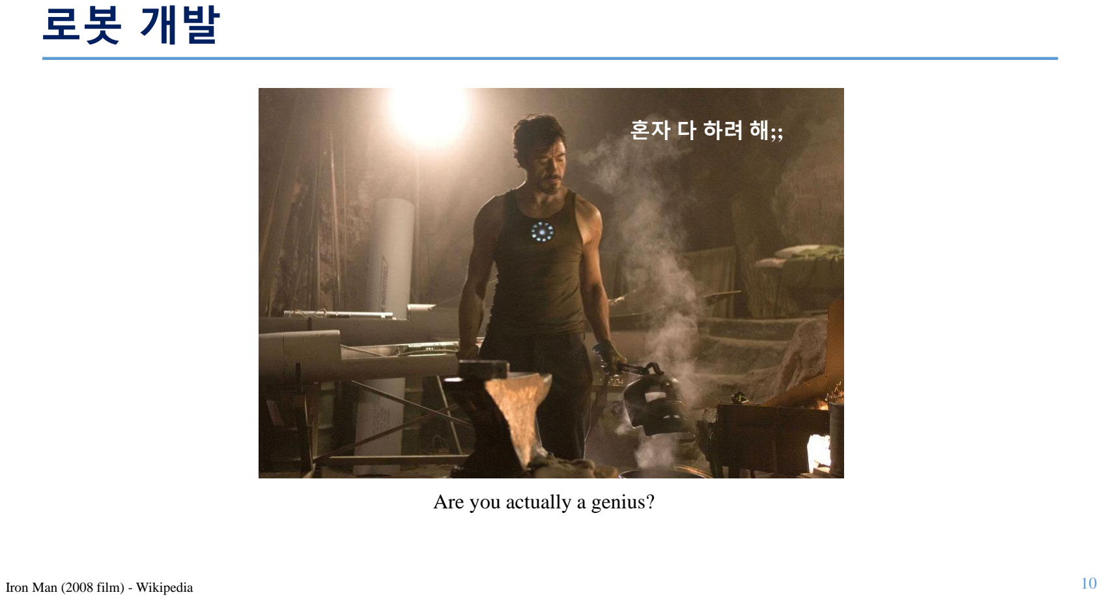
[picture p280: page 10]

Iron Man (2008 film) - Wikipedia | 10

## Are you actually a genius?

# 지금 시대가

어느 시대인데...

# 소프트웨어 플랫폼이 가져온 변화

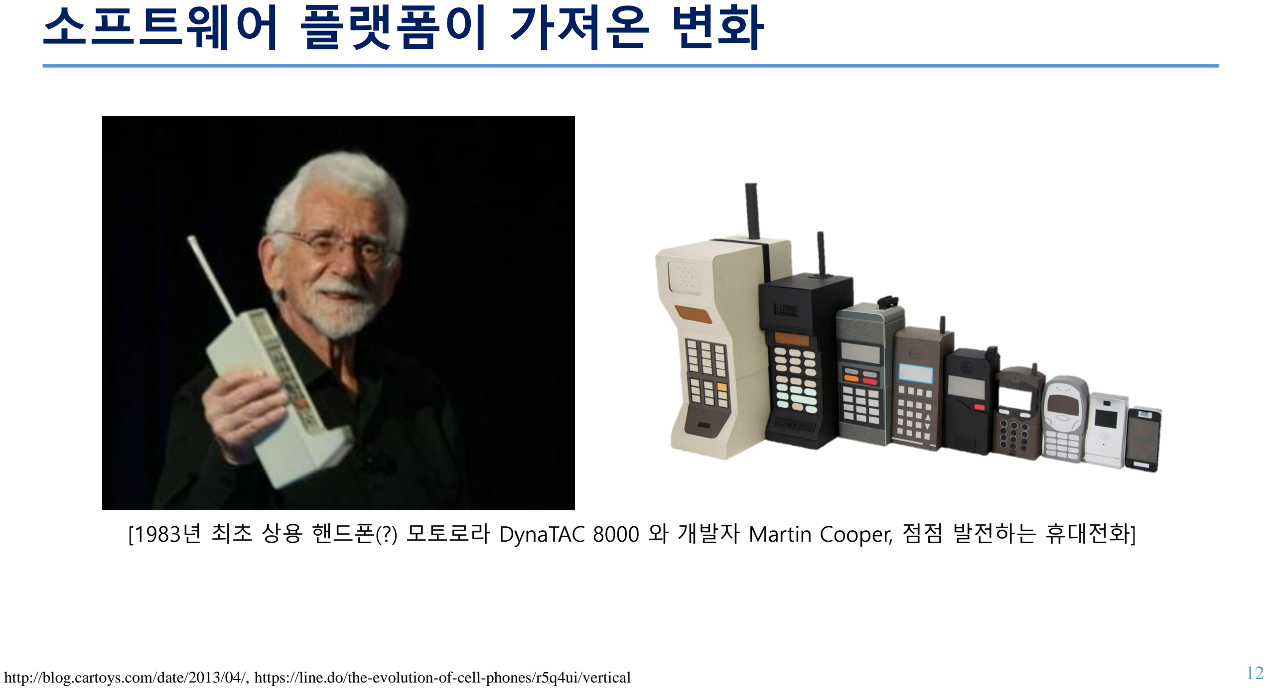
[picture p281: page 12]

## [1983년 최초 상용 핸드폰(?) 모토로라 DynaTAC 8000 와 개발자 Martin Cooper, 점점 발전하는 휴대전화]

http://blog.cartoys.com/date/2013/04/, https://line.do/the-evolution-of-cell-phones/r5q4ui/vertical

# 소프트웨어 플랫폼이 가져온 변화

# - 하드웨어 인터페이스 통합

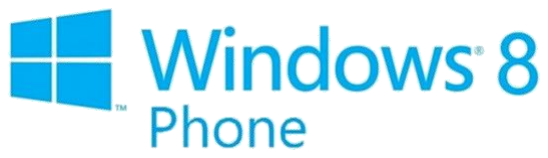
[picture p282: figure]

# - 하드웨어 추상화・규격화・모듈화

# - 가격 ↓, 성능 ↑

# - 하드웨어 ・ 운영체제 ・ 애플리케이션 분리

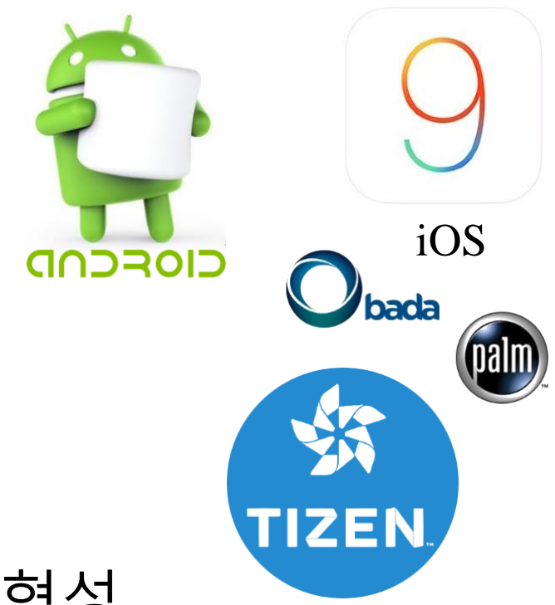
[picture p283: figure]
iOS

# - 유저 증가! 구매와 피드백, 새로운 생태계의 선환 구조 형성

# 로봇분야는? 로봇 운영체제의 춘추전국시대!!!

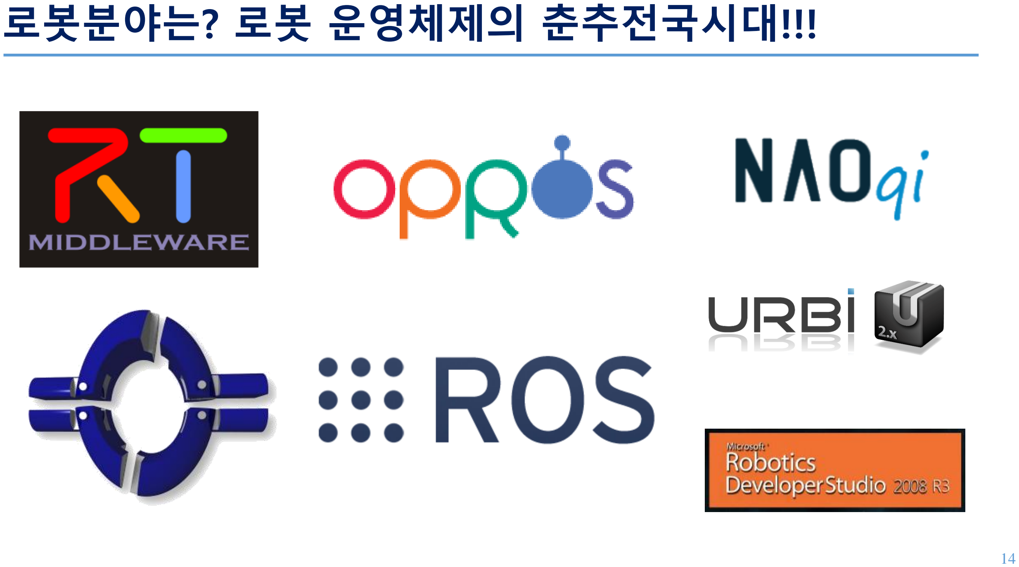
[picture p284: page 14]

# 주요 로봇 운영체제

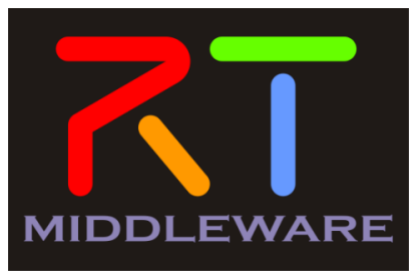
[picture p285: figure]
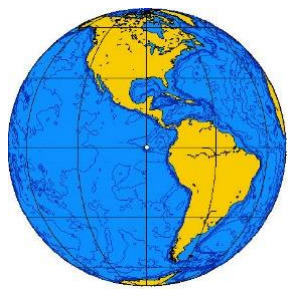
[picture p286: figure]

http:// ros.org kr.forwallpaper.com http://www.softbank.jp/en/corp/group/sbr/ http://www.opros.or.kr/ http://www.openrtm.org/ http://schools-wikipedia.org/ | 15

## Galapagos

## Closed source

## Open source

# 주요 로봇 운영체제

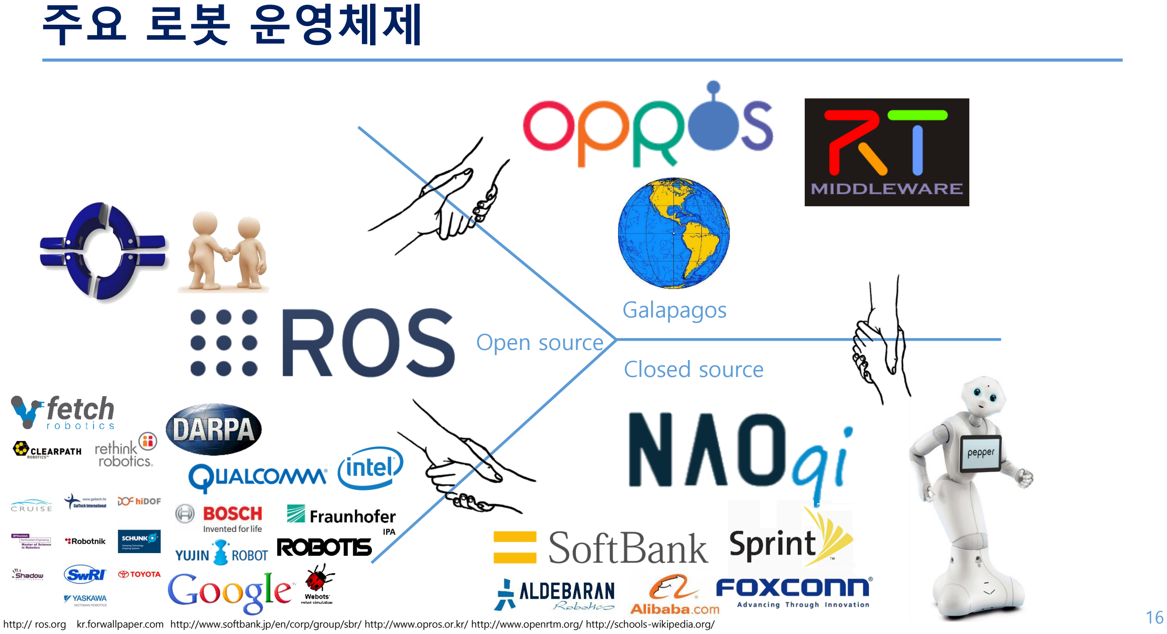
[picture p287: page 16]

http:// ros.org kr.forwallpaper.com http://www.softbank.jp/en/corp/group/sbr/ http://www.opros.or.kr/ http://www.openrtm.org/ http://schools-wikipedia.org/ | 16

## Galapagos

## Closed source

## Open source

# 뭐가 제일 좋아요?

# 뭐가 제일 좋아요?

# 여러 의미로 제일 어려운 질문이네요!

다르게 생각해봅시다.

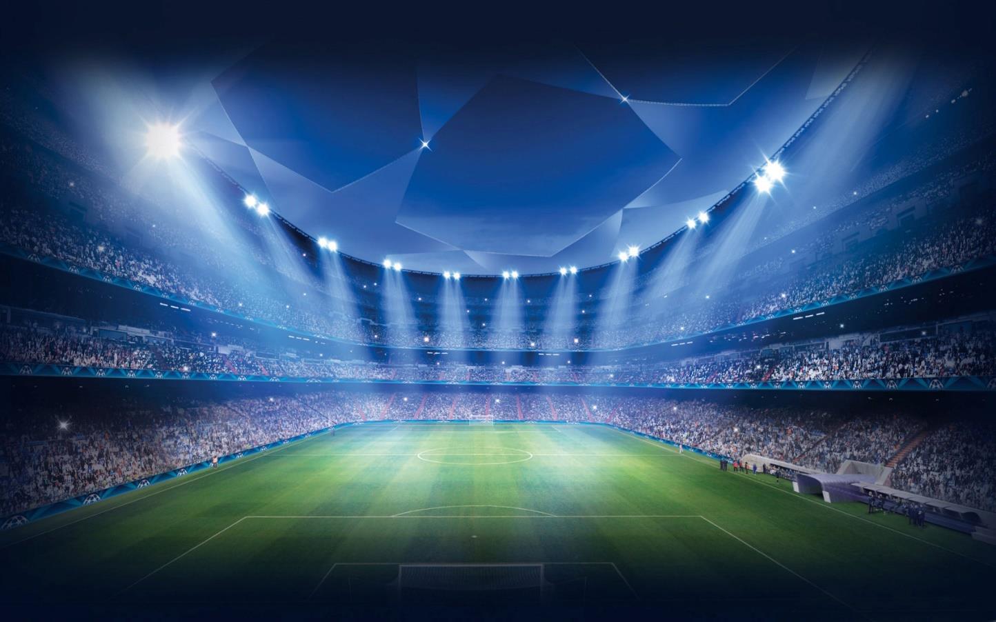
[picture p288: figure]

http://www.greaterlasvegashomes.com/files/2014/09/soccer-stadium-.jpg

# 운동장 만들기 소모전은 이제 그만!

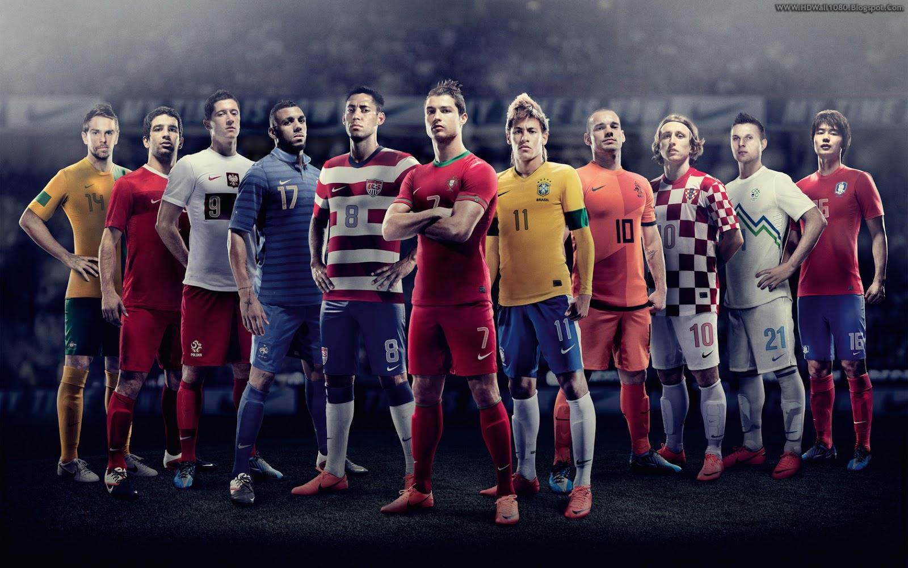
[picture p289: figure]

http://www.wallpaper505.com/the-best-world-football-players-2014-2015-best-desktop-wallpaper.html

# 그라운드 위의 멋진 선수를 꿈꾸자!

# 로봇 소프트웨어 플랫폼이 가져올 미래

# - 하드웨어 플랫폼과의 소프트웨어 플랫폼간의 인터페이스 확립

# - 모듈형 하드웨어 플랫폼 확산

# - 하드웨어에 대한 지식이 없어도 응용 프로그램 작성 가능 (있다면 더 좋고 )

# - 더 많은 소프트웨어 인력들이 로보틱스 분야로 진입, 로봇 제품에 참여 가능

# - 유저에게 제공할 서비스에 집중

# - 실수요가 있는 서비스 제공으로 유저계층 형성 및 피드백

# - 로봇 개발이 급속도로 발전 할 수 있는 계기

# 역사는 반복된다! 준비는 되어 있나요?

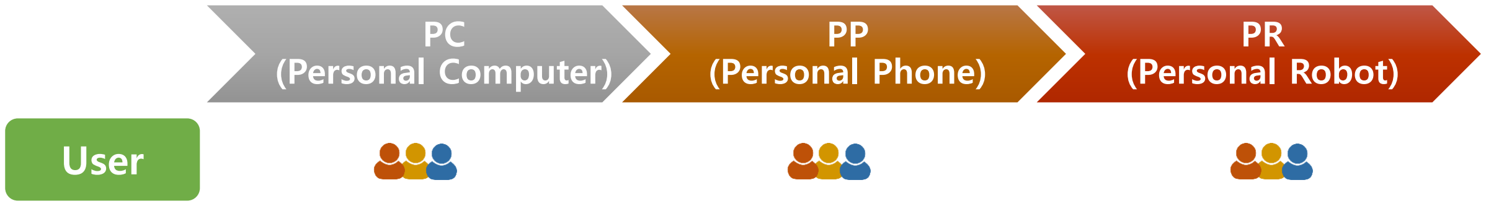
[picture p290: figure]
PC (Personal Computer); PP (Personal Phone); PR (Personal Robot); User
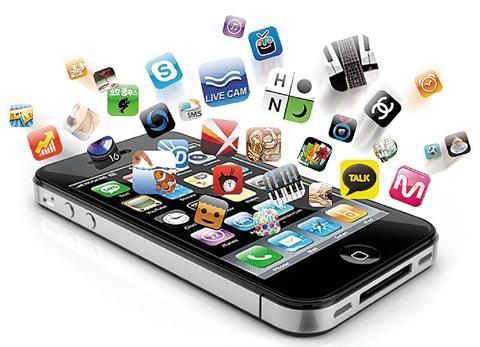
[picture p291: figure]
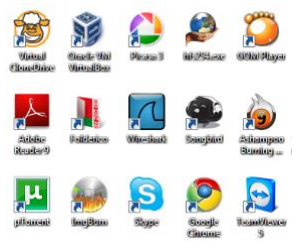
[picture p292: figure]
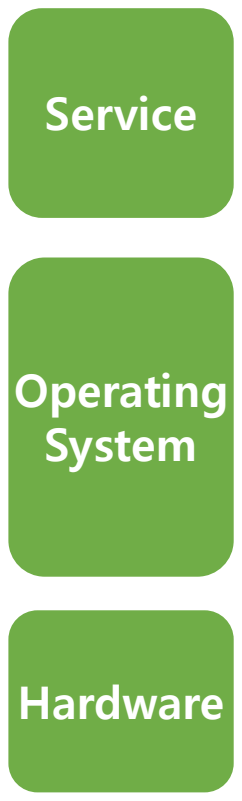
[picture p293: figure]
Service; Operating System; Hardware
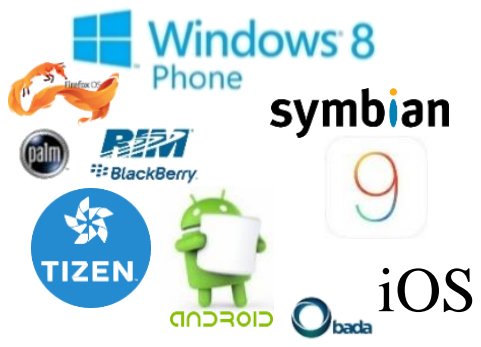
[picture p294: figure]
iOS
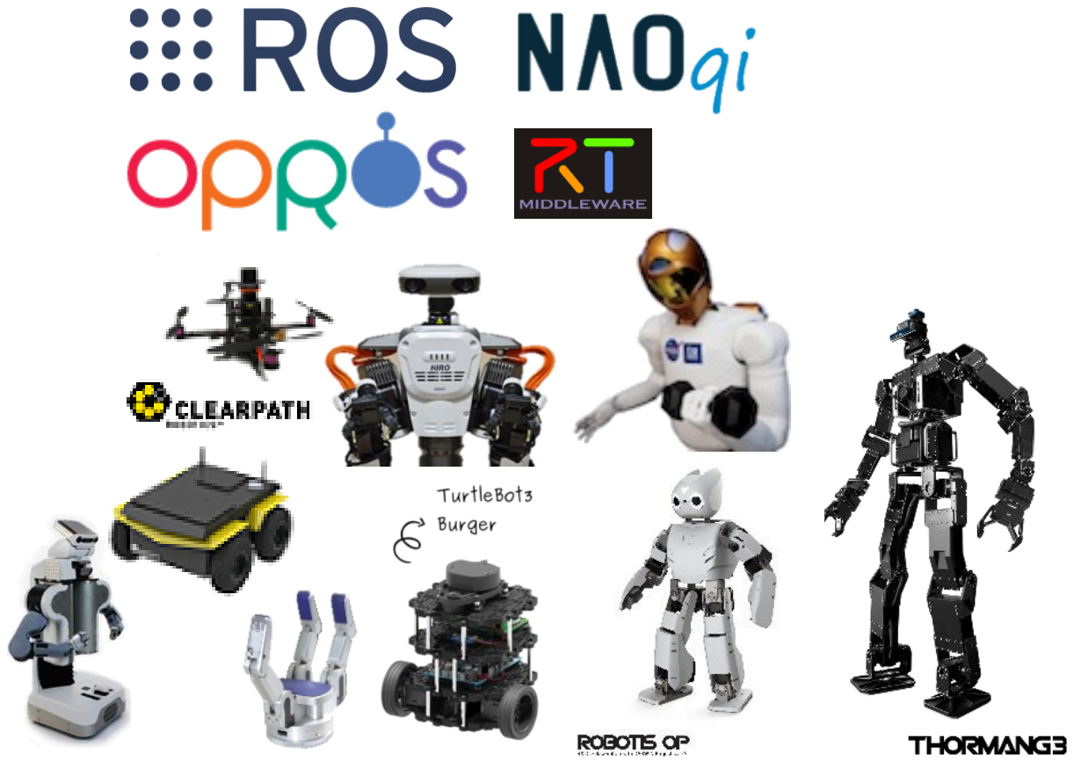
[picture p295: figure]
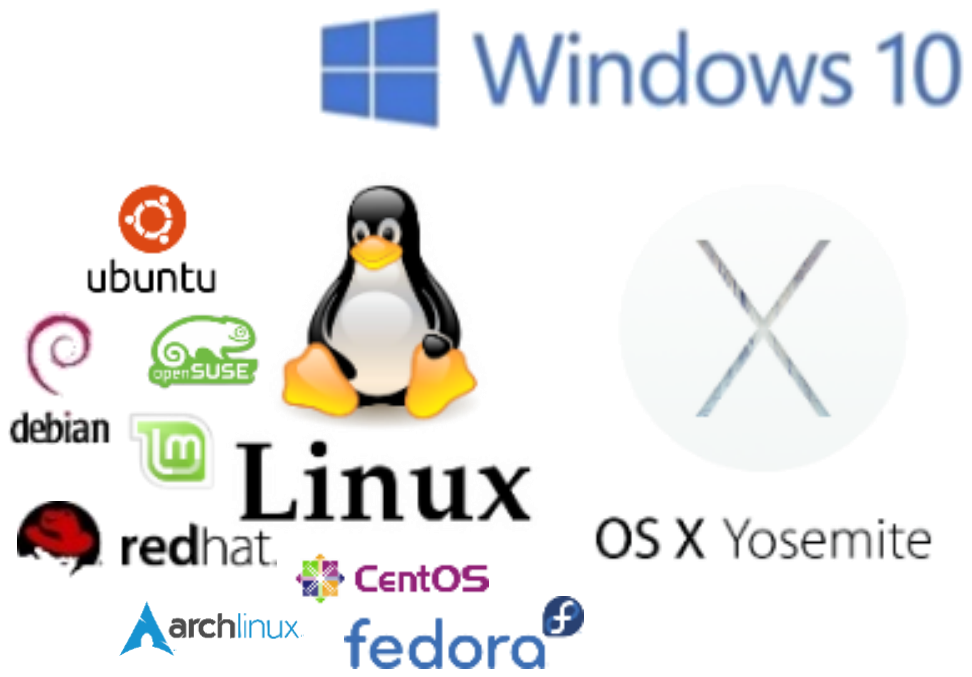
[picture p296: figure]
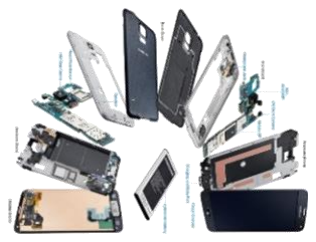
[picture p297: figure]
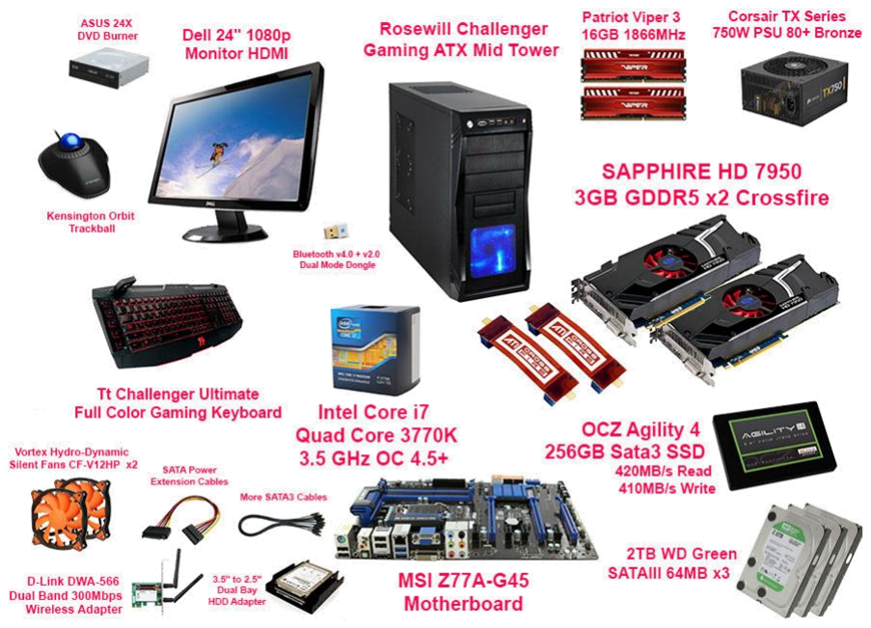
[picture p298: figure]

질문

# 대환영!

# * 온라인 상의 질문이라면 오로카 및 로열모를 이용해주세요!

# 여기서! 광고 하나 나가요~


# 국내 유일! 최초! ROS 참고서! ROS 공식 플랫폼 TurtleBot3 개발팀이

# 직접 저술한 바이블급 ROS 책

# 한국어판 구매 링크 (http://book.naver.com/bookdb/book_detail.nhn?bid=12443870)

# 4개 언어로 출판! (http://emanual.robotis.com/docs/en/platform/turtlebot3/learn/#books)

# 여기서! 광고 둘 나가요~

인공지능(AI) 연구의 시작,

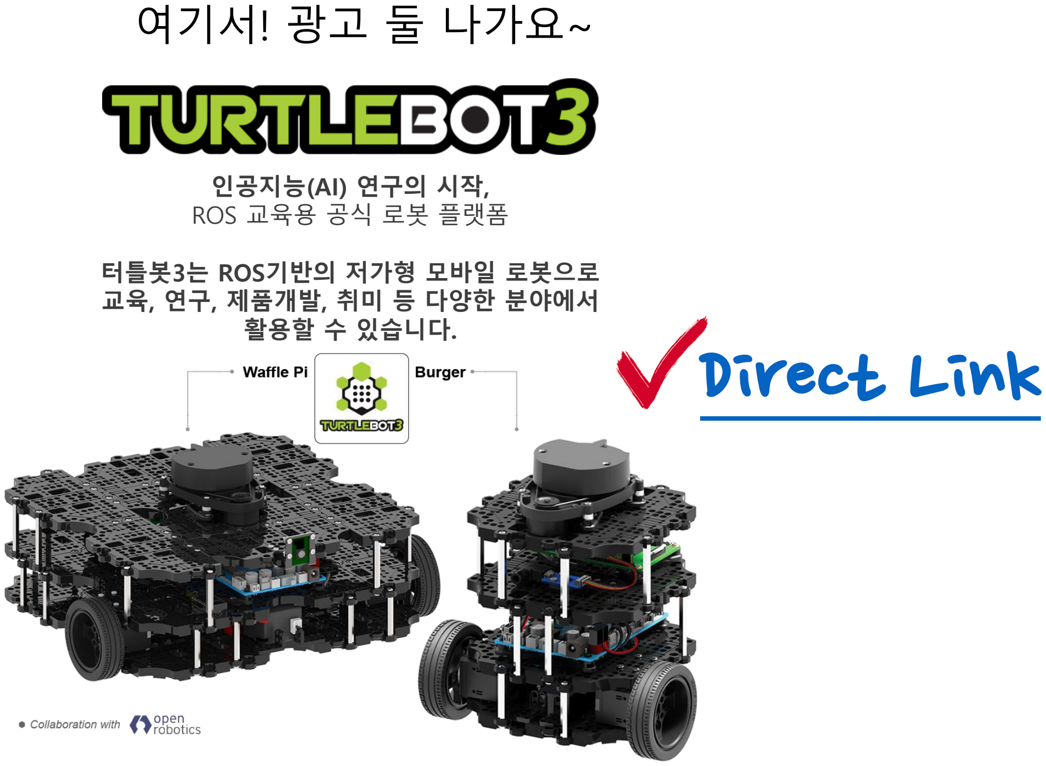
[picture p299: page 25]

# Direct Link (http://www.robotis.com/model/board.php?bo_table=print&wr_id=36)

## ROS 교육용 공식 로봇 플랫폼

## 터틀봇3는 ROS기반의 저가형 모바일 로봇으로 교육, 연구, 제품개발, 취미 등 다양한 분야에서

활용할 수 있습니다.

# 여기서! 광고 셋 나가요~


### - 오로카 - www.oroca.org - 오픈 로보틱스 지향

## - 풀뿌리 로봇공학의 저변 활성화 - 공개 강좌, 세미나, 프로젝트 진행


### - 로봇공학을 위한 열린 모임 (KOS-ROBOT) - www.facebook.com/groups/KoreanRobotics

## - 로봇공학 통합 커뮤니티 지향 - 일반인과 전문가가 어울러지는 한마당 - 로봇공학 정보 공유 - 연구자 간의 협력

# 혼자 하기에 답답하시다고요? 커뮤니티에서 함께 해요~

### - RobotSource - www.robotsource.org

## - 글로벌 로보틱스 커뮤니티 지향 - 로봇공학 정보 공유 - 자신의 로봇 프로젝트 공유

### - DIY 로봇 프로젝트 진행


### Yoonseok Pyo pyo@robotis.com www.robotpilot.net

# 표윤석

## www.facebook.com/yoonseok.pyo

끝.
