kongshyun/2022Capstone-AGV/last_year/ros-seminar-master/12_서비스_로봇.pdf

서비스 로봇

Yoonseok Pyo

Open Source Team

교재

### P. 378~414 (http://book.naver.com/bookdb/book_detail.nhn?bid=12443870)

온라인강좌 (https://www.youtube.com/playlist?list=PLRG6WP3c31_VIFtFAxSke2NG_DumVZPgw)

# Contents

# I. 배달 서비스 로봇

# II. 배달 서비스 로봇의 구성

# III. ROS Java를 이용한 안드로이드 태블릿 PC 프로그래밍


교재

### P. 378~414 (http://book.naver.com/bookdb/book_detail.nhn?bid=12443870)

온라인강좌 (https://www.youtube.com/playlist?list=PLRG6WP3c31_VIFtFAxSke2NG_DumVZPgw)

# 서비스 로봇을 만들어 보자!

# Delivery Service Robot


https://youtu.be/u7qb8xiSiNg

# 하드웨어 구성: 로봇+모니터링 PC+주문용 태블릿


### 패드상에서 작동되는 메뉴판 예시 (안드로이드 기반 태블릿) 배달 서비스 로봇과 운용 시스템의 사진

### 각 컴퓨터에서 실행한 RViz에서 표시하는 각 로봇의 내비게이션 화면

# 멀티 서비스 로봇의 시스템 설계 예시

서비스 마스터 | 서비스 코어 | 서비스 슬레이브

E-Menu Tablet 1; E-Menu Tablet 2; Service Robot 1; Service Robot 2; Service Core; E-Menu Tablet 3; Service Robot 3

# 배달 서비스 로봇 시스템에서의 각 영역의 메시지 송수신 예

E-Menu Tablet | Service Core | Service Robot

패드 ID

### 주문한 아이템

### 주문 가능한 아이템 로봇의 서비스 상황

### 목표 위치 좌표

### 로봇의 서비스 상황

# 배달 서비스 로봇의 노드 구조 예시


# service_core 노드가 송수신하는 토픽 목록


# 서비스의 준비 순서도

True; 맵이 이미 있는가?; 맵 상의 좌표를 알고 있는가?; False; 로봇의 내비게이션 목적지 지정 및; 초기화 위치로 이동; 서비스 코어 실행; E-Menu 가동; 로봇 서비스 테스트

로봇 한 대를 사용하여
SLAM 실행

내비게이션에서 자세 추정 실행 후
적절한 움직임으로 자세 초기화 실행

다른 로봇에도 맵을 공유

그 좌표 값을 ROS 파라미터에 적용

# 서비스 선택

# - 패드상에서 작동되는 메뉴판 (안드로이드 기반 태블릿 + ROSJAVA)


# 서비스 로봇 제작 사례를 기대해 봅니다!

# Delivery Service Robot


https://youtu.be/5NYdgnzxykc

# 다양한 활용

## - https://www.youtube.com/c/ROBOTISOpenSourceTeam


## - http://emanual.robotis.com/docs/en/platform/turtlebot3/projects/#projects

- Awesome TurtleBot3 Projects (https://www.youtube.com/playlist?list=PLRG6WP3c31_WiSi5ZAMkaNy1_vbudTmmM)

질문

# 대환영!

# * 온라인 상의 질문이라면 오로카 및 로열모를 이용해주세요!

# 여기서! 광고 하나 나가요~


# 국내 유일! 최초! ROS 참고서! ROS 공식 플랫폼 TurtleBot3 개발팀이

# 직접 저술한 바이블급 ROS 책

# 한국어판 구매 링크 (http://book.naver.com/bookdb/book_detail.nhn?bid=12443870)

# 4개 언어로 출판! (http://emanual.robotis.com/docs/en/platform/turtlebot3/learn/#books)

# 여기서! 광고 둘 나가요~


# Direct Link (http://www.robotis.com/model/board.php?bo_table=print&wr_id=36)

인공지능(AI) 연구의 시작,
ROS 교육용 공식 로봇 플랫폼

터틀봇3는 ROS기반의 저가형 모바일 로봇으로
교육, 연구, 제품개발, 취미 등 다양한 분야에서 활용할 수 있습니다.

# 여기서! 광고 셋 나가요~


- 오로카
- www.oroca.org
- 오픈 로보틱스 지향
- 풀뿌리 로봇공학의 저변 활성화
- 공개 강좌, 세미나, 프로젝트 진행


- 로봇공학을 위한 열린 모임 (KOS-ROBOT)
- www.facebook.com/groups/KoreanRobotics
- 로봇공학 통합 커뮤니티 지향
- 일반인과 전문가가 어울러지는 한마당
- 로봇공학 정보 공유
- 연구자 간의 협력

# 혼자 하기에 답답하시다고요? 커뮤니티에서 함께 해요~

- RobotSource
- www.robotsource.org
- 글로벌 로보틱스 커뮤니티 지향
- 로봇공학 정보 공유
- 자신의 로봇 프로젝트 공유
- DIY 로봇 프로젝트 진행


Yoonseok Pyo
pyo@robotis.com
www.robotpilot.net

# 표윤석

www.facebook.com/yoonseok.pyo

끝.
