kongshyun/2022Capstone-AGV/last_year/Capstone/mapping_rqt.png

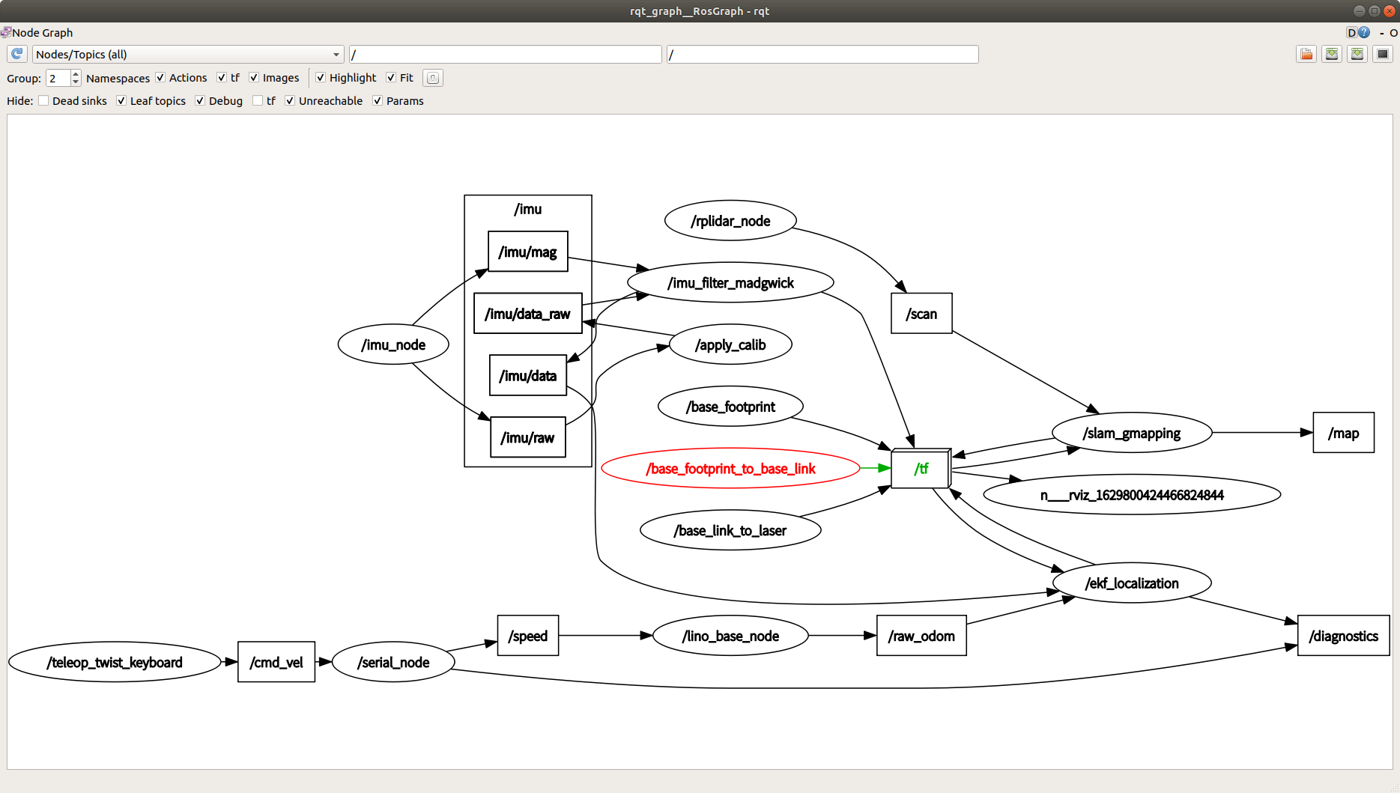
last_year/Capstone/mapping_rqt.png
