kongshyun/2022Capstone-AGV/last_year/Capstone/car_sample/meshes/lf_link.STL

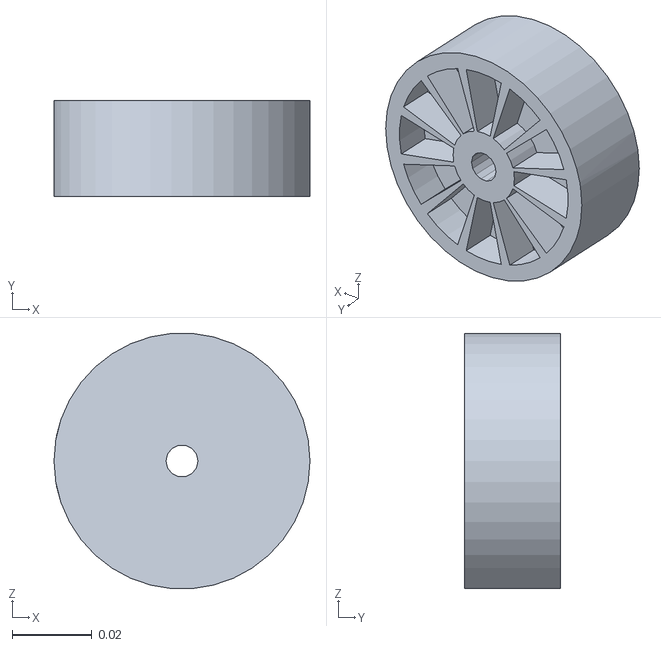
[picture p303: CAD file, 2022-08-23]
last_year/Capstone/car_sample/meshes/lf_link.STL
0.064 x 0.024 x 0.0638
