kongshyun/2022Capstone-AGV/last_year/Capstone/car_sample/meshes/rr_link.STL

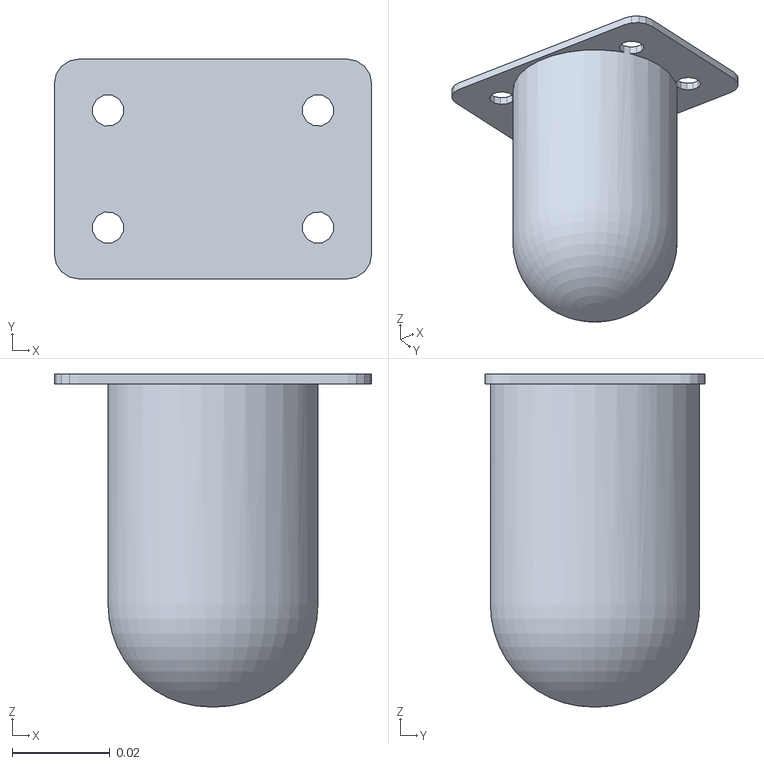
[picture p304: CAD file, 2022-08-23]
last_year/Capstone/car_sample/meshes/rr_link.STL
0.065 x 0.045 x 0.0682
