kongshyun/2022Capstone-AGV/last_year/Capstone/car_sample/meshes/base_link.STL

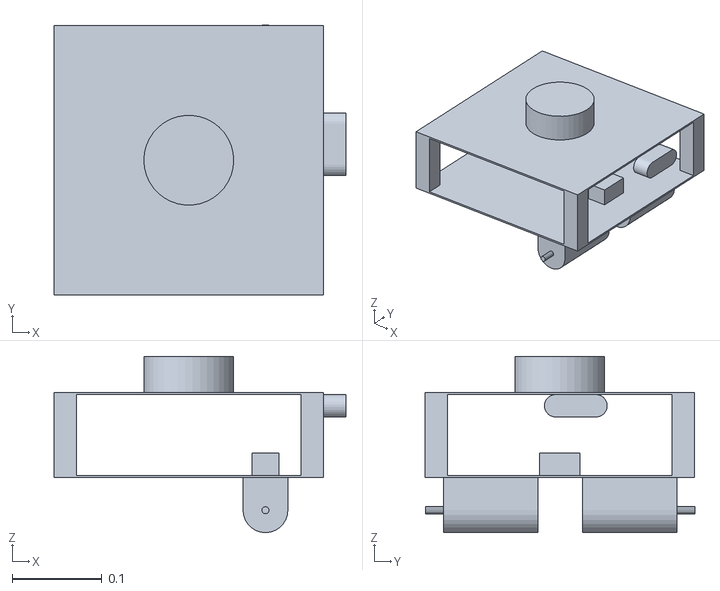
[picture p305: CAD file, 2022-08-23]
last_year/Capstone/car_sample/meshes/base_link.STL
0.325 x 0.301 x 0.196
