kongshyun/2022Capstone-AGV/(list of files, cad)

Other CAD files:
last_year/Capstone/car_sample/meshes/rf_link.STL
last_year/Capstone/car_sample/meshes/base_footprint_link.STL
last_year/Capstone/car_sample/meshes/lr_link.STL
