kongshyun/2022Capstone-AGV/(commit log)

2022-06-24 Create ROS 용어
2022-06-24 Create 사이트
2022-06-24 Update 사이트
2022-06-27 Update and rename 사이트 to 요약정리
2022-08-19 Create 외장하드에 우분투,로스 설치
2022-08-19 Create 터미널 단축키 및 방법
2022-08-19 Update 터미널 단축키 및 방법
2022-08-25 Create 진행과정
2022-08-25 Update and rename 진행과정 to ♡진행과정♥
2022-08-25 Update ♡진행과정♥
2022-08-26 error
    error
    [base_footprint_link.STL, base_link.STL, car_sample.csv, car_sample.urdf, lf_link.STL, lr_link.STL, rf_link.STL, rr_link.STL]
2022-09-15 Update encoder_data_test1.ino
    //AGV_teleop_key 노드에서 키보드제어를 받고, "Hello"문자열을 발행하는 노드
2022-10-02 rosserial통해 ros에서 키보드 입력시 DC모터 제어하는 코드
    //115200에서 안된다
    //속도프로파일 한번하고 헛돈다
2022-10-03 Add files via upload
    Arduino_Codes의 DC-24V-PID-double2.ino와 되는 코드
2022-10-12 Add files via upload
    3차 발표 코드(거리수정 전) / imu값으로 yaw P게인으로 직선주행 피드백 알고리즘
    [final_ebimu_yaw.ino]
2022-10-21 Update final_ebimu2.ino
    3차발표 시연 코드
2022-11-01 4차발표 key명령 python 노드
2022-11-01 4차발표 전체 테스트1
2022-11-01 Agv_imu_test1에서 imu값 sub받는 코드
2022-11-01 //4차발표 key publish 파이썬 노드
2022-11-01 11월 1일자
2022-11-02 3차발표 코드, 메가하나로 문워커 Agv+ Stabil코드(짐벌x)
2022-11-02 EBimu 오일러각, 가속도값 3개 출력 아두이노 기본 코드
2022-11-02 EBimu 오일러각도, 가속도값 출력 (Serial)
2022-11-02 EBimu 값 rosserial /imu_data 로 publish 수정전
    [ebimu_rosserial.ino]
2022-11-02 4차발표 코드 , /cmd_vel sub /imu pub , theta pub넣기전
2022-11-02 일반 모터드라이버 DC모터2개 rosserial
2022-11-02 3차, 4차 아두이노 코드 (10~11월)
2022-11-02 ~9월 코드
2022-11-02 A팀 참고 발표자료
2022-11-02 2021년 캡스톤디자인 참고자료
2022-11-02 우분투 설치 사이트 주소
2022-11-02 ros key 입력 받을 시 1ms직진, 회전 코드 (짐벌X)
2022-11-02 4차발표 key입력 파이썬 노드
2022-11-02 키명령받아서 Stabil로 roll, pitch, theta publish
2022-11-02 짐벌 serial_node2
2022-11-02 DC_PID_Stabil Original코드
2022-11-02 Stabil로 롤,피치,세타 publish(짐벌 O)
2022-11-02 roll,pitch,theta값 subscribe해서 짐벌 기능
2022-11-02 진짜 3차발표 코드!!!!!!!!!
2022-11-02 11월 03일 00:05분 저장
2022-11-02 11월 03일 03:17분 저장
2022-11-02 Serial_node2 11월 03일 03:18분 저장
2022-11-24 4차발표 AGV코드
2022-11-24 4차발표Stabil코드
2022-11-24 4차발표 Stabilizer코드
2022-11-24 Create 4차발표 ROS 구동 가이드
2022-11-24 4차발표 메인 노드
2022-11-24 4차 발표 launch파일
2023-04-06 설계팀 가이드용
2023-04-06 Create 참고사이트
2023-04-06 Create 최종 유튜브 제출 발표영상
2023-04-06 최종 노드 Rqt_graph
2023-04-06 최종논문, 최종보고서
2023-04-06 4차발표 코드
